ChipDesign111/chip_design/sw/README.md

# CPU 软件

[include/](include/README.md)、[drivers/](drivers/README.md)、[tests/](tests/README.md)、[startup/](startup/README.md)。
计划建立裸机构建与驱动：C/汇编→ELF→map/反汇编→hex→SoC。
原 Lab 预编译程序不等于自主软件已有构建链。关注 [存储预算](../docs/memory-budget.md)。
