ChipDesign111/chip_design/report/architecture.md

# 架构与数据流

my_soc_top 顶层仍为 clk_i、rst_ni、tck_i、tms_i、td_i、td_o 六个端口。CPU 指令、CPU 数据、Debug SBA、DMA 是四个 AXI 发起端；Boot、主 SRAM、Debug 映射、NPU 是四个目标端。保留完整 CPU 和调试互连。

CPU 指令端增加四条、每条八个 32-bit 字的取指缓存，数据容量共 128 B。缓存命中时当拍授权、下一周期返回；未命中通过 AXI INCR burst 填充，并预取下一条。仅物理 8 KiB SRAM 和 32 B 不可变 Boot 跳板允许缓存，Debug、Boot 状态寄存器等使用精确字地址的单次读取。SRAM 实际非零字节写入只撤销匹配的物理指令行（含地址别名），Boot 写入仍全局撤销；已发出的匹配填充事务继续排空，避免重装程序后使用旧指令。数据阵列不复位，valid、填充长度和输出仍复位，只有成功填充的字可返回。CPU 核本身未修改。

主 SRAM 8 KiB 保存程序、两层权重和工作数据。NPU 的配置寄存器保存最多 4 个输入、偏置和量化系数。开始一批后，硬件 DMA 自动读取第一层 32 个 tile，每块两列输入对应 32 个输出的权重；每块依次用于本批全部样本后才替换。第一层完成后用一个共享重定标器依次产生全部样本的隐藏值。第二层按每组 8 个逻辑 tile、48 B 有效权重打包，共 4 次粗粒度 DMA；核心仍按 32 个逻辑 tile 计算，内部产生每样本六个 INT22 分数和最大值下标，MMIO 再符号扩展为 32 位。

两个 64B bank 交替：一个计算、一个 DMA 写。DMA 用两字 FIFO 让读与写独立流动。为使短 MAC 发射段与真实传输重叠，下一块开始写入时再发射当前块；最后一个样本发射时立即释放当前 bank，下一 bank 已就绪则直接进入下一 tile，不经过固定 `DRAIN` 气泡。W1 tile31 仍占用一个 bank 时，另一个空闲 bank 开始预取 W2 组，因此 W2 首批传输藏在 W1 尾部和 requant 期间。没有增加空乘法器、复制整套权重或新增 NPU 内部 SRAM。

NPU 的真实执行周期受 AXI 仲裁与背压影响，读取计数寄存器获得；每样本 FC1/FC2 分别为 128/16 个 MAC 发射周期。启动保护默认关闭普通固件取指，完整镜像覆盖和密钥提交后放行；调试请求仍可在无镜像时进入 Debug 区域。细节见 [SRAM](sram.md)。

当前源码保留 AXI 交叉开关的 `CUT_SLV_AX` 地址通道边界及 `FallThrough=0`，用于控制 CPU 到 NPU 的组合路径。FPGA 工程已加入取指模块，但已有 bitstream 和历史 ASIC 物理结果不代表本次集成版本；需要从当前源码重新构建、实现和验证。
