ChipDesign111/chip_design/report/dma.md

# 权重 tile DMA

har_dma 是 AXI4 增量突发引擎；har_dma_axi 仅适配总线元数据。读 SRAM、写 NPU tile 窗口，AW/AR 独立握手，两字 FIFO 对读写速度差提供背压，不再先缓存完整 16 字突发才写。每次突发最多 16 字，跨 4KiB 边界自动拆分。 最后一拍 W 已接受且 R 已完成后即可接收 B 响应；完成和错误状态仍以真实 B 握手为准，省去额外 RESP 等待。32 字多次突发和跨 4 KiB 的 4+12 字拆分已加入定向回归。

NPU 发出自动描述符：第一层 src=W1_BASE+tile×64、len=16 字，共 32 次；第二层把 8 行、每行 6 个输出的权重连续打包为 48 B，src=W2_BASE+group×48、len=12 字，共 4 次；dst=0x70000100+bank×64。目的 bank 必须空闲。FC2 每个物理包直接供共享 MAC bank 完成 8×6 个乘积，不再是 8 个独立计算 tile。完整一批传输 2048+192=2240B，不因 batch=1/2/4 重复装多遍。下一批重新从 SRAM 装入，可由软件在批次间更新模型。

在本批所有样本用完当前 tile 前不会释放它。最后一个样本发射时产生消费脉冲；下一 bank 已发布时核心直接交接，没有固定空拍。另一 bank 预取可与 MAC 并行。W1 tile31 开始计算后，已释放的 bank 立即预取第一个 W2 组；W1 最后 bank 消费后预取第二个 W2 组，两者均可在 256 拍 requant 期间完成发布。块发布要同时满足预期字全部收到、DMA 完成且无错误。读响应错误、写响应错误、RLAST 不符都记错误，失败数据不发布。提前 RLAST 时用零补齐已发写突发后失败，避免破坏 AXI 已接收的写事务。真实 AXI 对端仍必须最终响应；硬件不臆造失联对端的完成信号。

调试 CSR 以 NPU+0xd00 为基准：0 控制 START/ACK，4 DONE/BUSY/ERROR，8 源地址，12 目的地址，16 字数，20 周期，24 已复制字数，28 错误码。CPU 手工 DMA 只允许 NPU 空闲；正常推理由自动描述符驱动。

当前完整 SoC RTL 测试观测到实际读/MAC 重叠 280 拍、写/MAC 重叠 280 拍。计数只统计总线完成握手且乘积有效的同拍，不把 BUSY 期间都当计算并行。
