ChipDesign111/chip_design/report/npu.md

# NPU 计算与缓冲

har_npu_core 第一层有 32 组、每组 2 个有符号 8×8 乘法器；第二层有 6 组、每组 1 个，共 70 个。当前优化版在一个 ISSUE 周期中完成乘法并写入 INT32 累加器，省去 1120 位乘积流水寄存器；目标 20 ns 是否满足由综合与布线后时序检验。样本数 1 或 2；同一权重块先用于样本 0，再用于样本 1，最后一个乘积累加完成才释放该块。

第一层总和经 ReLU（负数变零），乘 MULT 并按 SHIFT 舍入，再饱和到 0..127。一个共享 32×16 重定标乘法器依次完成 32 个隐藏结果。第二层保持有符号分数，Argmax 平局取最小下标。算术定义见 [数值契约](../model/numerics.md)。

har_weight_store 仅保存两个 64B 缓冲；simple_npu_top 检查 DMA 完整字掩码和成功响应，才将缓冲发布给计算。写入有效 bank 被拒绝；CPU 在计算或 DMA 忙时修改配置会置错误。层切换、重新开始和复位撤销旧有效标志。数据数组无复位，控制有效位保证不消费未初始化数据。

当前功能回归使用 [run.py](../test/int8/run.py)；随机数据和训练模型均逐值核对隐藏层、六个分数和类别。测试输出在本地忽略目录，不把旧版 39/59 周期或 38-bank 综合结论套到本实现。
