ChipDesign111/chip_design/reports/README.md

# 团队结果

当前无功能验证或 PPA 报告。每份正式结果包含 commit、模型/向量版本、工具、配置、命令、结果与限制。
个人已有报告仅是参考，不能作为共有代码的结果。完整波形和数据库不提交。
