ChipDesign111/chip_design/LICENSES/README.md

# Licensing inventory

许可证按组件管理，源文件声明优先。工程整理不会为第三方文件、模型产物或未明确授权的原创代码补写统一的宽松授权。

现有来源清单见 [THIRD_PARTY_NOTICES](../THIRD_PARTY_NOTICES.md)。平台文件保留原版权/许可头；数据固定样例保留引用与许可标记。仓库尚无所有原创文件的统一许可证决定，正式分发前需要补全该项。

添加许可证正文时应使用对应权利人的正式文本，标识其覆盖文件范围；不使用一个根目录 LICENSE 覆盖全部混合来源文件。
