ChipDesign111/chip_design/docs/ai-log/README.md

# AI 使用记录

每次影响设计的 AI 工作保存一份 Markdown：
日期、任务、使用的工具/模型、允许提供的输入、生成内容、人工修改、修改理由、验证命令、结果、关联 commit/PR。

记录方法学和关键改动，不把个人聊天历史整包上传。
禁止 AI 接触课程服务器 PDK、标准单元库等敏感内容。
初始仓库架构与计划由 AI 根据用户授权整理，当前只完成仓库结构和文档检查，未生成已验证芯片实现。
