ChipDesign111/chip_design/docs/weekly/README.md

# 每周共同验收

每周复制 [template.md](template.md)，按周次或实际日期命名。状态只填写已提供证据的结果，未执行项保留待办。
