ChipDesign111/chip_design/sw/include/README.md

# 软件公共接口

计划放寄存器常量、打包方法、驱动声明和类别映射。以 docs/mmio.md 和 model 输出为依据，避免三处地址不一致。
