ChipDesign111/chip_design/report/system_reset_boundary.md

# 系统复位边界修复

be4a7fc已实测消除Wire Bond 9条，但TT后仿仍有两条最终复位违规。原输入SHA保持不变的被动探针复现了相同事件。

19.85ns复位相位中，ndmreset_n于238905.903ns下降，AXI r_ready于238910.355ns下降；仍处READ状态的桥随之重新拉高req，主存D于238911.655ns上升，仅领先CP238911.659ns 4ps，小于10ps。
2ns相位中，ndmreset_n于238888.053ns下降，上游AR地址随后异步清除，req_addr[31]的D于238891.678ns下降，仅落后CP238891.643ns 35ps，小于77ps。共享SRAM复位直到238921.873ns才下降。
因此问题是生产端先复位、接收端仍活动的窗口，不能当成普通同步短路径加延迟解决。

用户已明确允许把最多两个下降沿的复位识别延迟扩展到CPU/AXI/NPU系统时钟域，要求时钟运行，保留独立JTAG TAP复位。
新实现先对外部POR与NDM请求分别作两级下降沿采样；POR和功能复位同步器在下降沿释放。POR断言来自已采样的下降沿请求，NDM断言也来自同样边界。
功能ndmreset_n同时控制CPU、AXI、NPU和SRAM桥/命令寄存器，不再只给SRAM接收端增加两拍。JTAG TAP的trst_ni仍直接使用外部复位，NDM不清除独立POR/debug域。
已接受的SRAM载荷不异步清除，上一上升沿接受的操作在随后的下降沿完成一次；新请求在共同复位后停止。

44组数据用例和完整SoC通过；新增完整SoC复位契约测试覆盖80个POR相位和80个NDM相位，验证两下降沿内生效、共同边界、启动保护及独立debug域。
原生SRAM时序检查开启的16个原始完整SoC复位相位全部通过，原生产SDF激励未改。便携/原生两模型各80相位320场景均为642次接受=642次实际写。
首次功能回归的旧“1ns立即断言”断言按用户批准的两下降沿接口契约更新，未改SDF激励或关闭时序检查。
75项硬件来源SHA检查继续执行，SoC原始/上游SHA保留，当前改动在integration override中解释。[功能证据](functional_validation.json)单列当前RTL，旧物理结果不用于验证它。

## 新版最终验证

dea5584已以干净源完成新Genus和34步物理实现，环境/EDA/整理/入口退出码全部0；917项回传SHA核验。综合68,703单元，cell面积2,064,513.940 µm²，含SRAM401,443.591 µm²。含PAD Die3.7956390976 mm²，原生Density75.129%。

TT静态Setup/Hold为+3.825/+0.115 ns。新TT17用例功能全过，绑定错误/缺失/全部阶段动态违规/负IOPATH截零均0。原先两条复位事件所处相位保留，未改生产激励、SDF、模型或检查。相同最终DB的多角最差SRAM输入半周期Setup/Hold为+1.951/+9.935 ns，输出+0.367/+10.879 ns（Setup取SS、Hold取FF−40，不作为TT专属数值）；共享功能复位至port_req_q/D为+6.714/+11.064 ns，报告含真实下降沿发射/上升沿采样及传播时钟。

新同源Lab5完成，WB64项0违规、最终天线0、完整LVS正确；课程DRC残项和按原生IO/外环几何核对的ERC残项保留，不称ERC Clean或完整代工厂签核。本轮只跑TT SDF；独立main RTL、Dummy后STA、IR/EM等没有因此被验证。

[完整最终结果及SHA来源](../eda/results/system_reset_unified_20261113/README.md)。20ns、3.8mm²与原生电气/几何规则保持。有限相位测试及静态分析不等于所有异步相位的亚稳态证明。

## 主线核心整合后的复核

main266bca3的16-MAC/INT22核心已经与本修复整合，并恢复main原生门控/使能与medium综合。新287ae40实际含443个自动门控及3282个受控FF，TT16个SDF用例的全部阶段动态违规0；不再靠禁用全部该类单元实现过关。原始模型、notifier与检查保留。[最终整合结果](../eda/results/main_266bca3_integration_20261113/README.md)。旧dea5584结果仍绑定其历史源码。
