ChipDesign111/chip_design/report/quality_followup.md

# 正常条件下的EDA与后仿修复结果

2026-10-27，物理输入4427c4b完成同源34步及环境/EDA/整理，均退出0；含PAD整颗3.7956390976mm²，20ns，四个匹配库角最差Setup/Hold+0.001/+0.020ns，TNS/违规路径0。随后415a43c运行脚本从同一物理输入完成TT、FF−40快角、SS125慢角三组17例后仿，各组功能、绑定和全阶段动态时序通过。报告及来源见[最终结果](../eda/results/native_mux_dff_20261027/README.md)。main仍d40b217，本轮后续提交仅在xzx。

## 验收范围

采用用户确认的[正常条件](../eda/docs/验收条件.md)：保留20ns、含PAD≤3.8mm²、四个匹配STD/IO/SRAM库角；Setup/Hold WNS≥0、TNS及违规路径0。遵守原生Liberty和讲义原SDC，正常default DRC、真实信号/核心供电连通、天线及交付复核。100ps Hold、120ps目标、200ps Setup、设计级人为边沿、逐引脚门禁、83/85分预算和手写扇出ECO已移除，没有重新引入。

## 为什么功能通过仍需要修复

RTL描述每个时钟边沿应该保存什么值，综合器决定用哪些实际单元实现。条件保持可以实现成独立时钟门控、带E使能触发器、借用SE扫描选择的触发器，或者普通DFF前的数据选择器。前几类的控制脚有独立setuphold检查；复位在周期中途改变使能时，可能数值计算仍通过，但控制脚已违反器件时序。

| 实现 | 实测结果 | 原因与处理 |
| --- | --- | --- |
| main对应5191064 | 原TT功能/静态/SDF通过 | 保留单TT基线，不能替代后来的四角实现 |
| 5b60015 | 四角静态通过，TT有6条最终复位事件 | Genus自动插入ICG的使能违规；新版本关闭自动门控 |
| cbf40f2 | 四角静态通过，TT仍有30条最终复位事件 | 26条主SRAM载荷E检查、4条字节写使能SE检查；禁独立ICG不足以禁库内控制结构 |
| 4ea3f0c | 实际仍有7405个EDF，所选mux_dff未生效；入口退出1 | 初始化前约束漏掉init_design后建立的MMMC库对象；未运行新SDF，完整目录转历史保存 |
| 4427c4b | 实际受控触发器0、自动门控0；三种SDF动态事件0 | init_design后重施原有映射，实际生成普通DFF加数据选择器，再独立完整重跑 |

本轮没有修改91项功能RTL，没有换掉原生STD/IO模型，没有修改SDF数值、屏蔽notifier、增加假路径或放宽周期/面积。寄存器映射策略在综合和后端统一应用，综合后核对实际网表；属性读回或小例成功不能代替完整SoC结果。

## 当前结果与限制

实际逻辑密度74.138%，综合单元面积2039855.258µm²含SRAM401443.591µm²。外框仍1948.24µm见方；规划/优化预算85%是参数，Filler后的100%不是逻辑密度。禁止门控可能增加时钟功耗，未做相同活动输入功耗比较，不宣称功耗改善。

同数据库SRAM半周期输入Setup/Hold+2.044/+9.876ns、输出+0.176/+10.917ns，传播反相时钟和0/10/20ns采样关系保留。三种后仿全程时序检查开启；TT负IOPATH截零18条、快角438条、慢角0条，快角另34条ANIOD消息，均单列工具限制。正常验收通过不表示完整延时无损或任意异步复位波形绝对安全。

核心物理852项和后仿67/67/76项已整包及逐文件SHA核验回传lab4新目录，大视图和授权模型仍在服务器。独立工艺DRC/LVS、完整RCmin/max、SI、IR/EM/ESD、形式等价未执行，不新增为本次教学门槛，也不冒称签核。所有开发自检和临时诊断工具仅在本地archives。

最新操作从[压缩上传到结果查看](../eda/README.md)和[后仿指南](../eda/docs/后仿真操作指南.md)开始；历史失败依据分别保留在[cbf结果](../eda/results/native_cbf40f2_20261027/README.md)及服务器history。不同版本未复用冻结work或拼接检查点。
