ChipDesign111/chip_design/docs/backlog.md

# 初始待办清单

当前条目未执行，不预分配成员。可逐项转换为 GitHub Issue，使用仓库任务模板。

| ID | 优先级 | 工作 | 前置依赖 | 验收 |
| --- | --- | --- | --- | --- |
| B01 | P0 | 加入四位成员、设置权限 | 真实账号 | 每人可克隆、提 PR |
| B02 | P0 | 确认官方模板公开共享范围 | 课程通知 | 来源与准入记录 |
| B03 | P0 | 导入共同平台源码与原测试 | B02 | 来源/许可证/校验明确 |
| B04 | P0 | 构建、仿真入口及 filelist | B03 | 从干净克隆运行 |
| B05 | P0 | 原平台回归与第二环境复现 | B04 | 共同平台验证摘要 |
| B06 | P0 | 数据/权重/64 特征与标签确认 | 课程资料 | 数据契约完整 |
| B07 | P0 | 浮点及整数参考、量化导出 | B06 | 可复现输出与准确率 |
| B08 | P0 | 评审规格、数值和 MMIO | B03,B07 | 文档冻结并记版本 |
| B09 | P0 | RISC-V 裸机编译与 hex 转换 | B03 | 简单程序端到端 |
| B10 | P1 | 有符号 MAC、偏置 | B08 | 边界和随机一致 |
| B11 | P1 | ReLU/量化、Argmax | B08 | 边界和平局一致 |
| B12 | P1 | 第一层和本地存储 | B10,B11 | 32 个中间值一致 |
| B13 | P1 | 第二层与完整控制 | B12 | 六个得分/类别一致 |
| B14 | P1 | MMIO 与驱动 | B08,B09 | 状态/数据读写一致 |
| B15 | P1 | CPU 驱动完整 SoC | B13,B14 | 连续推理端到端通过 |
| B16 | P1 | 早期综合与资源评估 | B12，课程工具 | 面积/存储/路径报告 |
| B17 | P1 | FPGA 适配与板级验证 | B15，Lab 6 | 真实样本上板一致 |
| B18 | P1 | 自主综合及布局布线 | B15,B16，Lab 4 | 完整实现及问题清单 |
| B19 | P1 | 优化、回归与签核 | B18，Lab 5 | 满足正式约束 |
| B20 | P1 | 评审、合版、GDS 与归档 | B17,B19 | 版本一致、问题关闭 |
| B21 | P2 | 四路并行方案 | 正确 V1 和实际瓶颈 | 收益有证据，回归通过 |

P0 为前置条件，P1 为交付主线，P2 为有余量时的优化。B02 未完成前，只协作原创文档和自有代码。
