ChipDesign111/chip_design/docs/decisions.md

# 决策与待确认事项

## 当前共同方向

| 编号 | 决策 | 状态 |
| --- | --- | --- |
| D01 | 使用 ChipDesign111/chip_design 为共有仓库 | 用户已确定 |
| D02 | 共有工程独立于个人 Lab，成果通过 PR 进入 | 用户已确定 |
| D03 | 人体活动识别，64→32→6 MLP | 根据已选场景，待正式项目公告核对 |
| D04 | 首版接收预处理特征，CPU 通过 MMIO 控制 | 建议，待评审 |
| D05 | 一个 MAC 的完整 V1，优化后再考虑四路 | 建议，待评审 |
| D06 | INT8/INT32 和 MMIO 窗口 | 草案，待参考模型及接口评审 |
| D07 | 当前不固定四人工作分配 | 用户已确定 |

## 阻塞功能开发的前置问题

- 数据、特征和权重是否由课程提供？
- 类别编号、归一化、量化规则是什么？
- 平台官方代码是否允许进入当前公开仓库？
- 四人课程登记、最终评分和截止是什么？
- FPGA、频率、I/O、存储宏和合版边界是什么？

## 决策记录格式

日期 / 提案 / 影响模块 / 证据 / 结论 / 替代方案 / 对应 PR。
接口冻结后更改必须给出迁移和验证方案。
