ChipDesign111/chip_design/docs/sources.md

# 来源与准入记录

核对日期：2026-10-08。

| 来源 | 用途 | 当前状态 |
| --- | --- | --- |
| [课程主页](https://full-stack-ai-chip.tianyuj.com/) | 发布状态和通知优先级 | 已核对 |
| [Lab 3](https://full-stack-ai-chip.tianyuj.com/lab-3/) | 共有平台的结构和仿真方法参考 | 已核对，尚未导入原包 |
| [Final Project](https://full-stack-ai-chip.tianyuj.com/final-project/) | 自主项目正式要求 | 尚未发布 |
| 课堂讲义《先进芯片全栈设计与实践（1）》第 18、19、26–28 页 | 暂定周次、流程和场景 4 | 根据提供内容制定计划，未上传 PDF |
| 成员个人 Lab | 学习和候选贡献 | 不自动导入，不作为共有 PASS |

网站显示 Lab 4–6 和 Final Project 尚未发布。后续以最新课程通知更新计划，当前不推断最终评分、板卡或频率。

## 源码准入模板

每项引入记录：名称、来源 URL/版本、获取日期、允许共享范围、原许可证、修改内容、文件校验值、验证入口、对应 PR。

课程文件名用于辨认结构，并不证明可以公开转载。本仓库初始内容是原创架构文档和工具，没有课程源码、个人报告、完整数据集或受限工艺文件。
