ChipDesign111/chip_design/eda/docs/Lab5操作指南.md

# Lab5：完整工程部署、仅执行新增物理检查

完整源包始终包含 RTL、综合、Innovus 01–34、TT 后仿和 Lab5 程序。workflow.json 定义各阶段必备文件，打包时逐项检查并记录 SHA；文件齐全不代表检查通过。

## 一键运行

```powershell
python eda/pipeline.py run --output C:/Users/zixiang/OneDrive/Desktop/advanced_chip_study/lab5/完整新流程目录
python eda/pipeline.py run --only lab5 --eda-upload /home/s2400011041/Desktop/fullstack_chipdesign/uploads/20261113_220745_287ae40 --output C:/Users/zixiang/OneDrive/Desktop/advanced_chip_study/lab5/仅Lab5新目录
python eda/signoff.py run --eda-upload /home/s2400011041/Desktop/fullstack_chipdesign/uploads/20261113_220745_287ae40 --output C:/Users/zixiang/OneDrive/Desktop/advanced_chip_study/lab5/本次新目录
```

pipeline默认依次执行RTL检查/SoC回归、综合与01–34、TT后仿及同数据库半周期STA、Lab5；--only lab5只调用最后一段。
`--start-at implementation`只省略命令内的RTL回归，保留来源检查并从全新Genus开始；若RTL已改，必须先完成并记录与该版本硬件SHA一致的功能/复位回归。本轮dea5584已在部署前完成对应回归，不能把此选项当作免验证。
2026-11-13最新版dea5584已完成新综合、01–34、TT后仿、同DB补充STA及Lab5；前版be4a7fc的两条TT复位事件单列为历史失败。

完整上传、公共unpack.sh校验解压后，只启动Lab5，不调用原run_all.sh重跑综合和布局布线。
run --detach只启动；status查状态；fetch --wait --output 新目录等待并校验回传。
--upload显式选择Lab5版本，eda/dist/last_lab5.json只保存本地最近位置。

## 本地/服务器分工

本地仓库维护正式程序、配置和文档；eda/dist保存忽略的部署包；工作区lab5保存核验后小报告；开发试验只在archives。
服务器每轮独立建立uploads/时间_lab5_提交/soc-stu/layout，从/lec/lab5/layout复制课程工程并记录所有原文件SHA。
deploy为完整冻结源码；lab5/config.json为冻结配置；lab5/inputs为原物理输入副本；lab5/evidence为命令、原始日志、摘要和SHA。
soc-stu/layout/workspace保存私有OA、GDS及检查数据库；results保存结果和回传包。原物理work及共享PDK保持只读。
规则、授权模型、大GDS/CDL、OA、SVDB不入Git。物理源码提交与本轮程序提交分别记录。

## 执行和真实结果

核对物理34步/三阶段0、相同RTL、完整包SHA、GDS层次，执行原生V2LVS。
随后私有preDummy装配、OA导入、preDummy DRC、两种Dummy、合并、最终OA导入、DRC、LVS/ERC、天线及WB串行执行。
几何自动化读取原生GDS中的edge/corner按1µm节距装配，不缩放、不flatten功能子层次，记录原生子单元元素计数。
按DEF测量尺寸并单列最终含环外框；POC锚点需在实际PVDD2CDG M3导体内。实现及解析必须经实际工具运行验证。
服务器依赖项目tools/lab5_python中的Python3.12、gdstk0.9.61、numpy2.2.6；原生Calibre/Virtuoso环境照常使用。
家目录含运行环境和预计产物须低于20,000,000,000字节，重任务串行，保留最新有效物理与TT结果。

## 教学例外

依据 https://full-stack-ai-chip.tianyuj.com/lab-5/ 保留原始DRC报告，单列DRM/ESD/MOM/LUP四类。
ERC不能按名字全部忽略，需核对实际IO保护电路或外环对象；核心浮井、真实开短路须修复。
`erc_review.json`核对原生结果总数、全部代表标记和最终GDS：mnpg标记须完整位于原生PVDD保护PAD内，nxwell/npvss49须完整位于PVSS1CDG内，外环psub须与实测环边界一致。
只将匹配的课程残项单列为`accepted_course_residuals`，保留原始计数和`erc_clean=false`；未知规则、标记不完整或核心标记均失败。这不是代工厂正式豁免。
PR先保留原始容差，确认实测偏差与教程同类后才采用有依据的教学设置。不新增SRAM Box、虚连或假标签。
converted、executed_review_required、review_required均非通过。报告解析不完整、几何需修正或ERC未审阅均非零退出并回传依据。
最终检查绑定同一SHA最终GDS/CDL。Dummy后寄生/STA、IR/EM及封装人工规则未做分别列未做。

## 回传

成功或失败均生成小包；本地校验包及逐文件SHA生成receipt.json。代码/配置修改必须新部署，不覆盖冻结任务。
最终验收后清理可再生成临时文件；结果说明更新eda/results及服务器入口，只推送xzx、不自动合并main。

2026-11-12实测见[Lab5结果](../results/lab5_20261112/README.md)：本轮完整部署、只跑Lab5，课程DRC/完整LVS/最终天线满足对应要求，原始PNR已有的WB9处仍未通过。中间失败版本已回传留证并清理，服务器保留最新相关物理、TT和Lab5三个目录。

最新版：[统一系统复位与Wire Bond最终结果](../results/system_reset_unified_20261113/README.md)。服务器入口README链接最新三个关联目录；Virtuoso最终版图位于最新Lab5的soc-stu/layout/workspace，库my_soc_top_final、单元my_soc_top_postDummy、视图layout。

当前最终版本：[main266bca3核心完整整合](../results/main_266bca3_integration_20261113/README.md)，物理287ae40、TT225252及Lab5225800同源验证。前述dea5584和2026-11-12记录仅作历史说明，不恢复已清理上传。

已有完整SoC回归可用`--rtl-regression-result 路径/result.json`；pipeline会核对完整RTL/test清单与每个SHA后复用，否则拒绝。默认仍重新执行回归，不豁免任何实现或后仿阶段。
