ChipDesign111/chip_design/eda/docs/实施与适配说明.md

# INT8 SoC 实施与适配

当前基线来自更新后的 main 267c873，活动分支 xzx。旧 xzx/rtl 的历史、未提交文档、RTL 和部分 EDA 结果已归档到本地工作区；不会放进本分支当作另一份实现。

## 计算与存储

网络为 64 输入、32 隐藏、6 类。设计实现 16 个 8×8 有符号乘法器。第一层分四个相位，每个相位用 2 条输入通道并行更新 8 个输出；第二层复用同一 bank，每次用 12 个乘法器并行更新 6 个输出。FC1 有 32 个物理 tile，FC2 有 4 个 48B 物理包。INT8 指输入、权重、隐藏激活；偏置、累加器和内部最终分数保持 INT22，MMIO 分数再符号扩展为 INT32，避免乘积求和被截成 8 位。

主 SRAM 是一个 8 KiB 原生硬宏，权重全部放在这里。第一层按 [32个输入对][32个输出][2个字节] 排列，共 2048B；第二层按 [32个输入][6个输出+2个零填充] 排列，共 256B。填充只为 32 位 DMA 对齐，不增加计算单元。

NPU 只有两个 64B tile 缓冲：当前 bank 供本批最多四个样本计算，最后一个样本发射时释放。另一 bank 由 DMA 写入；成功读写且收到全部预期字后才标记可用。FC1 和 FC2 的发布状态分开保存，因此 W1 尾部可以预取 W2，层切换不会丢弃提前完成的 W2 bank。DMA 为两字 FIFO，读、写通道独立推进，支持 AXI 背压；错误的读响应或 RLAST 使当前块失败，不发布半块数据。

批次最多四个样本，第一层和第二层分别按 tile 重用权重；FC2 每 8 个逻辑 tile 打包为 48B，W2 共 4 次 DMA。不保留旧版 38 个常驻权重 bank，也不保留 32 个并行重定标器；重定标器一个，依次处理各隐藏结果。双缓冲和打包不会消除主 SRAM 的 32bit/拍带宽瓶颈，实测周期应从寄存器和仿真取值。

## 改什么与固定什么

| 需求 | 修改位置与原因 |
| --- | --- |
| 仅换同形状模型 | 重新量化、按上述 tile 顺序打包权重；设置 SRAM 基址、MULT/SHIFT、偏置和输入，不改 RTL |
| 改网络形状、并行度或批次上限 | har_npu_core、simple_npu_top、权重布局/固件/参考模型一起改，重做功能和物理验证 |
| 改宏型号/容量 | memory 适配、filelist、宏逻辑/物理视图、宏坐标/供电规划和库清单一起改 |
| 改周期、核数、面积规划 | 第一次 check_env 前编辑本版本 configs/design.json；修改后新上传 |
| 允许优化器增加修复单元 | optimizer_max_density=0.85，统一传入原生优化器；这是优化预算，不是最终实测利用率 |
| 优化TT负IOPATH | combinational_cell_mapping=tt_nonnegative_tables，从未修改的原生TT库派生组合单元选择；Genus和Innovus统一应用，时钟反相使用原生CKND系列；最终仍须检查真实SDF |
| 增加慢角余量 | implementation_effort=high提高优化力度，setup_optimization_goal_ns=0.3给原生优化器软目标；不是最低余量验收门槛，最终仍按Setup/Hold≥0及零违规 |
| 为天线二极管预留扇出负载 | antenna_fanout_reserve=1：原生优化时逻辑目标15，布线前全设计DRV修复；每次优化后恢复原SDC16，最终检查/导出仍按16及原生天线规则 |
| 减少天线修复增加的负载 | antenna_repair_strategy=native_jumpers_first：先原生跨层跳接，仅对独立报告残项使用二极管回退；最终天线/扇出/DRC/STA仍全部复核 |
| 改顶层端口 | IO 计划、PAD 接线、SDC、物理端口及所有计数检查一起适配 |

本版io_plan.json的master字段明确PAD类型：输入PDDW0204CDG，TDO输出PDDW1216CDG。两者同为60×115µm且引脚几何、四库角逻辑相匹配，后者在当前外部连接上有更快边沿。更换PAD会改变门级时序和原生GDS引用，必须新上传、完整物理实现并用对应新SDF验证。不能只改网表字符串沿用旧SDF。

| 正常重复部署 | package_server.py、remote.py、unpack.sh、三个阶段和结果抓取程序可固定使用 |
| 正常重复实现 | 01–34 阶段控制可固定；从当前报告提取扇出/天线/时序修复对象，不能固定旧网名或旧余量 |

## 启动与复位

ASIC 上电后 SRAM 无初始化内容。CPU fetch_enable 由 boot_ready 控制，默认关闭；调试模块仍可通过 AXI 装载。装载者从 0x80000000 起按顺序写满 2048 个完整 32 位字，读回校验后，在 0x0001003c 写 0xb007c0de。硬件确认完整覆盖，再等 5 个时钟边沿才放行 CPU；CPU 从不可写的 BootRAM 跳板进入 SRAM。

乱序末字、部分 byte 写、仅写密钥、部分镜像均不构成完整覆盖。在 0x0001003c 写 0 可撤销启动并开始新镜像覆盖；安全重新装载应先通过调试接口停机或系统复位，不能把撤销 fetch_enable 当作已经运行 CPU 的硬复位。全局复位或 ndmreset 会清除启动许可，ASIC 需要重新完整装载。

复位采用异步断言、同步释放：POR/调试系统域四级，再到功能 SoC 四级。JTAG TAP 的复位保持在 TCK 域的原接口。非空 FPGA_INIT_FILE 表示 FPGA BRAM 在配置时预装载，该编译路径自动等待后放行；ASIC 默认空串，不能依赖仿真预装载。

## 面积与签核范围

3.8 mm² 指最外层 Die，包括 PAD；正方形边长上限约 1949.36 μm。默认请求1648 μm核心和四侧150 μm余量，即1948 μm外框，工具对齐后的实际 geometry、DEF/LEF/GDS 必须一致。综合单元面积、核心面积和整个 Die 是不同量。脚本先检查规划容积，再检查实际外框，不会为了通过把单元面积冒充整颗面积。

main的已验证结果采用TT 1.8V/25°C、50MHz，并有对应SDF动态检查。当前xzx同时优化TT25、SS125、FF0、FF−40匹配库角，仍在验证。完整导出不等于完成独立foundry DRC/LVS、多RC角或新版SDF后仿；各完成状态要从同一版本的真实证据分别判断。

验收使用native_library_zero_slack：保留四个匹配库角、系统20ns、含PAD整颗≤3.8mm²。最终Setup/Hold均要求WNS≥0、TNS=0、违规路径数=0，电气检查遵守原生Liberty及讲义原SDC；不增加设计级边沿限制。default DRC、真实信号/核心供电连通及天线须通过，IO抽象限制按同源原生几何证据记录。只在真实负余量时修复Hold：先0目标，仍有残项时按讲义尝试0.02ns优化目标；0.02ns不是验收门槛。普通优化密度上限统一0.85，不再分83%/85%预算。详见[验收条件](验收条件.md)。

移植SRAM端口时，AXI SRAM桥与my_mainmem须使用同一个sram_transaction_reset输出，SRAM桥QUIET_ON_RESET=1；裸异步根复位继续用于原CPU/调试域，不单独直通主存请求D。保持时钟运行及至少两个下降沿的根复位保持。新增模块已进入RTL文件表、内存源清单和FPGA工程源清单；完整物理及SDF必须使用对应新源码重新生成。
