ChipDesign111/chip_design/eda/docs/讲义34步与文件对照.md

# 讲义34步：每步的动作、文件与效果

本篇是[操作指南](操作指南.md)的后端查阅附录。先按主指南完成部署、prepare、doctor和综合，再选择“分段运行”；不要先运行完整all后，再从01把本篇命令全部执行一次。

这里的命令都在服务器Bash运行，沿用主指南保存的`EDA_WORK`，当前目录为`EDA_DEPLOY`。所有相对文件路径以本轮`$EDA_WORK/`为根；`flow/`是prepare冻结的控制程序，`pnr/generated/`是根据实际几何生成的Tcl。步骤用到的源模板为`flow/tcl/steps/`下对应编号片段，实际执行正文保存在`evidence/commands/步骤号/`。这些Tcl由入口调用，不需要你另开工具手工source。

`--until N`表示从最后通过点连续运行到N。每步Tcl和自动审计通过后保存`evidence/step_NN.json`并推进`evidence/last_step.txt`；`.enc`加载脚本及`.enc.dat`数据库必须成套保留。部分阶段JSON只列少量自动检查，具体范围结合Tcl保护、日志和本步说明阅读。

最终报告路径、字段含义和异常分析方法见[报告查找与分析](报告查找与分析.md)。下文的“预期”不是本轮实测值。

## 01．导入新门级设计

**用到的文件：** `config/global_define.tcl、pnr/scripts/pnr_mmmc.tcl、syn/my_soc_top/my_soc_top_postsyn.v`。分别提供工艺路径、分析模型与综合后的单元连接；flow/tcl/driver.tcl负责导入。

**在干什么：** 读入新版SoC网表、库外形与时间模型，并查找唯一主SRAM。

**为什么要做：** 网表只写连接，库资料才给出实际器件；先排除旧网表、缺模型和选错宏。

**有什么效果：** 设计名my_soc_top，主SRAM恰好一个，记录综合后真实实例路径。

**关键参数：** 顶层固定为my_soc_top，宏型号固定RA1SHD_2048x32M8；实例名从当前数据库查询，不照搬旧层次路径。

```bash
bash server/bin/eda.sh pnr --work "$EDA_WORK" --until 1
```

成功后查看`evidence/step_01.json`与`pnr/my_soc_top/backup/step01.enc`；后者需要保留配套.enc.dat。

## 02．确定核心与裸片尺寸

**用到的文件：** `evidence/floorplan_plan.json、config/design.json → evidence/geometry.json`。前两者给出计划尺寸与边距；geometry.json记录工具网格吸附后的真实裸片坐标，后续外围据此生成。

**在干什么：** 根据新综合面积和目标放置密度估算核心，再由工具建立合法行网格。

**为什么要做：** 含PAD整颗面积受3.8 mm²约束，先用当前综合结果确认能否装入核心，再检查网格吸附后的真实外框。

**有什么效果：** 生成floorplan_plan.json与geometry.json，后续外围统一使用实际Die尺寸。

**关键参数：** 当前默认core_size_um=1648、target_utilization=0.85、外围边距150 um；若自动规划也必须满足含PAD整颗≤3.8 mm²。core7T提供合法行网格，实际Die尺寸用于后续坐标。

```bash
bash server/bin/eda.sh pnr --work "$EDA_WORK" --until 2
```

成功后查看`evidence/step_02.json`与`pnr/my_soc_top/backup/step02.enc`；后者需要保留配套.enc.dat。

## 03．识别SRAM硬宏

**用到的文件：** `evidence/current_macro.txt、src/macro/RA1SHD_2048x32M8/`。文本记录唯一宏实例路径；宏目录提供已授权的尺寸、引脚、延时和几何视图。

**在干什么：** 查询宏的型号、实例名、尺寸和分类。

**为什么要做：** 型号是库里的模板，实例是本设计使用一次；后续放置必须找对具体实例。

**有什么效果：** 确认RA1SHD_2048x32M8并保存查询结果，尚不改变位置。

**关键参数：** `cell.size`是LEF定义的物理大小；`baseClass=block`区分硬宏与标准单元。RTL中预计为i_mainmem/i_sram/i_macro；综合可能改名，以本步数据库查询的唯一实例为准。

```bash
bash server/bin/eda.sh pnr --work "$EDA_WORK" --until 3
```

成功后查看`evidence/step_03.json`与`pnr/my_soc_top/backup/step03.enc`；后者需要保留配套.enc.dat。

## 04．保存插PAD之前的恢复点

**用到的文件：** `pnr/my_soc_top/backup/my_soc_top_prePad.enc 及配套数据库`。保存尚未加入PAD的恢复点。六个RTL端口只是接口对象，此刻没有六个已放置的信号PAD。

**在干什么：** 核对六个逻辑信号端口、确认尚无PAD，保存prePad。

**为什么要做：** 接下来要改变端口与内部网络关系，出错时可以恢复到清楚的基线。

**有什么效果：** 六路接口存在但六个PAD还未摆放；本步不是布局动作。

**关键参数：** `saveDesign`保存数据库及配套.enc.dat；保存文件名不是验收结论。此时尚未摆放六个信号PAD；第07步放位置、第08步接线，第09步另放供电/POC单元。

```bash
bash server/bin/eda.sh pnr --work "$EDA_WORK" --until 4
```

成功后查看`evidence/step_04.json`与`pnr/my_soc_top/backup/step04.enc`；后者需要保留配套.enc.dat。

## 05．摆放四角单元

**用到的文件：** `config/io_plan.json、pnr/generated/05.tcl`。IO计划与真实几何共同生成四角坐标；生成脚本负责创建和固定Corner。

**在干什么：** 在实际裸片四角放置PCORNER并固定方向。

**为什么要做：** 外围直线单元里的电源轨需要在角部转接，位置和方向都影响连通。

**有什么效果：** 四角均fixed且方向正确；这些不是需要计算功能的信号单元。

**关键参数：** 角块115×115 um；东/北边起点分别是实际宽/高减115，方向R0/MY/MX/R180必须与边别对应。

```bash
bash server/bin/eda.sh pnr --work "$EDA_WORK" --until 5
```

成功后查看`evidence/step_05.json`与`pnr/my_soc_top/backup/step05.enc`；后者需要保留配套.enc.dat。

## 06．把IO时间模型纳入分析

**用到的文件：** `pnr/scripts/pnr_mmmc.tcl、config/global_define.tcl`。给出核心、SRAM与IO时间库以及寄生模型，driver选择func_tt_io活动视图。

**在干什么：** 在核心与SRAM时间库上增加IO库，并激活func_tt_io分析视图。

**为什么要做：** 信号经过PAD也需要时间；只放几何而没启用时间模型会漏算延时。

**有什么效果：** Setup/Hold使用包含核心、SRAM与IO的同一单TT视图。

**关键参数：** library_set描述单元延时库，rc_corner描述导线RC，delay_corner把两者组合，analysis_view再加入constraint_mode。本流程明确-si_enabled false。

```bash
bash server/bin/eda.sh pnr --work "$EDA_WORK" --until 6
```

成功后查看`evidence/step_06.json`与`pnr/my_soc_top/backup/step06.enc`；后者需要保留配套.enc.dat。

## 07．摆放六个信号PAD

**用到的文件：** `config/io_plan.json、pnr/generated/07.tcl`。计划指定六个信号PAD的单元类型、边别与偏移；生成脚本把计划转为真实坐标和朝向。

**在干什么：** 按io_plan.json把clk/rst放北边，四路JTAG放南边。

**为什么要做：** 外部接口需要真实输入输出电路，不能把RTL端口名当作完整外围。

**有什么效果：** 五个输入PDDW0204CDG与一个TDO输出PDDW1216CDG都有位置且fixed，但下一步才接内部信号。后者是同尺寸的较强输出驱动，改善外部负载下的信号边沿；脚本核对每个实例的实际类型，不能只检查总数为六。

**关键参数：** 每个PAD60×115 um，北边R180、南边R0。沿边偏移取io_plan.json；北边y=实际高度−115，不能沿用旧1685.4。

```bash
bash server/bin/eda.sh pnr --work "$EDA_WORK" --until 7
```

成功后查看`evidence/step_07.json`与`pnr/my_soc_top/backup/step07.enc`；后者需要保留配套.enc.dat。

## 08．连接PAD与核心

**用到的文件：** `pnr/my_soc_top/my_soc_top_io_connected.v、flow/tools/audit_io_topology.py`。网表记录改接后的内外两侧网络；审计程序比较原有内部端点，防止漏接。

**在干什么：** 先记录内部单元引脚，再把顶层端口转到外侧网络，从原引脚找到拆分后的内部网络，连接PAD/C/I及控制脚。

**为什么要做：** 输入应先经过接收电路，输出应经过发送电路；原内部端点必须一个不漏。

**有什么效果：** 导出改接网表并与综合网表比较，六路外侧只连接各自PAD。

**关键参数：** 输入PAD：OEN=1关闭输出，IE=1开启输入，I/PE/DS=0。输出PAD：I接核心输出，OEN=0开启输出，IE/PE/DS=0。PAD是外侧端，C是接收输出，I是发送输入，不能混接。

```bash
bash server/bin/eda.sh pnr --work "$EDA_WORK" --until 8
```

成功后查看`evidence/step_08.json`与`pnr/my_soc_top/backup/step08.enc`；后者需要保留配套.enc.dat。

## 09．摆放供电与上电控制PAD

**用到的文件：** `config/io_plan.json、pnr/generated/09.tcl`。power_slots每边复用一次，创建28个供电/POC实例；并不移动第07步已经固定的六个信号PAD。

**在干什么：** 四边各放七个供电/POC单元，并按实际坐标登记IO侧别。

**为什么要做：** 后续外围填充依赖正确侧别；核心电源和IO电源的作用与网络不能混淆。

**有什么效果：** 新增28个单元，IO登记前后位置不变，角块/边别通过几何检查。

**关键参数：** 每边2个核心VDD、2个核心VSS、1个IO VDD、1个IO VSS、1个POC；默认沿边偏移600到1200 um。loadIoFile只登记指定对象，不调整Die。

```bash
bash server/bin/eda.sh pnr --work "$EDA_WORK" --until 9
```

成功后查看`evidence/step_09.json`与`pnr/my_soc_top/backup/step09.enc`；后者需要保留配套.enc.dat。

## 10．摆放键合焊盘

**用到的文件：** `pnr/generated/10.tcl、对应步骤的evidence/commands/10/`。脚本为6个信号PAD和28个供电/POC单元创建34个Bond位置；命令归档保留实际执行正文。

**在干什么：** 为六个信号和28个供电/POC单元放34个Bond PAD。

**为什么要做：** IO PAD提供电路，Bond PAD提供封装金线接触的大金属，两者需要对齐。

**有什么效果：** 34个键合焊盘与对应IO覆盖，这些预期覆盖区别于普通单元碰撞。

**关键参数：** Bond使用PAD60LU_OBV，沿边与对应IO一致；北/东边按实际尺寸和73.16 um深度计算，覆盖对应PAD是设计意图。

```bash
bash server/bin/eda.sh pnr --work "$EDA_WORK" --until 10
```

成功后查看`evidence/step_10.json`与`pnr/my_soc_top/backup/step10.enc`；后者需要保留配套.enc.dat。

## 11．绑定四个供电网络

**用到的文件：** `pnr/my_soc_top/my_soc_top_pg_bound.v、flow/tools/audit_io_topology.py`。网表显示四种供电网络的归属；审计防止核心电源和IO电源被误并。

**在干什么：** 把核心PG引脚与VDD/VSS绑定，普通IO供电端绑定VDDPST/VSSPST。

**为什么要做：** 网络归属先正确，后面金属供电才能接对；Tie常量输出不能代替电源。

**有什么效果：** 导出物理网表，逐个核对28个供电PAD、12普通端及四网独立。

**关键参数：** globalNetConnect是电气归属绑定，尚未画线。四网保持独立；N/S/W/E每侧vddio、poc接VDDPST，vssio接VSSPST。

```bash
bash server/bin/eda.sh pnr --work "$EDA_WORK" --until 11
```

成功后查看`evidence/step_11.json`与`pnr/my_soc_top/backup/step11.enc`；后者需要保留配套.enc.dat。

## 12．填充外围空隙

**用到的文件：** `pnr/generated/12.tcl、evidence/step_12.json`。脚本填补外围单元间的空隙；步骤记录与Tcl保护共同检查四边位置连续、朝向和覆盖。

**在干什么：** 在四边IO之间插入库规定的Filler并逐段检查。

**为什么要做：** 空隙可能使单元内部的外围供电轨中断，不能只看PAD数目正确。

**有什么效果：** 四边从角块到角块连续、无意外间隙/重叠且朝向正确。

**关键参数：** 候选宽度20/10/5/1/0.5/0.005 μm由库决定，工具自动组合；四边使用独立前缀，便于定位和有范围返修。

```bash
bash server/bin/eda.sh pnr --work "$EDA_WORK" --until 12
```

成功后查看`evidence/step_12.json`与`pnr/my_soc_top/backup/step12.enc`；后者需要保留配套.enc.dat。

## 13．固定主SRAM并留白

**用到的文件：** `evidence/commands/13/、pnr/my_soc_top/backup/step13.enc 及配套数据库`。命令归档保留SRAM放置与Halo设置；检查点保存放置后的实例和禁放区域。

**在干什么：** 按配置放置唯一主SRAM，增加Halo并核对实际四边留白。

**为什么要做：** 宏内部几何已固定，旁边要留接线空间；指定26不一定等于实际26。

**有什么效果：** 实际留白每边至少20 um，宏和留白在规划允许区域内。

**关键参数：** macro_xy_um默认(250,650)；Halo参数26 um用于补偿本宏LEF边界差异，最终实际四边留白仍必须至少20 um。

```bash
bash server/bin/eda.sh pnr --work "$EDA_WORK" --until 13
```

成功后查看`evidence/step_13.json`与`pnr/my_soc_top/backup/step13.enc`；后者需要保留配套.enc.dat。

## 14．建立顶层物理端口

**用到的文件：** `evidence/geometry.json、pnr/my_soc_top/my_soc_top_physicalPins.def`。前者规定十个物理端口矩形；DEF保存工具实际生成的矩形、层、方向和用途，供交叉核对。

**在干什么：** 为六个信号与四个电源接口创建明确的M4矩形。

**为什么要做：** 逻辑端口只表示接口名称，DEF/LEF/GDS还需要知道哪层金属、哪个位置。

**有什么效果：** 十个端口的矩形、方向和用途与当前geometry计划一致。

**关键参数：** 十个M4矩形均10×1 um，位置跟随实际Die与PAD偏移；五INPUT、一OUTPUT、四INOUT，电源USE正确。

```bash
bash server/bin/eda.sh pnr --work "$EDA_WORK" --until 14
```

成功后查看`evidence/step_14.json`与`pnr/my_soc_top/backup/step14.enc`；后者需要保留配套.enc.dat。

## 15．建立核心及SRAM电源环

**用到的文件：** `pnr/generated/15.tcl、pnr/my_soc_top/my_soc_top_pg_drc.rpt`。生成脚本建立核心供电环；DRC报告检查该阶段特殊金属的几何规则。

**在干什么：** 用M4/M5在核心和宏周围生成VDD/VSS环。

**为什么要做：** 供电需要较低阻抗的分配骨架，环提供后续条带和引脚接入目标。

**有什么效果：** 环的特殊布线DRC通过；此时还不表示所有单元已有金属供电。

**关键参数：** 上下M5、左右M4；核心宽10/间距2/偏移5，宏环宽4/间距2/偏移10，单位μm。selected限定宏环只围绕目标SRAM。

```bash
bash server/bin/eda.sh pnr --work "$EDA_WORK" --until 15
```

成功后查看`evidence/step_15.json`与`pnr/my_soc_top/backup/step15.enc`；后者需要保留配套.enc.dat。

## 16．铺设基础供电条带

**用到的文件：** `evidence/commands/16/、pnr/my_soc_top/backup/step16.enc 及配套数据库`。命令按当前宏位置建立局部供电环；检查点保留该金属几何。

**在干什么：** 生成M4纵向与M5横向VDD/VSS条带。

**为什么要做：** 只在边缘做环无法把电流送到内部，条带向核心深处分配供电。

**有什么效果：** 建立基础网格，线宽/间距/节距采用明确的教学工艺配置。

**关键参数：** M4宽2、双网间距1、同组重复间距20；M5宽4、双网间距2、重复间距30。break_at限制在block/outer ring处断开，不直接穿越被阻挡的低层宏几何。

```bash
bash server/bin/eda.sh pnr --work "$EDA_WORK" --until 16
```

成功后查看`evidence/step_16.json`与`pnr/my_soc_top/backup/step16.enc`；后者需要保留配套.enc.dat。

## 17．连接SRAM原生电源引脚

**用到的文件：** `evidence/current_macro.txt、evidence/commands/17/`。真实宏路径限定sroute对象；命令将宏电源引脚接到宏环，不凭同名网络假定已接通。

**在干什么：** 通过sroute把真实宏电源引脚接到宏环。

**为什么要做：** 绑定网络名不等于金属已接通；要尊重宏引脚层和内部阻挡。

**有什么效果：** 宏PG引脚归属正确并生成接入金属，保留查询记录。

**关键参数：** connect blockPin限定宏针脚；inst只选本轮按宏型号查询出的唯一SRAM实例；M3/M4为针脚范围，M3–M5为引出跨层范围。

```bash
bash server/bin/eda.sh pnr --work "$EDA_WORK" --until 17
```

成功后查看`evidence/step_17.json`与`pnr/my_soc_top/backup/step17.enc`；后者需要保留配套.enc.dat。

## 18．使用高层跨越SRAM

**用到的文件：** `pnr/generated/18.tcl、evidence/geometry.json`。脚本使用当前宏与裸片几何建立高层跨越条带。

**在干什么：** 在宏区域上方增加M6供电条带。

**为什么要做：** 宏占用了部分低层资源，需要合法的高层连接帮助跨越。

**有什么效果：** 按当前宏位置生成区域，使用VDD/VSS分别错开的高层供电。

**关键参数：** M6区域根据宏当前位置与固定宏尺寸生成；VDD/VSS错开，不能把高层跨越误当作穿越宏内部低层阻挡。

```bash
bash server/bin/eda.sh pnr --work "$EDA_WORK" --until 18
```

成功后查看`evidence/step_18.json`与`pnr/my_soc_top/backup/step18.enc`；后者需要保留配套.enc.dat。

## 19．补充宏附近横向供电

**用到的文件：** `pnr/generated/19.tcl、pnr/my_soc_top/my_soc_top_pg_drc.rpt`。生成横向条带后重新生成该报告；旧同名报告的历史副本在evidence/stage_reports/19/。

**在干什么：** 在宏区域生成M5横向条带并检查特殊布线。

**为什么要做：** 不同层之间需要过孔和合适接入，不能只看二维图有交叉就认为连通。

**有什么效果：** 补充网格并导出阶段DEF，特殊布线DRC通过。

**关键参数：** M5区域随宏位置移动；线宽4、间距2、组距30 um为当前教学工艺配置，最终看特殊布线DRC与连通。

```bash
bash server/bin/eda.sh pnr --work "$EDA_WORK" --until 19
```

成功后查看`evidence/step_19.json`与`pnr/my_soc_top/backup/step19.enc`；后者需要保留配套.enc.dat。

## 20．连接核心供电PAD与环

**用到的文件：** `pnr/generated/20.tcl、evidence/commands/20/`。生成PAD到核心环的连接命令，按真实裸片范围设置接入区域。

**在干什么：** 从16个核心供电PAD引脚接到核心电源环。

**为什么要做：** 外部供电必须经过实际PAD金属进入环，不能只在网表中同名。

**有什么效果：** 形成外围到核心环的金属连接，保留阶段连通/DRC报告。

**关键参数：** PAD接入区域使用实际宽/高减边缘余量，padPinSplit、M2到M5过孔范围遵循当前库，不把旧1720坐标写死。

```bash
bash server/bin/eda.sh pnr --work "$EDA_WORK" --until 20
```

成功后查看`evidence/step_20.json`与`pnr/my_soc_top/backup/step20.enc`；后者需要保留配套.enc.dat。

## 21．建立标准单元行电源轨

**用到的文件：** `pnr/my_soc_top/my_soc_top_pg_noDangling.rpt、evidence/stage_reports/21/`。前者是排除悬线检查后的阶段PG报告；归档保存引用报告，不能把此范围当成最终完整PG通过。

**在干什么：** 用M1沿单元行布置VDD/VSS轨并接到网格。

**为什么要做：** 每行标准单元都需要就近电源，只有高层环和条带仍不能直接供电。

**有什么效果：** 保留完整PG及排除悬线检查的阶段报告；最终步骤33仍要求完整PG清零。

**关键参数：** 行轨在M1，向M4连接；这里连通检查的noAntenna排除悬线检查，与步骤31的工艺天线检查不是同一件事。完整PG报告保留且最终重新验收。

```bash
bash server/bin/eda.sh pnr --work "$EDA_WORK" --until 21
```

成功后查看`evidence/step_21.json`与`pnr/my_soc_top/backup/step21.enc`；后者需要保留配套.enc.dat。

## 22．核对IO原生供电轨

**用到的文件：** `pnr/my_soc_top/my_soc_top_io_pg_connectivity.rpt、flow/tools/audit_native_io_rails.py、evidence/step_22.json`。报告列出IO抽象问题；程序读取当前库GDS的真实长轨与角部，记录仅限两种IO网的证据。

**在干什么：** 检查IO侧连通报告，并读取真实库GDS核对长轨截面和角部转接。

**为什么要做：** 本库LEF没有完整呈现部分原生轨，需要用真实几何与步骤12连续位置共同判断。

**有什么效果：** 仅对经验证的VDDPST/VSSPST两项抽象限制分类记录，不放过其他开短路。

**关键参数：** 先核对步骤12四边连续/朝向；解析原生IO GDS的M4长轨和Corner转角。该检查只覆盖所述轨几何，不代替全芯片独立LVS。

```bash
bash server/bin/eda.sh pnr --work "$EDA_WORK" --until 22
```

成功后查看`evidence/step_22.json`与`pnr/my_soc_top/backup/step22.enc`；后者需要保留配套.enc.dat。

## 23．插入Tap和去耦电容

**用到的文件：** `pnr/my_soc_top/my_soc_top_welltap.rpt、my_soc_top_postPhysCells_pg_drc.rpt`。均位于pnr/my_soc_top/；分别检查Tap覆盖和加入辅助物理单元后的供电几何。

**在干什么：** 按库规则插阱连接单元及Decap，绑定PG并复查。

**为什么要做：** 器件的硅体区域需要参考电压；去耦电容帮助缓和短时供电波动。

**有什么效果：** Tap覆盖规则和特殊布线DRC通过；这不代替供电压降分析。

**关键参数：** Tap cellInterval60、checkerBoard；verifyWellTap rule30对应该教学目标，不是独立核实的foundry签核规则。site吸附后间距59.920；Decap skipRow1隔行插入。

```bash
bash server/bin/eda.sh pnr --work "$EDA_WORK" --until 23
```

成功后查看`evidence/step_23.json`与`pnr/my_soc_top/backup/step23.enc`；后者需要保留配套.enc.dat。

## 24．放置标准单元

**用到的文件：** `pnr/my_soc_top/my_soc_top_place_check.rpt`。检查普通单元是否未放置或非法重叠；只有明确的IO/Bond覆盖会被分类保留。

**在干什么：** 运行place_opt_design，按连接与时序安排大量普通逻辑。

**为什么要做：** 既要放得下，又要给布线留空间并减少长距离连接。

**有什么效果：** 没有未放置或非法普通单元；仅保留明确的34组IO/Bond覆盖。

**关键参数：** preroute_as_obs={}避免将高层PG投影成整条禁放带；显式ignore_scan=true/reorder_scan=false。ignoreOutOfCore限定此标准单元检查范围，不豁免核心违规。

```bash
bash server/bin/eda.sh pnr --work "$EDA_WORK" --until 24
```

成功后查看`evidence/step_24.json`与`pnr/my_soc_top/backup/step24.enc`；后者需要保留配套.enc.dat。

## 25．给常量输入插Tie

**用到的文件：** `pnr/my_soc_top/my_soc_top_postTie.v、flow/tools/audit_io_ties.py`。网表显示常量驱动改接；程序核对六个PAD控制值、四供电网独立及排除端未误接。

**在干什么：** 先为PAD控制脚插常量单元，再插核心常量并排除12个普通供电端。

**为什么要做：** 常量驱动给逻辑输入提供0/1，不能误接到IO电源网络。

**有什么效果：** 细查六个PAD控制值、四网独立、供电端未被Tie取代。

**关键参数：** 先写12端排除表；keepExisting保持第一轮IO Tie；刷新PG、refinePlace，导出postTie.v。最终是否满足电容仍以RC报告为准。

```bash
bash server/bin/eda.sh pnr --work "$EDA_WORK" --until 25
```

成功后查看`evidence/step_25.json`与`pnr/my_soc_top/backup/step25.enc`；后者需要保留配套.enc.dat。

## 26．检查时钟树之前的时序

**用到的文件：** `pnr/my_soc_top/reports/preCTS/、evidence/step_26.json`。原始报告给出时钟树前Setup/Hold和电气摘要；JSON提取指标并标明这是阶段诊断。

**在干什么：** 分别计算preCTS Setup和Hold并检查核心PG。

**为什么要做：** 时钟树尚未真实建立，先定位估计线长和理想时钟假设下的问题。

**有什么效果：** 保存两类报告；早期残项被记录，最终是否达标在布线后重新判断。

**关键参数：** expandedViews展开活动视图结果；WNS/TNS、违规数量与Real/Total DRV要分开读。preCTS仍未包含最终时钟树和真实全部信号RC。

```bash
bash server/bin/eda.sh pnr --work "$EDA_WORK" --until 26
```

成功后查看`evidence/step_26.json`与`pnr/my_soc_top/backup/step26.enc`；后者需要保留配套.enc.dat。

## 27．定义时钟树与源模型

**用到的文件：** `evidence/commands/27/、config/constraints_my_soc_top.sdc`。命令规定时钟树源模型；SDC规定真实与虚拟时钟，虚拟参考不生成物理树。

**在干什么：** 为sys_clk和jtag_clk准备时钟树，设置源转换时间、电容能力和时间预算。

**为什么要做：** 同一时钟要驱动很多寄存器；外部源也有有限驱动能力。

**有什么效果：** 两路真实树有完整规格，虚拟JTAG参考不创建物理树。

**关键参数：** 仅sys_clk/jtag_clk是真实树；0.5 ns输入转换、5 pF源允许负载、0.47/0.2 ns Setup/Hold不确定度沿用已说明的首轮模型，不代表物理添加对应电容或延时。

```bash
bash server/bin/eda.sh pnr --work "$EDA_WORK" --until 27
```

成功后查看`evidence/step_27.json`与`pnr/my_soc_top/backup/step27.enc`；后者需要保留配套.enc.dat。

## 28．构建并分析真实时钟树

**用到的文件：** `pnr/my_soc_top/reports/postCTS/、my_soc_top_postCTS_place_check.rpt`。前者是树后时序报告；后者位于pnr/my_soc_top/，检查插入时钟单元后的位置合法性。

**在干什么：** 运行CCOpt，将真实时钟网络延时纳入Setup/Hold分析。

**为什么要做：** 时钟到各处不再完全同时；偏差可能帮助Setup却恶化Hold。

**有什么效果：** 保存树后检查点，放置合法，输出两类时序/电气报告。

**关键参数：** set_propagated_clock只作用于sys_clk/jtag_clk；timing_io_use_clock_network_latency always按讲义使用网络延迟。虚拟参考不传播。

```bash
bash server/bin/eda.sh pnr --work "$EDA_WORK" --until 28
```

成功后查看`evidence/step_28.json`与`pnr/my_soc_top/backup/step28.enc`；后者需要保留配套.enc.dat。

## 29．按当前报告处理树后Hold

**用到的文件：** `pnr/my_soc_top/reports/postCTS_holdFix_check/、evidence/commands/29/`。独立重查报告记录修复后的结果；实际命令归档能看出本轮是否执行条件修复。

**在干什么：** 只有当前报告需要时才做Hold优化，然后独立重查。

**为什么要做：** 新数据来得太早会破坏采样，可以加适当延时，同时保护Setup。

**有什么效果：** 保存实际修复后结果；pre-route估计残项不会被写成最终通过。

**关键参数：** 只按当前Hold报告决定是否运行修复，保护Setup；布线前估计残项明确记录，不假称最终满足。

```bash
bash server/bin/eda.sh pnr --work "$EDA_WORK" --until 29
```

成功后查看`evidence/step_29.json`与`pnr/my_soc_top/backup/step29.enc`；后者需要保留配套.enc.dat。

## 30．正式布线

**用到的文件：** `evidence/commands/30/、pnr/my_soc_top/backup/step30.enc 及配套数据库`。命令设置布线层与RC精度；检查点保存已正式布线的设计，后续提取据此计算延时。

**在干什么：** 按允许金属层执行时序驱动布线，连接真实信号网络。

**为什么要做：** 前面的连接估计还不是完整可制造的金属，正式布线会改变延时。

**有什么效果：** 生成正式导线和过孔，随后必须检查几何、连通、天线及真实RC。

**关键参数：** clock nets first优先时钟路由；postRoute low、tQuantusForPostRoute=false使用现有CapTable，不调用缺少Quantus techfile的medium设置；SI保持关闭。

```bash
bash server/bin/eda.sh pnr --work "$EDA_WORK" --until 30
```

成功后查看`evidence/step_30.json`与`pnr/my_soc_top/backup/step30.enc`；后者需要保留配套.enc.dat。

## 31．检查并修工艺天线

**用到的文件：** `pnr/my_soc_top/my_soc_top_postAntennaFix_antenna.rpt、my_soc_top_postAntennaFix_drc.rpt、my_soc_top_postAntennaFix_signal.rpt`。后三份均位于pnr/my_soc_top/；分别检查天线、默认几何规则和常规信号连通。

**在干什么：** 独立检查，再从本轮天线报告提取实际违规网，有限次修复。

**为什么要做：** 制造期间金属积累电荷可能损伤薄绝缘结构，不能复用旧违规网名。

**有什么效果：** 天线、default DRC和常规信号连通通过，保留原始和修复报告。

**关键参数：** 从当前独立报告提取违规网络，最多max_repair_iterations次，默认6次；不使用历史网名。两项IO抽象限制只有同源步骤22证据齐备才可分类。

```bash
bash server/bin/eda.sh pnr --work "$EDA_WORK" --until 31
```

成功后查看`evidence/step_31.json`与`pnr/my_soc_top/backup/step31.enc`；后者需要保留配套.enc.dat。

天线修复后还要看独立DRC，不能只看天线数字。如果选择网修复与相邻导线发生短路，控制脚本先把修复前DRC、天线、信号和PG报告存入 `evidence/route_repair/31/迭代号/`，再调用 `31_drc_fix.tcl` 的全设计 `detailRoute`。这个操作允许路由器协调冲突双方，重新检查相同四类报告；天线和DRC都清零才结束有限次循环，仍需通过独立阶段验收和后续最终时序检查。

## 32．真实RC下修复时序

**用到的文件：** `pnr/generated/32_initial.tcl、32_check.tcl、pnr/my_soc_top/reports/postRoute_holdAuto_check/`。原生全设计优化负责修复，独立报告核对真实RC下的Setup/Hold与库规则。

**在干什么：** 提取布线寄生，先按需要优化Setup，再处理Hold并独立重查。

**为什么要做：** 导线电阻电容会影响到达时间；布线前通过不等于布线后通过。

**有什么效果：** 两种时序违规与Real/Total电气DRV归零，否则停止，不自动放宽时钟。

**关键参数：** 优化器使用配置中的Setup/Hold target slack，当前为Setup 0.10 ns、Hold 0.05 ns。最终step33自动验收要求Setup/Hold WNS分别不小于这两个目标，且TNS、违规路径和Real/Total DRV均为0。目标只影响优化和最终门禁，不把原SDC周期改成目标值。

```bash
bash server/bin/eda.sh pnr --work "$EDA_WORK" --until 32
```

成功后查看`evidence/step_32.json`与`pnr/my_soc_top/backup/step32.enc`；后者需要保留配套.enc.dat。

不使用旧手写扇出ECO。实际扇出违规仍记录到当前报告，由原生优化处理；仍未清零时必须报告失败。

## 33．核心填充及最终复核

**用到的文件：** `pnr/my_soc_top/reports/postFiller/、evidence/step_33.json、pnr/my_soc_top/my_soc_top_postFiller_*.rpt`。分别保存最终时序原文、机器提取结论和放置/PG/DRC/天线/连通原文；最终性能以此步为准。

**在干什么：** 插核心Filler后修剪VDD/VSS多余线端，再重新提取RC，检查放置、完整核心PG、几何、天线和时序。

**为什么要做：** 填充后设计发生变化，要在最终状态验收；中途排除悬线的PG检查不够。

**有什么效果：** 最终各检查通过，保存可恢复的完整阶段点。

**关键参数：** ecoMode/fitGap按讲义匹配剩余空隙；check_signal_drc=true且add_fillers_with_drc=false，不允许为了填满而引入已知DRC。

`editTrim -nets {VDD VSS}` 是 Innovus 原生电源线修剪命令。电源条越过最后一个过孔或引脚后，可能留下没有负载的尾段；完整连通性检查会把这种尾段报告为 dangling wire（悬空线端）。修剪把尾段收回到最近的有效连接处，随后仍用包含悬线检查的 `verifyConnectivity` 检查所有核心供电引脚，不能靠过滤报告通过。第21步仍保留这些尾段，因为后续新增的物理单元可能需要接入；只在本步完成所有物理单元和Filler接入后修剪。任何真实断路、DRC或最终时序问题仍会使流程停止。

```bash
bash server/bin/eda.sh pnr --work "$EDA_WORK" --until 33
```

成功后查看`evidence/step_33.json`与`pnr/my_soc_top/backup/step33.enc`；后者需要保留配套.enc.dat。

## 34．导出并交叉核对

**用到的文件：** `pnr/my_soc_top/outputs/manual_final/、evidence/export_audit.json、evidence/step_34.json`。目录内是交付视图；两个JSON记录导出关系核对，不能代替独立晶圆厂签核。

**在干什么：** 导出DEF、两种网表、SDC、SPEF/SDF、LEF、合并GDS。

**为什么要做：** 后续工具需要连接、位置、时间和真实几何的不同表达，它们必须一致。

**有什么效果：** 核对十端口、尺寸、网表/SDF路径、寄生记录和GDS引用；不冒称独立工艺签核。

**关键参数：** GDS合并四套原生库输入，使用当前层映射和2000 DBU/um；SPEF/SDF取func_tt_io。检查尺寸与当前geometry.json一致，不硬编码旧实例数或GDS结构数。

```bash
bash server/bin/eda.sh pnr --work "$EDA_WORK" --until 34
```

成功后查看`evidence/step_34.json`与`pnr/my_soc_top/backup/step34.enc`；后者需要保留配套.enc.dat。
