ChipDesign111/chip_design/eda/docs/文件结构与功能说明.md

# EDA 文件结构与功能说明

从[操作指南](操作指南.md)完成打包、部署和运行，再用[报告查找与分析](报告查找与分析.md)分析自己的输出。单个后端动作查[讲义34步与文件对照](讲义34步与文件对照.md)。

```text
eda/
├── README.md
├── remote.py               本机打包/部署/等待/校验回传
├── package_server.py                本机生成服务器部署包
├── unpack.sh                        服务器顶层公共解压器，为每次上传独立解压
├── server/                          部署程序；打包时自动包含
│   ├── README.md
│   ├── entry/
│   │   ├── check_env.sh             独立环境检查与工程准备
│   │   ├── run_eda.sh               独立综合与布局布线
│   │   ├── collect_results.sh       独立报告、交付及小包整理
│   │   └── run_all.sh               只顺序调度上述三个阶段
│   ├── bin/
│   │   ├── eda.sh                   加载课程环境并调用流程
│   │   ├── flow.py                  准备、综合、后端、恢复、报告、交付
│   │   ├── review.sh                生成轻量结果回传包
│   │   └── workspace.sh             建立本次上传的入口和GUI说明
│   ├── config/
│   │   ├── design.json              库路径、周期、密度、宏坐标、修复上限
│   │   ├── io_plan.json             六个信号和四边供电/POC布局计划
│   │   ├── steps.json               34步目的及效果，供运行报告解释
│   │   ├── user_define.tcl          顶层、周期、工程/PDK路径、CPU数
│   │   ├── global_define.tcl        库文件、单元类型、金属层与工艺参数
│   │   └── constraints_my_soc_top.sdc 时钟、接口时间和路径例外
│   ├── syn/scripts/
│   │   ├── genus_synthesis.tcl      综合、映射、优化、报告及导出
│   │   ├── init_syn_standard_opt.tcl Genus设置、库读入和RTL展开
│   │   └── syn_mmmc.tcl             综合分析视图与约束组合
│   ├── pnr/scripts/
│   │   ├── init_pnr.tcl             导入综合网表、LEF和分析视图
│   │   ├── init_pnr_standard.tcl    Innovus工艺/布线/分析设置
│   │   └── pnr_mmmc.tcl             后端分析视图与约束组合
│   ├── tcl/
│   │   ├── driver.tcl               逐步运行和通过后保存检查点
│   │   ├── fanout.tcl               布线后按报告插缓冲分流
│   │   └── steps/                  讲义01–34的正式动作
│   └── tools/                       正式流程调用的运行模块，见下表
├── docs/                            主指南、报告分析、基础知识和适配说明
├── results/                         已完成实验的结果与分析
└── dist/                            本机生成的部署包，Git忽略
```

**正式运行模块的作用：**

| 文件 | 为什么需要 |
| --- | --- |
| `server/tools/generate.py` | 按实际裸片宽高、IO计划及宏坐标生成本轮Tcl |
| `server/tools/checks.py` | 读取实际面积、时间和物理报告，决定阶段是否达到验收要求；报告缺失不能按0违规处理 |
| `server/tools/audit_io_topology.py` | 检查插PAD改接后没有丢失原内部端点，四个电源网络独立 |
| `server/tools/audit_io_ties.py` | 核对PAD控制脚的常量及供电端未被Tie错误替换 |
| `server/tools/gds_audit.py` | 读取最终GDS结构、引用、单位及选定端口几何；不是独立LVS工具 |
| `server/tools/audit_native_io_rails.py` | 核对当前IO库原生供电长轨和角部，与实际外围连续布局共同判定两项库抽象限制 |
| `server/tools/light_delivery.py` | 生成轻量回传包；大型物理和寄生文件留远端并登记路径、大小和SHA |
| `server/tools/cleanup.py` | clean预览/删除明确列出的打包产物；也供打包流程清理暂存文件，不删除实现中间文件 |
| `server/entry/check_env.sh`、`run_eda.sh`、`collect_results.sh` | 三个独立阶段入口，分别准备检查、执行EDA、整理结果 |
| `server/entry/run_all.sh` | 只负责依次调用三个阶段并记录整轮退出码 |
| `remote.py` | 本机自动打包、独立上传、启动、状态查询及校验回传 |
| `server/tools/workspace.py` | 在本次uploads/版本目录生成README.html、run_env.sh、完整运行入口和结果摘要；不创建共享状态 |

这些模块是时序/DRC/连接验收与结果收集的一部分，会在正常EDA过程中执行。开发自检、测试数据、兼容性试验、跨工程检查点导入工具和原始参考模板不在分支内。

**部署后如何变为本轮工程：** prepare直接复制正式 `config/` 中的Tcl和 `syn/`、`pnr/` 脚本到新工作目录，写入本轮工程路径、PDK路径、周期和CPU数；不读取参考模板。源码复制到 `src/chip_design/rtl/`，完整授权宏复制到 `src/macro/`。控制程序快照在 `flow/`，后续调用使用该快照，同一工程不会随部署目录更新而改变。

| 本轮工作目录文件 | 作用与使用时机 |
| --- | --- |
| `config/design.json` | prepare时固定的本轮参数，不再随部署配置变化 |
| `config/user_define.tcl` | 本轮绝对路径、周期和CPU数，global_define通过PDK_ROOT定位工艺 |
| `src/filelist_syn.f` | 当前filelist源码的绝对路径及SYNTHESIS/CHIP_USE_RA1SHD开关 |
| `evidence/input_manifest.json` | 固定输入身份，保护同一工程的检查点恢复 |
| `evidence/doctor.json` | 实际使用库的路径与SHA，避免续跑混用变化后的库 |
| `evidence/floorplan_plan.json` | 真实综合面积驱动的核心规划 |
| `evidence/geometry.json` | 工具网格对齐后的裸片及派生端口坐标 |
| `evidence/step_NN.json` | 每步实际验收结果与原报告引用 |
| `evidence/commands/NN/` | 该步实际执行的Tcl，不是示例命令 |
| `evidence/stage_reports/NN/` | 被引用原报告的阶段副本，防止同名输出覆盖历史 |
| `evidence/运行报告.md` | 逐步解释、实际命令及本轮结果 |
| `pnr/my_soc_top/backup/` | 正常断点续跑数据库；enc与enc.dat成套保留 |
| `pnr/my_soc_top/outputs/manual_final/` | DEF、网表、时间/寄生和GDS等最终交付 |

`results/` 保存历史实测与原报告，不作为新工程的输入。正常复现从当前RTL开始；自己的新结果放对应上传目录内的work，按指南轻量回传到本地lab4，大型数据库和库文件不提交Git。

下载校验后可运行`eda.sh clean --work <目录> --dry-run`预览，再去掉`--dry-run`清理本轮交付压缩包及已知暂存文件。清单、报告、日志、中间文件、数据库和最终导出保留；清理不需要重跑EDA，也不会更新输入清单。

本轮实现优化还使用`server/tcl/native_optimization.tcl`：它把原生优化命令包在临时扇出预算中，为一个物理天线二极管负载预留位置，优化返回或报错后恢复讲义扇出16。`driver.tcl`负责调用与独立复核；`flow.py`把配置写入每个新版本并记录`optimization_goal.json`。该文件不修改具体网络、不改验收规则或原生模型。

`server/tcl/antenna_strategy.tcl`设置并读回原生路由模式，每次从实际天线报告提取待修复网络。`native_jumpers_first`优先跨层跳接，确有残项才让工具加保护二极管；时序ECO后再次复查。它不删除既有二极管，不修改工艺规则、RTL或SDF。临时策略报告保存在当前上传版本，不借用旧检查点作为正式结果。
