ChipDesign111/chip_design/eda/docs/验收条件.md

# 本次有效验收条件

这份文件对应用户确认：保留四个匹配库角，去掉代理额外增加的门槛。讲义基准：[Lab4](https://full-stack-ai-chip.tianyuj.com/lab-4/)，重点为27–34步和附录A6；四库角与面积要求来自本项目用户，覆盖讲义的单TT参考范围。

| 项目 | 本次要求 | 来源 |
| --- | --- | --- |
| 功能 | 完整CV32E40P、64+6个INT8乘法器、INT32累加、8KiB SRAM、两个64B tile、整批复用、DMA/计算并行、启动与复位保护 | 用户 |
| 时钟与面积 | 系统20ns；含PAD整颗Die≤3.8mm² | 用户 |
| 分析角 | TT25、SS125、FF0、FF−40的匹配STD/IO/SRAM库 | 用户本次确认 |
| Setup和Hold | 各活动角WNS≥0，TNS=0，违规路径数=0；显示−0.000而计数非零仍不通过 | 正常STA/讲义 |
| 电气规则 | 原生Liberty及讲义原SDC的转换时间、电容、扇出规则；最终实际和总违规均记录并归零 | 库和讲义 |
| 外部时钟模型 | 讲义0.5ns边沿、5pF允许驱动负载与原时钟不确定性；不为消除消息更改输入假设 | 讲义27步 |
| 物理 | 正常default DRC、布局合法性、真实信号和核心PG连通、天线复查；IO抽象残项保留同源原生几何证据 | 讲义31–33步 |
| 交付 | 同一源码完成34步、三个阶段正常退出、配套网表/SDC/SDF/SPEF/DEF/LEF/GDS；来源与文件完整性核对 | 可复现部署及讲义34步 |
| SDF后仿 | 功能正确、回标绑定完整、实际动态时序无违规；已定位工具/模型Warning保留说明，不以全部Warning为零验收 | 正常门级验证 |

不再使用100ps最低Hold余量、120ps Hold目标、200ps额外Setup目标、代理设计级0.3/0.5/0.6ns边沿限制、逐引脚分类门禁、83%/85%两套预算或手写扇出ECO。

原生优化先以0为Hold目标；若仍存在负Hold，按讲义32步尝试20ps优化目标。它不是验收门槛，最终+19ps可以通过，真实负余量不可以。85%是优化器预算和规划参数，实际逻辑密度单独报告。

后仿保留16组功能/复位相位SDF场景和一个无SDF功能对照；额外的启动诊断和故意制造PAD冲突的自测已移出正常矩阵。已定位原生输入PAD的时间0消息逐项保留，不要求恰好出现5条；正常运行中的真实总线冲突仍为错误。

RC使用供应的typical CapTable、原生低精度提取和实际角温度，不称为独立RCmin/max或SI签核。Calibre/IR/EM/ESD等未执行项目单独列明，不新增为本次教学流程的完成门槛。SDF导出仍不等于执行后仿。

2026-10-29用户另要求优化TT负IOPATH截零和慢角Setup余量。新配置的setup_optimization_goal_ns=0.3是原生实现优化的软目标，不是增加最低余量验收门槛；最终仍按上表WNS≥0、TNS0、违规路径0。TT归零是本轮优先优化目标，是否达到单独报告；不改SDF、原生库、检查或消息分类来伪造归零。实现选择及当前状态见[本轮优化](../../report/tt_setup_optimization.md)。

`antenna_fanout_reserve=1`只在原生优化期间预留一个物理二极管负载（逻辑目标15），随后恢复讲义扇出上限16。最终检查和导出SDC仍用16，天线规则保持，不增加15的验收门槛。该预算源于首轮16个功能负载加入一个天线二极管后产生17>16的实测违规。
