ChipDesign111/chip_design/eda/docs/当前设计数据流.md

# 从两个输入看懂当前设计

先把“数字怎么被算出来”和“电路怎么摆成芯片”分开理解。前者是 RTL/功能仿真解决的问题，后者是本次 EDA 解决的问题。

## 1．一次推理算什么

一份输入有 64 个有符号 8 位数，可以理解为处理后的一组传感器特征。第一层要产生 32 个结果：每个结果都把 64 个“输入×权重”乘积相加，再加自己的偏置。**权重**是模型训练得到的系数，**偏置**是加法中的常量。

第二层用这 32 个隐藏结果计算 6 个分数，每个分数对应一种活动。最终选择分数最大的下标。**隐藏层**就是两次矩阵运算之间的中间结果，并不是另外一个外部输入。

输入和权重范围 -128..127，这叫 INT8。两个 INT8 相乘需要最多 16 位，很多乘积再相加需要更宽的位置，因此用 32 位累加器。**MAC** 是 multiply-accumulate，即乘后累加；“所有数据 INT8”并不意味着把累加结果也截成 8 位。

第一层的负数先变成零，这叫 ReLU。随后乘一个整数并右移，把结果变回能放进 8 位的范围，这叫**重新量化/重定标**。结果过大时固定为 127，这叫**饱和**；不同于超出范围后绕回负数。

## 2．2×32 在实际做什么

假设第一层正在处理输入 x[0]、x[1]。32 个输出各有自己的两个权重，所以这一拍需要 32×2=64 个权重字节，同时完成 64 次乘法。下一块处理 x[2]、x[3]，仍更新同样 32 个输出。

总共有 64÷2=32 块。这里 **tile** 指可一次搬入、重复利用的一小块数据。本设计的第一层 tile 不是整个权重矩阵，而是两列输入对应的全部 32 行权重，总共 64B。

第二层每次拿一个隐藏输入，同时更新 6 个输出，因此是 1×6。一个 tile 有 6 个有用字节，加 2 个填充字节凑成两个 32 位传输字。32 个隐藏输入对应 32 个 tile；填充字节不会参加乘法。

## 3．为什么完整权重放主 SRAM

第一层权重 32×64=2048B；第二层实际权重 6×32=192B，带传输填充后是 256B。全部保存在同一个 8 KiB 主 SRAM，和程序、输入、偏置分配不同地址，不互相覆盖。

**SRAM** 是时钟驱动的片上随机存储器。这里的主 SRAM 使用工艺提供的硬宏：厂家已画好的存储阵列。若把整套权重写成大量通用触发器，加上同时读取不同权重所需的选择电路，会占掉较多标准单元面积。

现在 NPU 里只放两个 64B 小缓冲。**缓冲**是临时保存接下来要用的数据；**bank** 在这里就是一份能独立选择的小缓冲，不是另一整套模型。两份合起来只存 128B 权重。

## 4．DMA 怎么和计算并行

**DMA** 是直接存储器搬运引擎：CPU 告诉它源地址、目的地址和长度，它自己发总线请求。本设计由 NPU 自动产生每个 tile 的描述符，CPU 不需要每个字都执行一次读、一次写。

| 时段 | 缓冲 0 | 缓冲 1 | DMA / 计算动作 |
| --- | --- | --- | --- |
| 开始 | 正在装 tile0 | 空 | DMA 从 SRAM 读并写入缓冲0 |
| tile0 完整成功 | 供计算使用 | 正在装 tile1 | DMA 预取 tile1；MAC 使用 tile0 |
| tile0 所有样本用完 | 可释放 | tile1 已完整 | 计算切到缓冲1；DMA 在缓冲0装 tile2 |
| 后续 | 轮流填充/使用 | 轮流填充/使用 | 同样方式推进到 tile31 |

这种交替使用叫双缓冲或 ping-pong。正在使用的缓冲不能被下一块覆盖。“完整成功”不仅指最后一个字到达，还要求全部预期字和总线成功响应都收到；错误块不能供计算读取。

**批次**是一次一起处理的输入份数，本设计为 1 或 2。批次 2 时，同一 tile 先用于样本 A，再用于样本 B，两个样本的累加值各自保存，A/B 都用完才能释放。这样搬一次权重服务两份输入。这里不宣称支持旧版的大批次或许多常驻 bank。

**AXI** 是这些模块之间约定的总线握手协议。valid 表示发送者有数据，ready 表示接收者能接收，同拍都为 1 才算传输完成。接收者暂时不能接收叫**背压**，发送者必须保留数据并等待。

DMA 内部只用两个 32 位字的 FIFO。**FIFO** 是先进先出的队列，暂时吸收读 SRAM 与写缓冲的速度差；它让读写分别推进，而不是先存满整个突发再开始写。**突发**是一次地址请求连续传多个字。

## 5．CPU 为什么先不执行

真实 ASIC 的 SRAM 上电内容未知，里面不天然有程序。如果 CPU 一复位就跳进去，可能把随机内容当指令。这与仿真器提前读入 hex 文件是两件事。

现在 CPU 起初不取指，调试模块仍能装载。装载程序顺序写满 8 KiB（不用的地方也写零），读回确认，再写启动密钥。硬件确认完整覆盖并留出额外时钟余量后，CPU 才从固定的启动跳板进入 SRAM。**取指**就是 CPU 从存储器读取下一条指令；不是读取模型权重。

复位被拉低时立即停止相关状态，叫异步断言；拉高后等多个时钟边沿才放行，叫同步释放。这样各寄存器不会在外部复位刚变化时零散开始工作。它不能代替供电、时钟及真实芯片条件的签核。

## 6．六个信号怎样变成芯片外围

RTL 顶层的 clk_i、rst_ni、tck_i、tms_i、td_i、td_o 起初只是逻辑接口。保存 prePad 是保存“尚未加 PAD”的设计状态，并不表示六个 PAD 已经摆放。

步骤 07 才添加并固定六个信号 PAD；当前计划是北侧 clk 300 μm、rst_n 1400 μm，南侧 tck 250、tms 450、tdi 1400、tdo 1600 μm。offset 表示沿该边的偏移，具体外框坐标由实际 Die 宽高换算，源数据在 config/io_plan.json。

**PAD** 是连接芯片内部与外部封装的接口单元，不能用一根普通细导线直接替代。四边每边还摆 7 个供电/POC 单元，共 28 个，为核心电源和 IO 电源提供连接；它们不是另外 28 个计算输入。POC 是上电控制单元。随后添加键合焊盘和实际端口形状，所以“六路信号端口”和最终含四路电源的“十个物理端口”是不同阶段的描述。

## 7．3.8 mm² 到底看哪一个数

Genus 的 cell area 是库里单元的面积之和；Core 是放标准单元和 SRAM 的内部区域；Die 是包含外围 PAD 的芯片外框。用户目标按 Die 判断。

若外框约 1800×1800 μm，面积约 3.23.8 mm²；工具会吸附到合法网格，因此必须以实际 geometry 和最终输出再算。减少乘法器和寄存器，是为了让真实电路装进小外框；只改外框数字不能让过多的电路自动消失。

继续操作请看 [从部署到结果](操作指南.md)，每个物理阶段的原因和输出看 [34步对照](讲义34步与文件对照.md)。
