ChipDesign111/chip_design/docs/ai-log/2026-10-13-real-model-merge.md

# 2026-10-13 分支整合与已选模型联调

用户授权检查远端全部分支并尽量合并，要求使用 model 中的已选网络实测。
Codex 核对三远端分支及 PR #1/#2/#3，发现模型在已合入 main 的 #2，硬件分支缺同步；从 GitHub API 按 Git 对象 SHA 拉取，保留模型字节与 merge 历史。

解决 README/numerics/spec 三处冲突，保留现有硬件及训练模型。未改变 RTL、原课程文件、权重、偏置、量化系数。
新增安全 NPZ 导出/独立整数对照、真实模型 MMIO TB、循环 RV32I CPU 自检、运行/下载入口、六类真实输入固定样例及报告。未加载执行 pickled checkpoint，无需安装 Torch。

从 UCI 官方下载原测试集，仅保存到忽略的 data；24 条派生样例保留 CC BY 4.0 来源与原行号。2947 条全量准确率复算，5894 次 RTL 推理逐值一致，CPU 24 条通过，初始边界回归和结构检查重跑。
人工直接修改记录：本次没有收到人工编辑记录。用户明确授权合并，不声称存在其他成员已完成的人工作者评审。

没有访问 PDK、标准单元库或服务器工艺数据。算法识别误差和硬件计算差异分开记录；原测试集用于 checkpoint 选择的限制已说明。最终 GitHub 合并/CI 状态由工具核对。
