ChipDesign111/chip_design/docs/ai-log/2026-10-13-tiled-npu.md

# 2026-10-13 tile / 流水 NPU AI 记录

用户要求：64→32→6 MLP，tile、并行、两级流水、片上存储，第一层 tile 数为第二层两倍，完整 SoC 验证。
Codex 使用用户提供的项目和公开文档、本地 Icarus/ModelSim/Yosys/Git/API；未访问服务器 PDK、标准单元库或商业工艺数据。

实现：FC1 两个 16×4 tile，FC2 一个 6×2 tile；两层均发射 16 个分块，活跃各 19 拍。同步权重 bank、有效位复位、产品寄存器/累加流水、hidden 双缓冲、双样本 MMIO、CPU 自检与周期计数。整数参考保持不变。

配比解释：工作量 2048:192，同形 tile 配 2:1 不能平衡；采用不同形状保持数量 2:1，同时实现吞吐约 10.67:1。

开发修复：Icarus 对生成块局部循环/共享组合数组敏感性处理不佳，改为显式连续加法链；旧周期断言依据独立周期推导更新为 39/59。Yosys 内存寄存器合并后需 opt_clean 清除中间悬空线，再执行 check；没有忽略结构错误或更改原课程测试。

验证：1000 参数组分别单/双推理共 3000 次；12 MMIO，原四 SoC 镜像，新 CPU 八次及六次性能程序；同步存储和通用综合结构检查。证据见 reports/tiled-v2.*。
目前没有人工直接编辑或审查记录，不声称已人工复核。真实模型、目标综合/频率/面积、FPGA 和 ASIC 待完成。

复现修复：旧版 Yosys 会把含空格的绝对源文件路径写入 RTLIL 标识符并拒绝，综合脚本改为以仓库为 cwd 的相对源路径。该修正不改变 RTL。独立带空格 checkout 的单元测试与综合结构检查作为附加复现。
