ChipDesign111/chip_design/docs/archive/weekly/README.md

> 历史记录：内容反映记录时的项目状态，不作为现行接口或发布规范。参见 [工程文档](../../README.md)。

# 每周共同验收

每周复制 [template.md](template.md)，按周次或实际日期命名。状态只填写已提供证据的结果，未执行项保留待办。
