ChipDesign111/chip_design/docs/archive/ai-log/2026-10-08-lab3-har-v1.md

> 历史记录：内容反映记录时的项目状态，不作为现行接口或发布规范。参见 [工程文档](../../README.md)。

# 2026-10-08 Lab 3 / HAR V1 AI 记录

请求：固定 Lab 3 外围，仅 NPU 可变，基础实现并完成相关回归。
工具：Codex、Python/Git、Icarus、ModelSim、GitHub API。
输入：用户选定 Lab 3 文件、课件 HAR 要求及仓库草案。未访问课程服务器 PDK 或标准单元库。

AI 生成：两个 NPU、整数参考、合成向量、新 TB、RV32I 生成器、运行入口与报告。原外围/测试按字节导入。

人工修改：本次没有收到人工直接编辑 RTL 的记录，不声称已人工审查。团队通过 PR 复核数值、状态和来源。

开发修正：首次 Tcl 镜像参数包含多余花括号，SRAM 未装载；修正调用后完整重跑，四原镜像及 HAR 均 PASS。最终报告只对应通过版本。

验证：--unit 1000 核例/12 MMIO，--soc 四原镜像/六次 HAR 推理，90 文件 SHA 校验。见 [报告](../../../reports/history/baseline.md)。真实模型、FPGA、ASIC 未验证。
