ChipDesign111/chip_design/report/tt_setup_optimization.md

# TT负路径与慢角Setup优化

本轮从2026-10-29按用户延后5小时的要求启动。优先让TT负IOPATH截零消息由18降至0，并增大SS125 Setup余量；同时观察FF−40的438条截零是否减少。基线4427c4b已通过正常教学EDA/SDF，不覆盖或篡改它的原始结果。ASIC基线来自main d40b217，后续只提交xzx。远端main另有FPGA更新至99aa863，ASIC RTL树保持一致；本轮未修改或合并main。

## 已定位的基线问题

TT原始SDF中有18条负IOPATH弧，涉及16个组合单元。INVD1有5条、INR2D1有8条、AOI21D0有1条、MUX2ND0有3条、NR2D1有1条；同一MUX的无条件及两个条件弧分别计数。最负约−0.030ns。原始库表也包含负值，因此不能靠把SDF数值改成0、删除弧或关闭检查宣称解决。

同数据库原生路径报告显示，例如CPU CSR通路的g36996由约1.227ns边沿驱动，输出负载约0.003pF，其单元延时约−0.022ns。缓慢输入、轻输出负载时，输出跨过计时阈值可能早于输入跨过阈值；这属于原生时序模型，不能直接解释为逻辑功能错误。其余实例、原始弧及数值见[基线清单](../eda/results/tt_setup_optimization_20261029/baseline.json)。

慢角最差路径由CPU ID阶段alu_operand_b_ex_o_reg[16]经过ALU加法链回到mult_operand_c_ex_o_reg[27]，Setup为+0.001ns。此前最差Hold为FF−40的+0.020ns，不能只修Setup而忽略快角Hold。

## 这一轮改什么、为什么

1. `combinational_cell_mapping=tt_nonnegative_tables`：从服务器未修改的原生TT Liberty读取组合单元cell_rise/cell_fall表，暂不选用含负表项的组合单元；使用同一库中其他单元重新实现原布尔逻辑。该选择在Genus初始化前后及Innovus创建/恢复后统一应用，记录原生库SHA和实际应用。它改变实际网表及版图，不改原生模型或SDF。实际工作点可能发生插值/外推，所以表筛选不等于已证明最终SDF负弧为0，必须重新实测。
2. `implementation_effort=high`：提高综合及摆放时序优化力度，为完整四角实现寻找更好的逻辑与布局选择。功能RTL、时钟周期和外部模型保持。
3. `setup_optimization_goal_ns=0.3`：响应用户增加余量的要求，给原生优化器一个可调软目标；布线后额外执行一次原生全设计Setup优化。**0.3ns只是优化目标，不是验收门槛**；最终Setup/Hold仍按WNS≥0、TNS及违规路径0检查，不放宽20ns、3.8mm²或任何真实违规。

关闭自动门控、mux_dff以及全部复位/时序检查保持，防止重现历史ICG、E/SE最终复位违规。完整CPU、70个INT8计算单元、DMA/双tile和启动保护均保留。当前没有修改RTL；如果后续必须修改，将重新做适当的完整功能/复位回归并记录来源。

## 当前验证状态与后续

原生工具预检已完成：从TT库识别114种含负表项的组合单元；Genus初始化后对456个库角对象应用选择，小例实际网表不再包含被排除的单元。Innovus对114种物理主单元应用同一选择，Setup优化目标0.3ns读回约0.2999ns（工具精度）。同基线数据库还完成了16个负弧输入的真实边沿、负载、阈值和波形计算报告。原始开发日志仅本地archives，不进入分支。

第一轮a3c2141的完整SoC综合已实际得到68603个单元、2062766.560µm²单元面积（含SRAM401443.591µm²）；自动ICG、受控触发器及被排除组合单元实际实例均为0。候选32步Setup为+0.305ns、Hold显示+0.000ns，TNS及违反时序路径为0，Die仍为3.7956390976mm²。但原生电气检查发现一个真实的17>16扇出违规，环境退出0、EDA退出1，只有31步通过独立审核，因此**本轮实现未完成，也未运行新SDF后仿**。不能将这组候选数字当成完成后的改善，详见[失败依据](../eda/results/tt_setup_optimization_20261029/a3c2141_failure.json)。

违规网络原有16个功能负载，布线天线修复加入ANTENNABWP7T二极管后变为17。原生工具独立试验确认，即使设置fixFanoutLoad=true，postRoute阶段仍明确输出“Disabling fanout fix in postRoute stage”，追加一次原生DRV优化仍留下同一违规。因此不采用无效的后端重复修复，也不删二极管、改其模型或放宽原SDC的16。

后续修复使用`antenna_fanout_reserve=1`：原生布局/CTS/时序优化调用期间，将逻辑扇出目标设为15，为一个物理天线负载预留位置；29步布线前调用全设计`optDesign -postCTS -drv`，由原生工具选择缓冲结构。每次优化退出（包括错误）均恢复讲义的16，再独立生成检查报告、保存检查点及导出SDC。它是由实际二极管负载引出的实现预算，**不是新增验收条件**；最终天线与扇出16仍同时检查。脚本不指定网络或手工插接缓冲器。其面积、时序、天线和SDF影响必须通过新的干净上传、完整综合和34步验证。

独立、不保存数据库的原生试验已验证这个负载预算的作用：数据网络在15目标下无扇出残项；712个原有CTS输出仍为16，恢复讲义16后全设计扇出检查为0违规，未对时钟放宽限制。不过直接在旧布局中改树后，Setup降到−2.814ns、Hold降到−0.559ns，**这不是可交付实现**。新版本从布局/CTS开始使用该预算，并在29步对真实Setup/Hold残项有界重优化；只有重新完成四角静态、物理及三组SDF，才判定修复有效。开发试验的脚本和原始日志只保存在本地archives。

[首轮部署身份](../eda/results/tt_setup_optimization_20261029/deployment.json)保留原始输入SHA；修复版的独立部署另行记录。基线4427c4b继续作为已完成结果保留。

修复版ae532fa已干净提交并推送xzx，独立部署至`uploads/20261029_091711_ae532fa`，195项部署文件SHA全部匹配，环境退出0，完整SoC综合已完成：68603个单元，单元面积2062766.560µm²（含SRAM401443.591µm²），实际自动ICG、受控触发器和被排除TT组合单元均为0。实测含PAD整颗Die为3.7956390976mm²。之后独立通过29步（Setup+0.303ns、Hold+0.000ns、电气0违规）并完成布线，但32步仍因一项真实扇出17>16停止，环境0、EDA/总入口1，没有新SDF后仿。[本次部署身份](../eda/results/tt_setup_optimization_20261029/deployment_ae532fa.json)记录实际物理输入、压缩包及逐文件清单SHA。首轮失败目录完整归档到`history/retired_tt_setup_20261029`，不续跑其检查点。新结果未验收，TT负IOPATH是否归零仍待本次新SDF实测。

## 第二轮失败的具体原因与修复方向

[ae532fa失败依据](../eda/results/tt_setup_optimization_20261029/ae532fa_failure.json)表明，这次超限的是CPU加法树相关网络：15个功能负载，加上原生天线修复插入的DIODE_30与DIODE_31，总负载为17。候选32步Setup+0.300ns、Hold+0.000ns、TNS及违规时序路径均为0，但原SDC扇出上限仍是16，因此不能交付或开始正规后仿。天线保护二极管数量随实际线形变化，固定预留一个负载不能保证所有网络通过。

天线效应是制造中导线积累电荷可能损伤所连接栅极的问题。原生跨层跳接可以改变制造过程中的金属连接面积；保护二极管提供泄放路径，同时也增加电气负载。两项规则必须同时满足，不能靠删除二极管、修改其fanout_load、取消天线检查或放宽16来过关。

纯跨层跳接的原生临时试验得到DRC和扇出0违规，但仍有一条独立天线检查：METAL2侧壁面积比409.5884，大于原规则400。连续跳接仍未消除，故不采用“全程禁止二极管”的方案。

新策略`antenna_repair_strategy=native_jumpers_first`：一般路由先使用原生跨层跳接；对独立天线报告中的当前残项先尝试两次跳接，仍不满足时才允许原生路由器对残余网络补二极管。网络清单每次都来自当前报告，不写死失败网络。保留原生天线、电气和DRC检查；时序ECO改变线形后也重新执行这项几何修复，再生成独立STA/物理报告。`antenna_strategy.tcl`负责策略设置、真实读回、当前报告解析与有界修复，不改RTL、库表或SDF。新旧输入分开，临时数据库不作为正式续跑点。

原生临时路由试验已验证该顺序：仅在残余网络增加1颗二极管，独立天线、default DRC及原16扇出检查均为0违规。实际工具读回也确认jumpers_first默认禁止自动加二极管、跨层跳接开启，旧策略仍允许二极管。没有删除任何已有二极管或改工艺规则。

临时数据库原生导出的TT SDF负IOPATH弧为0，PVT文件负弧为85（基线原始PVT文件为472）。**这是诊断文件的负弧统计，不是VCS截零消息计数，更不是正式后仿通过**；完整新版本仍须从综合重跑、完成时序与33步Filler后的供电尾段修剪，再执行三组VCS。临时路由仍有46条最终修剪前的PG尾段及2条IO抽象信息，均未据此冒称全物理流程完成。原始试验与临时SDF只在服务器临时目录生成并清除，统计和开发日志留本地archives。

另将32步仅剩扇出问题时的重复Setup优化提前停止：已确认原生postRoute不支持扇出修复，重复五遍不能解决它。停止的是无效重试，最终原16扇出门禁仍会报失败，不豁免任何超限。默认旧配置仍使用原生跳接加二极管策略，避免改变历史输入解释。

## 当前正式重跑版本

0d48a66已提交并推送xzx，以干净源码包独立部署到`uploads/20261029_115755_0d48a66`，196项部署文件SHA全部匹配，环境退出0，已重新从Genus综合开始。它采用上述“跳接优先、残项原生二极管回退”策略，并在每次postRoute时序优化后复核天线，再进行独立检查。部署身份见[新正式输入](../eda/results/tt_setup_optimization_20261029/deployment_0d48a66.json)。ae532fa失败目录已完整移至history留证，未修改其冻结输入，也未把任何临时数据库接入正式流程。新的四角物理结果及三组VCS尚未完成，临时TT负弧0不能代替它们。

新物理正常通过后，对同一数据库串行运行TT、FF−40和SS125，每种16组SDF与1组独立零延时对照，保留全部检查和原复位相位；另核验SRAM真实半周期路径。最终对比TT截零条数、负值范围、SS Setup/Hold、面积及三组功能/动态结果。若原生工具或模型仍限制TT归零，列出实测对象和剩余影响，不把Warning降级或无损支持标记修改当成优化。

正常验收条件见[验收条件](../eda/docs/验收条件.md)，打包上传和三个独立阶段见[操作指南](../eda/README.md)。开发探针、临时脚本和原始诊断日志只保存在本机archives；分支保存正式部署文件及正常结果分析。

## 0d48a66正式结果与新的复位修正

0d48a66完成同源34步和三个阶段0，894项轻量文件核验，整颗3.7956390976mm²。四角Setup/Hold分别为TT+4.138/+.018、SS125+.290/+.070、FF0+5.793/+.008、FF−40+5.965/+.000ns，TNS及违规路径0，最终电气/物理门禁通过。[物理摘要](../eda/results/tt_setup_optimization_20261029/physical_0d48a66_summary.json)记录本次身份。

TT新SDF的17个功能场景均通过，截零0，回标缺失/error0；但1650ps最终复位场景的port_req_q_reg有1条D Hold事件，[真实审核](../eda/results/tt_setup_optimization_20261029/postsim_0d48a66_tt/audit.json)仍为normal_postsim_pass=false。因此没有继续该旧RTL的快/慢角。用户要求先对齐波形再修复，现已证明该事件来自内部异步复位的D传播，正在以[共享事务复位边界](port_request_reset_fix.md)修正RTL并重新全流程。新RTL已通过联合接口和完整SoC功能/复位回归，新的物理与SDF尚未完成。
