ChipDesign111/chip_design/docs/archive/ai-log/2026-10-08-change-guide.md

> 历史记录：内容反映记录时的项目状态，不作为现行接口或发布规范。参见 [工程文档](../../README.md)。

# 2026-10-08 修改边界与验证指南

用户要求写清可改区域、修改步骤及验证方法。Codex 根据当前源列表、冻结校验和测试入口编写 docs/change-guide.md，并同步目录说明、导航、贡献规范和 PR 模板。

输入为仓库公开源码及已验证功能基线；没有访问 PDK、标准单元库或新增课程材料。没有改变 RTL、算法、测试程序或运行脚本。文档明确区分基线结果与后续变更验证，避免旧报告被当作新版本证据。

验证：python scripts/check_repo.py、python scripts/check_platform.py、git diff --check。仅改文档，硬件测试采用已有基线证据，不声称本次重新运行商业 SoC 仿真。GitHub CI 仍自动执行单元回归。

尚无人工修改或评审记录；共同评审通过后再合并。
