ChipDesign111/chip_design/verification/unit/README.md

# Operator test boundary

No standalone operator testbench is currently compiled from this directory. Arithmetic boundary coverage is supplied by tb_har_core and the independent integer reference.

Extracted operators should gain focused tests here while preserving full-network and SoC regression.
