ChipDesign111/chip_design/eda/results/quality_baseline_20261027/README.md

# main合并后的历史质量验证基线

本目录仅保留历史证据。用户已取消其中额外100ps Hold、人为边沿及200ps Setup目标，当前验收以[新条件](../../docs/验收条件.md)为准；历史数字不改写成新结果。

main已合并并推送d40b217。下面是对该版实际物理数据库的补充测量，不是新配置已通过的结果。xzx四库角首轮9a6f4eb在32步扇出ECO脚本处停止，见[首轮诊断](implementation_9a6f4eb/README.md)。修复后的bcc483e消除扇出/电容违规，但被75%优化密度上限阻止Hold修复，见[密度阻塞](implementation_bcc483e/README.md)。随后全阶段85%的c8da454被Setup先耗尽预算，审计到29步后主动结束，见[分阶段预留空间](implementation_c8da454/README.md)。隔离实验已经测得留有余量时Hold可到+0.114ns，但Setup/DRV尚未同时通过；普通83%、Hold85%的组合仍在验证。20ns和整颗≤3.8mm²保持，尚无新的完整34步通过结果。

## 多库角测量

| 库角 | Setup WNS | Hold WNS |
| --- | --- | --- |
| TT，核心1.8V、IO3.3V、25°C | +0.371ns | +0.019ns |
| SS，核心1.62V、IO3.0V、125°C | −12.435ns | +0.094ns |
| FF，核心1.98V、IO3.6V、0°C | +5.190ns | −0.058ns |
| FF，核心1.98V、IO3.6V、−40°C | +5.408ns | −0.066ns |

[结果](pvt/results.json)、[库和源SHA](pvt/input_manifest.json)、[原始路径](pvt/ss_setup.log)、[全包](pvt/review.tar.gz)保留测量证据。标准单元、IO和SRAM额定电压/温度已匹配核对。后续审核发现原Innovus脚本用了Genus的-temperature选项，旧物理数据库的RC角实际均为25°C；原始manifest中“at each temperature”是请求范围，不能作为生效证明。以上旧测量仅代表匹配的多库角、同一typical RC/25°C，不代表RC温度分析或独立RC最小/最大角/SI签核。新版改用Innovus原生-T并读回核验，必须重新实现后测量。

聚合Setup TNS−46971.7ns、7155条违规路径；Hold TNS−3.458ns、165条违规路径。每库角单独列最差5条路径，未单独报告的每角TNS和违规条数在JSON中为null。聚合摘要与各库角最差WNS一致，原始输入SHA在分析后复核不变。

## 仿真器交叉诊断

Xcelium在相同原网表、原SDF、原生标准单元/IO和私有SRAM周期声明适配下完成18组功能测试，NPU1035周期，DMA/MAC任一93、读62、写93；没有复现VCS时间0的5条PAD显示。这不能单独证明PAD模拟上电安全。

[审核](xcelium/audit.json)、[结果](xcelium/results.json)、[编译回标原文](xcelium/build/compile.log)、[首组运行](xcelium/sdf_max/simulation.log)和[完整小包](xcelium/review.tar.gz)保留实际记录。

Xcelium路径注释统计为95.60%（610420/638510），时序检查为100%（81838/81838），另有SDFNEP路径不匹配。7条SDFNDP显示负延时截零，负延时补偿12项中10项成功、2项失败。因此绑定完整性和负延时完整支持均为false，不采用它替代原已验证的VCS作为完整验收。警告存在输出数量上限，JSON的消息数量明确标为已打印下界，不假称精确的全部缺失项数。

VCS延后外部驱动仍有时间0消息；常量单元替代试验未解决问题，已撤除替代模型，当前分支使用原生模型，不关闭冲突检查或时序检查。原始失败版本和日志保留服务器，探索工具只在本地archives。

## 正在实施的修复

新分支修正正Hold余量不足不触发优化的问题：最低要求0.10ns，优化目标0.12ns，最终32/33步独立门禁；启用0.3ns信号转换时间上限；综合和物理实现同时纳入TT/SS125/FF0/FF−40，四角路径报告必须生成。另保留TT和跨角MINIMUM/MAXIMUM的SDF运行方式。

未裁剪RTL、降低计算并行、放宽时钟或面积，也未新增假路径。是否达标必须看新一轮同源34步、实际面积、全角时序与后仿，不能沿用本页的旧版指标。

代理额外门槛相关的隔离探索已退出当前分支，保存在本地工作区archives/normal_acceptance_reset_20261027/retired_branch_reports；本页其他数据仅为历史正常测量，不用于当前验收。
