ChipDesign111/chip_design/eda/results/postsim_20261026.md

# SDF 后仿结果

- Git 提交：035946ebf74ec7c5f8d98faa687f3f9c717ee8c8
- 工艺/角点：TSMC180，TT，1.8 V，25 C
- 最终网表：work/pnr/my_soc_top/outputs/manual_final/my_soc_top_hier_postpnr.v
- SDF：work/pnr/my_soc_top/outputs/manual_final/my_soc_top_tt_io.sdf.gz
- 仿真器：Synopsys VCS Q-2020.03-SP2-7
- SRAM 模型：授权 RA1SHD_2048x32M8.v

## 结果

SDF_POSTSIM PASS cycles=3659。SoC 启动保护、固件加载、INT8 自检、DMA/CPU 数据通路均运行到结束并通过；SDF 已实际调用 sdf_annotate。

仿真日志：sdf_sim2.log；SDF 注释日志：sdf.log。SDF 日志记录 13,581 条 warning、41,098 条 SDF annotator error，主要为层次/二极管实例找不到以及负 SETUPHOLD 值被替换为 0；仿真仍完成并通过功能自检。运行期间报告 14 条标准单元 timing violation，需结合激励和时序检查 notifier 进一步分析，不能把本次 PASS 解释为所有动态时序检查均无违例。
