ChipDesign111/chip_design/verification/mmio/README.md

# MMIO 验证

计划检查窗口读写、打包、START/BUSY/DONE、保持读请求、非法地址和忙碌时写入。
遵守 docs/mmio.md；读 STATUS 不应有副作用。
