ChipDesign111/chip_design/verification/npu/README.md

# 完整 NPU 验证

计划逐项比对 32 个 hidden、六个 score 和类别，覆盖控制、复位和连续运行。
原 4×4 实验测试不代替新 MLP 的验证。
