ChipDesign111/chip_design/verification/soc/README.md

# SoC 验证

计划在真实 CPU 上运行共同构建的裸机程序；区分官方平台回归与 HAR 新项目测试。
记录镜像、filelist、工具和 commit；不得修改官方测试期望来掩盖问题。
