ChipDesign111/chip_design/eda/results/native_cbf40f2_20261027/README.md

# 关闭自动门控后的完整EDA与TT后仿

本轮物理输入为干净源码`cbf40f279d4ddde6c37d911882b954f78f27b712`，位于服务器`uploads/20261027_154930_cbf40f2`。系统20ns、含PAD整颗3.7956390976mm²，同源34步及环境/EDA/整理阶段退出0。[回传凭据](receipt.json)记录847项文件的逐项核验和输入SHA。所有功能RTL仍与main d40b217的91项文件一致。

| 匹配角 | Setup WNS/ns | Hold WNS/ns | TNS/违规路径 |
| --- | ---: | ---: | --- |
| TT25 | +3.985 | +0.097 | 0/0 |
| SS125 | +0.002 | +0.268 | 0/0 |
| FF0 | +5.690 | +0.009 | 0/0 |
| FF−40 | +5.883 | +0.000（报告精度） | 0/0 |

上述按正常零负余量条件通过；+0.000且违规路径0，不因代理额外正余量要求判失败。[Setup](final_setup.rpt)、[Hold](final_hold.rpt)保留原始四角报告。[33步检查](step_33.json)确认正常电气、DRC、核心供电/信号连通和天线检查；[34步](step_34.json)核对导出。[实际RC温度](rc_temperatures.json)为25/125/0/−40°C。实际逻辑密度72.005%，规划/优化预算85%，包含Filler的100%不是逻辑密度。

综合单元面积1993220.429µm²，包含SRAM401443.591µm²；比前轮1923228.672µm²增加69991.757µm²，约3.64%。外框固定，所以整颗面积没有随单元面积变化。普通使能和自动门控是实现选择，不能用旧版单元密度替代本轮实测。

## 后仿结论：未通过

正式TT运行`uploads/20261027_172201_postsim_vcs_tt_4e2b237`完成17例功能，回标error、缺失实例和缺失检查均0，但全阶段动态时序有**30条最终复位违规**，所以正常后仿未通过，自动串行流程已停止，未运行旧版快/慢角。

| 复位偏移 | 对象 | 数量 | 检查 |
| --- | --- | ---: | --- |
| 1.65ns | 主SRAM接口port_wdata_q载荷寄存器 | 26 | E使能引脚setuphold |
| 2.00ns | 主SRAM接口port_byte_we_q寄存器 | 4 | SE选择引脚setuphold |

没有SRAM宏动态违规，也没有上一轮6条RC_CG自动门控对象；[综合映射](synthesis.json)确认自动门控实例0。然而禁止插入独立门控不等于禁止库内带使能的触发器。26条对应EDFQD1BWP7T，另外4条对应SDFKCNQD1BWP7T。扫描单元的SE在这里被用作功能选择、SI接回Q来保持数据，并非已经布好扫描链。逻辑上等价，但E/SE有独立的时序限制，异步复位导致这些控制信号在采样沿附近变化。

[完整审核](postsim_tt/audit.json)、[17例结果](postsim_tt/results.json)、[输入身份](postsim_tt/input_manifest.json)及[回传清单](postsim_tt/review_manifest.json)保留真实失败；本地`lab4/native_cbf40f2_postsim_tt_20261027`核验67项文件。9条负IOPATH截零警告另列为工具能力限制，不是这30条违规的原因。没有关闭检查、notifier或改SDF消除消息。

## 下一轮实现选择

配置`functional_enable_mapping=mux_dff`，把功能使能保持为普通DFF前的数据选择器；继续关闭自动门控。`register_mapping.tcl`在Genus与Innovus统一排除内建使能、扫描选择、同步清零/置位和双数据选择类触发器，普通DFF及原生异步复位DFF仍可用。原RTL状态转移不变，所有真实时序检查保留。这是物理实现变化，必须新目录、完整综合/布局布线/SDF重跑，当前不能称已修复通过。面积、功耗与时序影响待实测。

中间尝试4ea3f0c虽读回早期库选择，但实际仍有7405个EDF，未实现mux_dff。原因是`init_design`建立新的活动库对象后没有重新应用限制。该版本没有新SDF，停止时已记录34步但入口退出1，不作为完整完成结果。脚本现已初始化后补充应用，并在综合后核对实际映射，必须新目录重跑。[部署身份](next_implementation.json)保留此前记录，最新状态以质量跟进和本机last_upload为准。

后续4427c4b已完成实际映射修正、四角34步及TT/快/慢各17例后仿，全阶段动态违规0；[最终结果](../native_mux_dff_20261027/README.md)保留全部新证据。本目录继续记录cbf历史失败，不把新结果混入旧审计。

每步解释和实际输出见[逐步运行报告](逐步运行报告.md)；操作及文件作用见[操作指南](../../docs/操作指南.md)与[后仿指南](../../docs/后仿真操作指南.md)。大GDS/DEF/SDF/SPEF、授权模型和数据库保留各自服务器目录，Lab4、main及旧有效结果保持。
