ChipDesign111/chip_design/eda/results/native_acceptance_20261027/README.md

# 正常条件四库角实施结果

源码`5b60015`已完成同源34步，环境、EDA、结果整理和总流程退出码均为0。含PAD整颗面积为**3.7956390976mm²**，满足3.8mm²限制。系统周期20ns；使用[正常验收条件](../../docs/验收条件.md)，没有额外正余量门槛。

| 匹配库角及实际RC温度 | Setup WNS/ns | Hold WNS/ns |
| --- | ---: | ---: |
| TT25 | +4.213 | +0.092 |
| SS125 | +0.097 | +0.199 |
| FF0 | +5.857 | +0.027 |
| FF−40 | +6.037 | +0.019 |

各角TNS和违规路径计数均为0。原生电气违规、default DRC、信号与核心PG未解决连通项、天线违规均为0；IO抽象供电残项有同源22步原生几何证据。实际逻辑密度68.944%，规划/优化预算85%；包含Filler的100%不是逻辑密度。当前供应typical RC表按温度分析，不宣称完整RCmin/max或SI签核。

本地`lab4/native_5b60015_final_20261027`已回传904个文件并逐项核验SHA；大GDS/DEF/SDF/SPEF/数据库保留服务器。[部署身份](deployment.json)、[物理结果与回传凭据](physical_result.json)记录源码、输入和交付包SHA。

复查顺序：[逐步运行记录](逐步运行报告.md)说明综合和01–34的实际执行及各阶段输出；[最终Setup](final_setup.rpt)与[最终Hold](final_hold.rpt)列出四角余量、TNS和违规路径数；[33步检查](step_33.json)记录布线/Filler后的时序、电气、供电、DRC和天线结果；[34步检查](step_34.json)核对最终交付视图。[实际几何](geometry.json)用于计算含PAD面积，[实际RC温度](rc_temperatures.json)证明工具读回正确温度。原理与每一步为什么这样做，配合[讲义34步说明](../../docs/讲义34步与文件对照.md)阅读。

新目录：`/home/s2400011041/Desktop/fullstack_chipdesign/uploads/20261027_132429_5b60015`；源码：`5b60015ce7e418d8632dcaf13a84bdc9f0b845d2`。服务器该版本README从解压、三个阶段到报告查看完整说明当前规则。main保持d40b217；本轮只修改EDA/后仿平台/文档，全部RTL与main一致。

对应的新SDF后仿**未通过**：修正零延时对照和上电起振后，完整TT矩阵17例功能均通过、回标error/缺失均0；但0.25ns与19.85ns的最终复位相位出现6条自动插入时钟门控使能时序违规。SRAM宏没有动态违规，同数据库半周期Setup最差输入/输出为+1.849/+0.441ns。9条负IOPATH警告另列为工具限制。详细[后仿审核](postsim_tt/audit.json)、[17例结果](postsim_tt/results.json)保留真实失败。

下一轮关闭Genus自动时钟门控转换，使RTL寄存器使能保留为数据选择逻辑，使用新上传目录从综合开始重新实现；不改旧work、SDF或验收条件。其静态/动态结果尚待新版本测量，不能沿用本文旧版数值。前期无SDF对照及首沿初始化问题、当前6条最终复位违规的区别见[质量跟进](../../../report/quality_followup.md)与[后仿指南](../../docs/后仿真操作指南.md)。

该轮已以干净源码cbf40f2部署到`uploads/20261027_154930_cbf40f2`，环境退出0，Genus实际读回两个自动门控属性均为false，正在重新综合。[最新部署身份](next_implementation.json)记录源包SHA及状态。中间5ff1b7a因Genus枚举参数格式在展开前停止，已修正并归档，不作为物理结果。

9a6f4eb、bcc483e、c8da454、77cb229四个失败版本已移至服务器history/retired_quality_20261027，保留原始文件，不再作为活跃任务或恢复入口。约3.95GB旧数据仍保留远端，没有搬回本机；轻量失败依据已回传本地lab4/normal_acceptance_reset_20261027并核验SHA。有效main/历史结果和Lab4未修改。

删除了旧手写扇出ECO与逐引脚边沿分类脚本；额外最低Hold、Setup目标和分阶段预算退出配置及执行/审核路径。代理开发测试、被退役的探索报告与原代码保存在本地archives，不进入部署包。包装清理命令同时修复了当前INT8配置的识别问题，只清理约定一次性包装文件，保留中间结果。
