ChipDesign111/chip_design/eda/results/sram_reset_20261027/README.md

# SRAM复位修正版：物理结果

源码5191064从Genus及讲义01–34步完整重跑，环境、EDA、整理和总流水线退出码均0。含PAD面积 **3.7956390976mm²≤3.8mm²**，系统 **20ns**，最终Setup/Hold **+0.371/+0.019ns**，所列最终时序、电气与物理检查通过。新SDF的16组完整SoC及无SDF对照均通过，所有动态时序阶段0条违规。详见[后仿与main对比](postsim/README.md)，17条负IOPATH与时间0 PAD模型限制保留。

## 从哪些文件开始

| 文件 | 作用 |
| --- | --- |
| [summary.json](summary.json) | 本版物理数据、来源和main对比 |
| [逐步运行报告](逐步运行报告.md) | 从综合到34步每一步的动作、理由、实际参数与结果 |
| [下载凭据](raw/receipt.json) | 606份文件逐项校验与34步同源身份 |
| [step33](raw/step_33.json)、[step34](raw/step_34.json) | 最终时序、物理检查和导出检查原始结论 |
| [综合面积](raw/area.rpt)、[外框](raw/geometry.json) | 区分映射面积与含PAD整颗面积 |
| [最终布局](final_layout.gif) | 本版实际布局布线截图 |
| [RTL修改说明](../../../report/reset_fix.md) | 为什么寄存SRAM命令、为何用下降沿、复位和AXI的时序关系 |

raw保留完整最终PG、DRC、天线、信号报告，以及Setup/Hold压缩原文。开发自检工具和临时日志不进入分支。

## 与现有main相比

| 指标 | main1192c32的物理e15483c | 本版5191064 |
| --- | --- | --- |
| 实际含PAD外框 | 1948.24×1948.24µm | 1948.24×1948.24µm |
| 整颗面积 | 3.7956390976mm² | 3.7956390976mm² |
| 规划利用率 | 85% | 85% |
| 实际逻辑密度 | 67.575% | 67.682% |
| 综合实例 | 58635 | 58729 |
| 综合Cell Area | 1894546.189µm² | 1897147.501µm² |
| 其中主SRAM | 401443.591µm² | 401443.591µm² |
| Setup WNS | +0.226ns | +0.371ns |
| Hold WNS | +0.019ns | +0.019ns |

新增命令寄存和相关优化使综合映射面积增加2601.312µm²，约0.1373%，实例增加94；固定外框没有扩大，整颗面积仍合格。实例差值是综合优化后的总差值，不等于RTL寄存器位数。主SRAM仍为8KiB，64+6个INT8乘法器、完整CPU/AXI/DMA功能保留。Setup余量增加0.145ns只是这两次物理实现的实测差异，不是所有路径都加快。

67.682%是工具报告的有效逻辑密度。85%用于规划，Filler后的100%是空隙填充结果，均不能替代有效密度。

## 检查结果如何理解

Setup/Hold均WNS≥0、TNS=0、违规路径0；电容、转换时间、扇出和线长违规均0。最终无未摆放逻辑；完整核心VDD/VSS供电连接、默认DRC和天线检查通过。IO的VDDPST/VSSPST两项抽象限制仍依同源22步原生几何证明分类，不当作独立LVS通过。

本版SRAM输入寄存器到宏、宏到响应寄存器只有半个系统周期。这些路径不能用20ns全周期推算，也不能增加假路径豁免。最终全局STA通过；补充只读STA确认输入半周期Setup/Hold +6.290/+10.194ns，输出 +3.188/+11.476ns，见[路径原文与解释](postsim/README.md)。

导出检查：57098个非顶层SDF实例对应、63677个SPEF网络、616个GDS结构，未定义GDS引用0。导出SDF不是执行SDF后仿。

## 保存位置与范围

服务器：`/home/s2400011041/Desktop/fullstack_chipdesign/uploads/20261026_214621_5191064`。GUI入口README.html；三个入口为check_env.sh、run_eda.sh、collect_results.sh。

本机完整核心结果在lab4/sram_reset_5191064_20261027。回传包SHA fa02e55209b5d8dd1de4338ba56fffbe3d0a0a49b46d986bd575e5a491c7b16e；冻结输入SHA daf0fa6d68fdfeee8614d3984d1ba78002df4e9683ab9a7b0a2cfb1bf7e98810。

GDS/DEF/SDF/SPEF和数据库保留远端work/pnr/my_soc_top；授权库不进入Git。分析条件仍为单TT、1.8V、25°C，未独立执行多PVT、晶圆厂DRC/LVS、IR/EM/ESD或形式等价。新版动态后仿和main比较已完成，全部原始时序消息及工具限制保留。
