ChipDesign111/chip_design/eda/results/int8_3p8_20261024/README.md

# 3.8 mm² 完整 SoC：最终结果与对比

本轮完整重跑综合及讲义01–34步，环境检查、EDA、结果整理及总流水线退出码均为0。含PAD整颗面积 **3.7956390976 mm² ≤3.8 mm²**，系统保持 **20 ns（50 MHz）**，最终Setup/Hold为 **+0.226 / +0.019 ns**，所列最终时间和物理检查通过。

## 1．先读哪些文件

先读本页，再读[完整逐步运行报告](逐步运行报告.md)：每一步做什么、为什么、关键参数、实际Tcl与本轮生成结果都在其中。术语从仓库eda/docs/基础知识.md、当前设计数据流.md开始；复现按eda/README.md从打包上传开始，分环境、EDA、收集三个脚本运行。

| 文件 | 作用 |
| --- | --- |
| [summary.json](summary.json) | 当前配置、实测面积/密度/时间、完整最终检查与远端大文件SHA |
| [下载凭据](raw/receipt.json) | 618个文件、34步输入身份和回传包校验 |
| [实际外框](raw/geometry.json) | 工具实际Die尺寸，面积验收依据 |
| [综合面积](raw/area.rpt) | 完整SoC各层次单元面积，不等于整颗面积 |
| [最终填充检查](raw/step_33.json) | 时序、电气、完整核心PG、DRC、天线、信号连接分类 |
| [最终导出检查](raw/step_34.json) | DEF/网表/SDF/SPEF/GDS结构对应关系 |
| [最终布局](final_layout.gif) | 本轮工具截图，含PAD、SRAM和核心布线 |

raw还保留原始Setup/Hold gzip摘要、完整PG/DRC/天线/信号报告。JSON提取结论，原文提供复核依据。gzip为压缩文本，用gzip工具或Python读取。完整核心源码和阶段证据在回传目录core中；Git只保存正常报告，不包含开发自检或大数据库。

## 2．与上一轮相比，面积和利用率有什么变化

| 项目 | 上一轮c97325b | 本轮e15483c |
| --- | --- | --- |
| 规划利用率参数 | 68% | 85% |
| 请求核心边长 | 1696 µm | 1648 µm |
| 实际含PAD外框 | 1996.4×1996.4 µm | 1948.24×1948.24 µm |
| 实际整颗面积 | 3.98561296 mm² | 3.7956390976 mm² |
| 最终实际逻辑密度 | 63.089% | 67.575% |
| 系统周期 | 20 ns | 20 ns |
| 最终Setup WNS | +0.042 ns | +0.226 ns |
| 最终Hold WNS | +0.021 ns | +0.019 ns |

整颗面积减少 **0.1899738624 mm²，约4.7665%**。相对3.8上限还有0.0043609024mm²余量，约上限的0.1148%；新增PAD或改变尺寸后需重新验收。

**85%是面积规划参数，最终实测密度为67.575%，不能报告成85%。** 参数用于估计标准逻辑是否装得下；固定核心边长直接决定这次缩小的外框。实际密度受宏、保留空隙、时钟树和修复单元等影响。含Filler的100%表示剩余空隙被物理填充，并非有效逻辑密度。此前用户所说约70%对应规划参数，不是上一轮实际63.089%。

Die是含核心和PAD外围的整个裸片，Core是内部摆放区域，Cell Area是库中映射单元面积之和。面积验收用1948.24²/1,000,000，不能换用Cell Area。

本轮综合仍为58635个映射实例、Cell Area=1,894,546.189µm²，含一个8KiB原生SRAM=401,443.591µm²，无锁存器和未映射叶子，CPU/NPU/DMA层次存在。RTL未改，综合面积不变；本轮节省来自物理外框缩小，不能声称减少了计算单元或SRAM容量。

## 3．20 ns时序如何判断

Setup检查数据能否及时到达下一采样边沿；Hold检查变化是否过早。WNS是最差余量，TNS是负余量总和。两项均WNS≥0、TNS=0、违规路径0才通过。本轮Setup +0.226ns、Hold +0.019ns；cap/tran/fanout/length的Real与Total违规均为0。

最差Setup路径仍在CPU：从id_stage_i/alu_operator_ex_o_reg[1]，经执行级ALU，回到id_stage_i/alu_operand_b_ex_o_reg[13]，使用sys_clk。Required Time=21.170ns，Arrival=20.944ns，相减为0.226ns。到达时间包含时钟树延迟，不能直接当作周期。

最差Hold路径在JTAG：i_dmi_jtag/data_q_reg[29]到i_dmi_cdc/i_cdc_req/i_src/data_src_q_reg[data][29]，使用jtag_clk；Required=1.464ns、Arrival=1.483ns，余量0.019ns（19ps）。最终要求WNS≥0；配置hold_target_ns=0.02是优化期望值，不是把原始SDC改成0.02ns。19ps余量小，不能宣称多PVT均通过。

系统周期保持20ns；JTAG100ns、虚拟JTAG参考1000ns沿用原设计。没有新增路径例外来掩盖违规。缩小后的布局改变了线路与单元优化，Setup反而改善，但不能据此推论继续缩小一定更快。

分析条件为TT、1.8V、25°C、SI关闭、原生CapTable low RC。SI指信号间干扰；本轮不是全工艺角签核。

## 4．物理检查和实际执行

最终未摆放实例0，无其他未分类放置问题；完整核心VDD/VSS供电报告无问题或警告，包含悬线检查；默认DRC=0、天线违规网络=0、未解决信号连接问题=0。

常规信号报告仍有VDDPST/VSSPST两项IO抽象限制，只有本轮22步原生电源轨、角部与实际外围连续性证据齐备才被分类。没有将原文改成零问题，这不替代独立LVS，也不豁免核心供电断开。

本轮33步在所有物理单元/Filler接入后执行editTrim修剪多余电源线尾段，再重新提取RC和检查；不提前21步修剪。31步选择网天线修复后DRC已干净，未触发额外31_drc_fix。32步实际执行Setup与Hold优化，最终独立复核通过。每条命令和阶段报告可在逐步运行报告及core/evidence/commands中复核。

## 5．功能与启动保护保留

当前仓库、部署回传源码和已完成功能验证的84项RTL/头文件/filelist哈希一致。本轮没有改RTL。第一层2输入×32输出=64个INT8乘法器，第二层1×6=6个；输入、权重、隐藏值INT8，偏置/累加/分数INT32。

DMA从主8KiB SRAM预取权重到两个64B tile缓冲，当前tile完成本批全部样本后才能替换。既有32随机批次、24训练输入逐值通过；授权/可移植SRAM完整SoC通过，CPU自检3659观测拍，DMA读/MAC重叠62拍、写/MAC重叠93拍。这些是RTL功能验证证据，不能写成本轮SDF后仿性能。

ASIC上电取指默认禁止，2048个SRAM全字顺序装载完成、Boot地址0x0001003c写入0xb007c0de后，再等待5拍余量才放行CPU。部分加载和错误密钥不能抢跑。复位异步拉低、两级各4拍同步释放。运行中重新装载仍需先停CPU或复位，撤销密钥不是硬复位。

## 6．身份、保存位置与文件用途

部署提交：e15483c479d399faa3849186a29c871e4c1540b1。后续结果文档提交不代表换源重跑。服务器版本：

```text
/home/s2400011041/Desktop/fullstack_chipdesign/uploads/20261023_225536_e15483c
```

上传包SHA：eff28008395b08e48b215bcf499602f7f101eead7e0f9dd07fb459dd005a09ae。
冻结输入清单SHA：a0d0027efc2abcc0ed7de162c5ddafe43a0ea1cbfe33b401f3ed8bb9ba01583c。
回传包SHA：fa01f8232adbc4894787b804b860a1fe54750a52c04ec68ded17858cdf53ccdd。

不同SHA对应源码包、阶段输入身份与结果包三个对象，数值不同正常。618个回传文件已核验，34步同一输入；没有拼接上一轮检查点。

| 位置/文件 | 用途和保留方式 |
| --- | --- |
| 本机lab4/int8_e15483c_3p8_final_20261024/README.html | 本轮独立入口，保留旧3.9856结果 |
| 最终结果分析.html、逐步运行报告.html | 双击阅读结论与每步做什么/为什么/实际结果 |
| core/src/chip_design/rtl | 实际核心源码 |
| core/config、flow | 本轮固定配置与正式流程脚本 |
| core/syn及pnr下reports | 综合和各阶段时序原报告 |
| core/evidence | 输入身份、实际命令、截图、阶段检查及原文归档 |
| receipt.json、review_manifest.json | 校验凭据、文件清单及远端大文件路径/SHA |
| 服务器work/pnr/my_soc_top/outputs/manual_final | GDS/DEF/SDF/SPEF、网表、LEF、SDC等最终视图 |
| 服务器work/pnr/my_soc_top/backup | enc与enc.dat成套阶段数据库 |

GDS是几何版图，DEF是位置与布线，SDF是单元/互连延时，SPEF是寄生电阻电容；这些大文件及平坦网表留服务器，不搬进Git。本机有小型报告和gzip层次网表，完整路径、字节数及SHA见summary.json的large_views_retained_remote。第34步核对十个物理端口，SDF非顶层实例56920、SPEF网络63495、GDS结构627、未定义引用为空。

## 7．结论范围

本轮已满足含PAD≤3.8mm²目标、指定完整功能、同源34步和三个阶段、20ns单TT最终时序、电气、供电和所列物理检查。**85%规划参数已使用，实际逻辑密度为67.575%。**

SDF已导出，未执行SDF回标后仿。独立晶圆厂DRC/LVS、多PVT、IR/EM/ESD和形式等价未执行，不将文件导出或工具内检查冒称这些签核完成。
