ChipDesign111/chip_design/eda/results/int8_20261023/README.md

# INT8 完整 SoC：2026-10-23 最终结果与解读

本轮从当前 RTL 完整综合，按讲义完成 **01–34 步**，环境检查、EDA、结果整理及总流水线退出码均为 0。含 PAD 整颗面积 **3.98561296 mm²**，满足 **≤4 mm²**。系统时钟 **20 ns（50 MHz）** 下，最终 Setup/Hold 与所列物理检查通过。

## 1．结果身份与阅读顺序

部署源码为 `c97325b137204416b6794f493a4b735bccf31a96`，基于 main `267c873` 的 xzx。后续结果文档提交不代表更换 RTL 重新执行。服务器版本：

```text
/home/s2400011041/Desktop/fullstack_chipdesign/uploads/20261023_031855_c97325b
```

| 校验对象 | SHA256 | 含义 |
| --- | --- | --- |
| 上传源码包 | dbd9c2421ffd435ed5910c2ac27fa24f857677ff83b11abc214320f39d9c6432 | 当时实际上传的压缩包 |
| 冻结输入清单 | 3b029821e0d7de870e6c91b5e06844bc3055f808f26f6f05afa6b49b952ecba5 | 34步使用相同源码、配置和程序 |
| 回传包 | 7524c51c84b70ad5e830b9fd3900e918dd338d5a0e6655c69541d3c8d6a80139 | 下载完整性，已核验618个文件 |

先读本页，再打开[完整逐步运行报告](逐步运行报告.md)。它逐步说明做什么、为什么、关键参数、实际执行 Tcl 和生成结果，来自本轮实际记录。术语从仓库 `eda/docs/基础知识.md`、`当前设计数据流.md` 开始读。

| 文件 | 作用 |
| --- | --- |
| [summary.json](summary.json) | 本轮身份、面积、时间、物理检查、功能范围和大文件路径/SHA |
| [raw/receipt.json](raw/receipt.json) | 下载时对压缩包、逐文件和全部阶段输入身份的校验 |
| [raw/geometry.json](raw/geometry.json) | 工具实际外框，整颗面积的依据 |
| [raw/area.rpt](raw/area.rpt) | 综合后各层次单元面积，不等于整颗面积 |
| [raw/step_33.json](raw/step_33.json) | 最终填充后的时间、电气、放置、供电和物理检查 |
| [raw/step_34.json](raw/step_34.json) | DEF、网表、SDF、SPEF、GDS结构对应检查 |
| [最终布局图](final_layout.gif) | 外围PAD、左侧SRAM与核心布线的工具截图 |

`raw/` 也保留原始 Setup/Hold 摘要及 PG/DRC/信号/天线报告。`.gz` 是 gzip 压缩文本，先解压或用 Python gzip 读取。JSON 提取结论，原始报告提供复核依据。完整核心源码和所有阶段报告在本机回传目录 `core/`，Git 只收录这些便于审阅的正常结果。

## 2．面积是否真正达标

Die 是含核心和 PAD 外围的整个裸片；Core 是内部摆放逻辑的区域；Cell Area 是库中单元面积之和。不能用后两者代替整颗面积。

| 项目 | 本轮值 | 怎么理解 |
| --- | --- | --- |
| 实际 Die | 1996.4×1996.4 µm | 工具合法网格对齐后的尺寸 |
| 含PAD面积 | 3.98561296 mm² | 1996.4² / 1,000,000 |
| 验收上限 | 4.0 mm² | 用户最终确认的整颗面积限制 |
| 面积余量 | 0.01438704 mm²，约0.360% | 余量小，新增PAD或改尺寸要重验 |
| 核心请求/边距 | 1696 µm / 四侧150 µm | 请求值不直接冒充实际外框 |
| 综合 Cell Area | 1,894,546.189 µm² | 完整SoC映射面积，包含一个SRAM |
| SRAM | 401,443.591 µm² | 原生2048×32，8 KiB |
| 综合标准逻辑 | 1,493,102.598 µm² | Cell Area减去SRAM |
| 最终报告密度 | 63.089%；含Filler时100% | Filler填空隙，不代表新增计算能力 |

首轮 INT8 综合 Cell Area 为 2,171,670.432 µm²，本轮减少 277,124.243 µm²，约12.76%。移除了交叉开关内部额外流水寄存器，并让70个INT8乘法器直接进入INT32累加器；CPU、DMA、端点寄存适配器、主SRAM及指定并行度保留。旧版1500 µm核心规划失败，没有实际裸片结果，不能把旧单元面积当作旧Die面积。

## 3．时序是否通过，瓶颈在哪里

寄存器输出经过逻辑和导线，必须满足下一个采样边沿。Setup检查能否及时到达，Hold检查是否变化过早。WNS是最差余量，TNS是所有负余量合计；0.001 ns等于1 ps。

| 最终检查 | WNS | TNS | 违规路径 |
| --- | --- | --- | --- |
| Setup | +0.042 ns（42 ps） | 0 | 0 |
| Hold | +0.021 ns（21 ps） | 0 | 0 |

Setup最差路径在CPU：`id_stage_i/alu_operator_ex_o_reg[4]` 经执行级ALU组合逻辑，回到 `id_stage_i/alu_operand_b_ex_o_reg[12]`，使用sys_clk。Required Time=21.182 ns减Arrival Time=21.140 ns，余量0.042 ns。这些时间包含真实时钟树延迟，不能把Arrival直接当作周期。

Hold最差路径在JTAG：`i_dmi_jtag/data_q_reg[11]` 到 `i_dmi_cdc/i_cdc_req/i_src/data_src_q_reg[data][11]`，使用jtag_clk，余量0.021 ns。系统周期仍为20 ns；独立JTAG周期100 ns，虚拟JTAG参考1000 ns用于IO约束。沿用原复位及跨时钟约束，没有为本轮违规新增路径例外。

最终max_cap、max_tran、max_fanout、max_length的Real/Total均为0：负载电容、信号变化时间、扇出和长度没有已报告违规。42 ps和21 ps都是较小余量，结论仅适用于 **TT、1.8V、25°C、SI关闭、原生CapTable low RC** 条件，不延伸为全部工艺/电压/温度均通过。

## 4．物理检查与本轮实际修复

| 检查 | 结果 | 作用 |
| --- | --- | --- |
| 放置 | 未摆放0，无其他未分类问题 | 确保实例有合法位置；库预期PAD覆盖另列 |
| 核心完整供电PG | 无问题或警告，包含悬线检查 | 不允许靠排除尾段检查通过 |
| 默认几何DRC | 0 | 检查工具内短路、间距等几何规则 |
| 制造天线 | 违规网络0 | 检查制造过程长金属积累电荷的风险 |
| 常规信号连通 | 未解决信号问题0 | 两项IO抽象限制有本轮证据分类 |

常规连接原文仍报告 `VDDPST / VSSPST` 两项IO库抽象限制。第22步验证本轮原生电源轨、角部和实际外围连续性后，才允许分类；没有把原文改成字面零问题。这不是对核心VDD/VSS断开的豁免，也不替代独立LVS。

前一版有48处VDD电源线尾段超出最后一个有效连接点，被第33步拦截。本轮仅在**全部物理单元和Filler接入后**运行 `editTrim -nets {VDD VSS}` 修剪无负载尾段，然后重新提取RC并复查完整供电、DRC和时序，最终通过。提前修剪可能删去后续新增单元需要的电源线，故第21步保留尾段。

第31步增加了由实际DRC决定的有限次全设计detailRoute修复。本轮实际**没有触发额外31_drc_fix.tcl**：选择网天线修复后的独立DRC已经干净，命令归档只有31_check.tcl和31_fix.tcl。报告只描述实际发生的操作。

## 5．功能、DMA并行与启动保护

本轮84项RTL/头文件/filelist哈希与已通过功能验证的输入一致，且与回传的部署源码一致。32组随机批次及12组训练双样本批次（24条UCI输入）逐值通过；完整CV32E40P SoC使用授权SRAM行为模型和可移植模型均通过。

第一层每拍2输入、更新32输出，共64个INT8乘法器；第二层每拍1输入、更新6输出，共6个。输入、权重和隐藏激活为INT8，偏置、累加和分数仍为INT32。两个64B tile缓冲交替接收DMA权重；当前tile完成本批全部样本后才允许替换。完整SoC实际DMA读/MAC重叠62拍、写/MAC重叠93拍，不是仅同时使能模块。

CPU自检在提交启动后的观测耗时3659拍，包含软件与检查开销，不是纯NPU推理延迟。ASIC默认禁止CPU取指：2048个SRAM全字顺序装载完成后，向Boot MMIO `0x0001003c` 写入密钥 `0xb007c0de`，再等待5拍余量才允许执行。部分装载和错误密钥不能提前放行。系统复位异步拉低，分两级各4拍同步释放；复位、DMA中断和重启等测试通过。运行中重装载前需停CPU或复位，撤销密钥本身不等于硬复位。

功能证据见仓库 `report/functional_validation.json`。授权SRAM行为模型测试关闭时序notifier；这不是SDF回标后仿。

## 6．最终视图、结构与查看方法

大文件保留在本版本 `work/pnr/my_soc_top/outputs/manual_final/`，完整路径、大小和SHA见summary.json及本机review_manifest.json。

| 文件 | 作用 | 处理 |
| --- | --- | --- |
| GDS.gz，约14.33 MB | 合并IO、标准单元、SRAM与互连的几何 | 留服务器 |
| DEF，约89.53 MB | 单元位置、端口和布线 | 留服务器 |
| flat_lvs.v，约24.47 MB | 后续几何/电路比较使用的平坦网表 | 留服务器，文件名不表示LVS已执行 |
| SDF.gz，约12.82 MB | 单元与互连延时，供后续仿真回标 | 留服务器，尚未执行回标仿真 |
| SPEF.gz，约22.73 MB | 布线寄生电阻电容 | 留服务器 |
| 层次网表、SDC、LEF、小型报告 | 层次连接、约束、外框引脚及证据 | 回传轻量包，层次网表另作gzip |
| backup/*.enc与*.enc.dat | 成套恢复阶段数据库 | 留服务器 |

第34步验证十个物理端口（六个信号加四个电源）、SDF非顶层实例匹配56944、SPEF网络63513、GDS结构614、未定义GDS引用为空。结构引用完整不等于独立晶圆厂签核。

```text
本机：C:/Users/zixiang/OneDrive/Desktop/advanced_chip_study/lab4/int8_c97325b_final_20261023
├── README.html / .md             从这里读
├── 最终结果分析.html / .md       结论、术语、原报告解读
├── 最终结果摘要.json             关键字段及远端大文件SHA
├── core/
│   ├── src/chip_design/rtl/       实际核心源码
│   ├── config/、flow/             本轮固定参数与正式脚本
│   ├── syn/.../reports/           综合原报告
│   ├── pnr/.../reports/           阶段时序原报告
│   └── evidence/                 逐步说明、实际命令、截图、验收
├── receipt.json                  下载凭据
└── review_manifest.json           文件清单及远端大文件路径/SHA
```

服务器版本根README.html是GUI入口，`results/最终结果分析.html`提供本轮解读。下一轮复现仍跟随仓库eda/README.md从打包、上传、解压开始，依次运行环境、EDA、收集三个脚本；不用本轮检查点冒充新输入结果。

## 7．验收范围

完整SoC、指定INT8并行度、DMA tile复用与实际重叠、启动保护、同源34步、含PAD≤4mm²，以及所列单TT最终时序/电气/物理检查均已满足。**未执行SDF回标后仿、独立晶圆厂DRC/LVS、多PVT签核、IR/EM/ESD和形式等价。** 不将导出文件等同于这些验证已经完成。
