ChipDesign111/chip_design/eda/results/quality_baseline_20261027/implementation_9a6f4eb/README.md

# 四角实现首轮：未完成验收

物理源码：`9a6f4eb9bea58615d9137cf87f0705fff425a87f`。独立版本：`/home/s2400011041/Desktop/fullstack_chipdesign/uploads/20261027_013823_9a6f4eb`。源包SHA256：`768535bc520a6ad3a741f47d748d7f19e30f0b6b6abc299f45b28b25b728564d`。

环境检查退出0；EDA退出1，已审计完成31步，32步脚本报错。没有最终SDF及完整34步结果，不能作为新版通过证明。

| 修复前布线后诊断 | 实测 |
|---|---:|
| 含PAD整颗面积 | 3.7956390976mm² |
| 四角最差Setup | +0.077ns |
| Setup TNS / 违规路径 | 0 / 0 |
| 四角最差Hold | −0.827ns |
| Hold TNS / 违规路径 | −14.459ns / 146 |
| 实际max-cap / max-tran / max-fanout违规网络 | 31 / 8400 / 676 |
| 报告逻辑密度 | 75.756% |

Setup表示数据是否足够早到达；Hold表示数据是否保持足够久。此时最慢库角Setup已改善，但Hold与电气规则尚未修复。密度是该阶段报告值，不能当最终密度或85%规划参数。

第31步完成走线后的DRC、连通性与天线检查，详见[审计记录](step_31.json)。进入32步后，脚本准备按实际报告为676个大扇出网络添加非反相缓冲器，让一个驱动器分担给多个缓冲器，以减少负载。它在`slave[3]_b_ready`的名称比较处误把Tcl列表序列化字符串当成单个名称，因此停止，见[失败摘录](failure_excerpt.log)。这不表示该网络不存在，也不能据此认定剩余时序问题已经解决。

保留[Setup摘要](my_soc_top_postRoute.summary.gz)、[Hold摘要](my_soc_top_postRoute_hold.summary.gz)、[流水线状态](summary.json)与[逐文件SHA](receipt.json)。gz文件用gzip解压读取。原数据库、完整工具日志及大文件留在上述服务器版本目录。后续修复使用新上传目录，原输入与结果保留。

修复脚本已通过[专项验证](repair_validation.json)：676个目标的只读预检通过，其中190个网络名称含方括号；实际执行正式脚本的ECO主体，分别在136引脚、44引脚的总线/数组层次网络上插入非反相缓冲器，移动68、22个引脚，并逐个核对原驱动、选中及未选中引脚连接。LEQCheck开启；诊断数据库未保存，不用于正式流程续跑。工具可能让原名称留在缓冲器输出侧，因此连接检查使用真实数据库对象，而不要求输入网络继续使用原名称。
