ChipDesign111/chip_design/eda/results/native_mux_dff_20261027/逐步运行报告.md

# 本轮EDA运行记录

工程：`/home/s2400011041/Desktop/fullstack_chipdesign/uploads/20261027_200222_4427c4b/work`

配置与源身份：见input_manifest.json、source.json和preparation.json。

本流程不运行功能仿真；EDA结果与独立工艺签核的范围分别说明。

## Genus输入、展开、综合与交接

输入清单有76份RTL；主存选择与源身份见preparation.json。

**G1：完整综合已包含展开，未另跑独立展开检查。**

**G2 综合执行：**

```json
{
  "commands_completed": true,
  "check_design_review_required": true,
  "scope": "Fresh tool execution, not functional equivalence or physical signoff"
}
```

**G3 综合面积与映射结果：**

```json
{
  "cell_count": 69768,
  "cell_area_um2": 2039855.258,
  "net_area_um2": 785828.944,
  "latch_area_um2": 0.0,
  "memory_area_um2": 401443.591,
  "report": "/home/s2400011041/Desktop/fullstack_chipdesign/uploads/20261027_200222_4427c4b/work/syn/my_soc_top/reports/area/area.rpt",
  "mapped_design": {
    "native_main_srams": 1,
    "mapped_leaf_instances": 69768,
    "all_leaf_types_have_library_models": true,
    "npu_dma_area_hierarchy_present": true,
    "latch_area_um2": 0,
    "automatic_clock_gating_requested": false,
    "mapped_automatic_clock_gate_instances": 0,
    "functional_enable_mapping": "mux_dff",
    "mapped_controlled_flip_flop_instances": 0
  }
}
```

**G4 新面积与后端规划：**

```json
{
  "cell_count": 69768,
  "cell_area_um2": 2039855.258,
  "net_area_um2": 785828.944,
  "latch_area_um2": 0.0,
  "memory_area_um2": 401443.591,
  "report": "/home/s2400011041/Desktop/fullstack_chipdesign/uploads/20261027_200222_4427c4b/work/syn/my_soc_top/reports/area/area.rpt",
  "planning_pass": true,
  "required_core_area_um2": 2398169.8686911766,
  "planned_whole_die_area_mm2": 3.794704,
  "max_whole_die_area_mm2": 3.8,
  "standard_cell_area_estimate_um2": 1638411.66725,
  "reserved_macro_halo_um2": 470626.73075000005,
  "target_utilization": 0.85,
  "core_size_um": 1648,
  "planning_only_not_timing_or_IR_proof": true
}
```

## 01 导入新门级设计

**做什么：** 读入新版SoC网表、库外形与时间模型，并查找唯一主SRAM。

**为什么：** 网表只写连接，库资料才给出实际器件；先排除旧网表、缺模型和选错宏。

**预期效果：** 设计名my_soc_top，主SRAM恰好一个，记录综合后真实实例路径。

**关键参数：** 顶层固定为my_soc_top，宏型号固定RA1SHD_2048x32M8；实例名从当前数据库查询，不照搬旧层次路径。

**本轮实际执行片段：** 下列是运行时保存的Tcl正文；宏路径已解析，其他变量结合配置与日志阅读。

`001_01_tcl.tcl`

```tcl
# Actual sourced body; main SRAM resolved to i_mainmem/i_sram/i_macro
dbGet top.name
dbGet top.insts.cell.name RA1SHD_2048x32M8

dbGet [dbGet top.insts.cell.name RA1SHD_2048x32M8 -p2].name
dbGet head.sites.name
```

**本轮结果：** 步骤命令与对应自动检查已通过；详见`step_01.json`，独立验收范围以该JSON为准。

```json
{
  "step": 1,
  "commands_completed": true,
  "input_manifest_sha256": "c1b350a1f2550de2e21af03963a3450d3a6ad885f83b8e2bc00b99558cf63f6d",
  "automatic_checks": {
    "actual_rc_temperatures_C": {
      "tt_1p80v_25c": 25,
      "ss_pvt": 125,
      "ff0_pvt": 0,
      "ffm40_pvt": -40
    },
    "native_sram_resolved": true
  },
  "scope": "Only the listed automatic checks are asserted. Tcl guards also check object counts, IO geometry and halo. Not complete signoff."
}
```

## 02 确定核心与裸片尺寸

**做什么：** 根据新综合面积和目标放置密度估算核心，再由工具建立合法行网格。

**为什么：** 面积目标约束含 PAD 的整个 Die；先用当前综合结果核对核心空间，不能照搬旧大尺寸或仅缩小边框。

**预期效果：** 生成floorplan_plan.json与geometry.json，后续外围统一使用实际Die尺寸。

**关键参数：** 当前请求 core 1648 μm、四侧余量150 μm、目标利用率0.85；实际网格对齐后整个 Die 必须≤3.8 mm²。core_size_um为空时自动估算，但仍受整颗面积上限保护。

**本轮实际执行片段：** 下列是运行时保存的Tcl正文；宏路径已解析，其他变量结合配置与日志阅读。

`001_02_tcl.tcl`

```tcl
# Actual sourced body; main SRAM resolved to i_mainmem/i_sram/i_macro
floorPlan -coreMarginsBy die -site core7T -s $eda_core_size $eda_core_size 150 150 150 150
```

**本轮结果：** 步骤命令与对应自动检查已通过；详见`step_02.json`，独立验收范围以该JSON为准。

```json
{
  "step": 2,
  "commands_completed": true,
  "input_manifest_sha256": "c1b350a1f2550de2e21af03963a3450d3a6ad885f83b8e2bc00b99558cf63f6d",
  "automatic_checks": {
    "actual_rc_temperatures_C": {
      "tt_1p80v_25c": 25,
      "ss_pvt": 125,
      "ff0_pvt": 0,
      "ffm40_pvt": -40
    },
    "geometry": {
      "die_um": [
        0.0,
        0.0,
        1948.24,
        1948.24
      ],
      "whole_die_area_mm2": 3.7956390976,
      "max_whole_die_area_mm2": 3.8,
      "signal_pads": [
        {
          "port": "clk_i",
          "pad": "clk",
          "master": "PDDW0204CDG",
          "direction": "input",
          "side": "N",
          "offset_um": 300
        },
        {
          "port": "rst_ni",
          "pad": "rst_n",
          "master": "PDDW0204CDG",
          "direction": "input",
          "side": "N",
          "offset_um": 1400
        },
        {
          "port": "tck_i",
          "pad": "tck",
          "master": "PDDW0204CDG",
          "direction": "input",
          "side": "S",
          "offset_um": 250
        },
        {
          "port": "tms_i",
          "pad": "tms",
          "master": "PDDW0204CDG",
          "direction": "input",
          "side": "S",
          "offset_um": 450
        },
        {
          "port": "td_i",
          "pad": "tdi",
          "master": "PDDW0204CDG",
          "direction": "input",
          "side": "S",
          "offset_um": 1400
        },
        {
          "port": "td_o",
          "pad": "tdo",
          "master": "PDDW1216CDG",
          "direction": "output",
          "side": "S",
          "offset_um": 1600
        }
      ],
      "power_slots": [
        {
          "suffix": "vss_1",
          "master": "PVSS1CDG",
          "offset_um": 600
        },
        {
          "suffix": "vss_2",
          "master": "PVSS1CDG",
          "offset_um": 700
        },
        {
          "suffix": "vssio",
          "master": "PVSS2CDG",
          "offset_um": 800
        },
        {
          "suffix": "vdd_1",
          "master": "PVDD1CDG",
          "offset_um": 900
        },
        {
          "suffix": "vdd_2",
          "master": "PVDD1CDG",
          "offset_um": 1000
        },
        {
          "suffix": "vddio",
          "master": "PVDD2CDG",
          "offset_um": 1100
        },
        {
          "suffix": "poc",
          "master": "PVDD2POC",
          "offset_um": 1200
        }
      ],
      "pin_rectangles_um": {
        "clk_i": [
          310,
          1945.84,
          320,
          1946.84
        ],
        "rst_ni": [
          1410,
          1945.84,
          1420,
          1946.84
        ],
        "tck_i": [
          260,
          1,
          270,
          2
        ],
        "tms_i": [
          460,
          1,
          470,
          2
        ],
        "td_i": [
          1410,
          1,
          1420,
          2
        ],
        "td_o": [
          1610,
          1,
          1620,
          2
        ],
        "VDD": [
          910,
          1945.84,
          920,
          1946.84
        ],
        "VSS": [
          610,
          1945.84,
          620,
          1946.84
        ],
        "VDDPST": [
          1110,
          1945.84,
          1120,
          1946.84
        ],
        "VSSPST": [
          810,
          1945.84,
          820,
          1946.84
        ]
      },
      "main_macro_xy_um": [
        250,
        650
      ],
      "generated_from_measured_database_geometry": true
    }
  },
  "scope": "Only the listed automatic checks are asserted. Tcl guards also check object counts, IO geometry and halo. Not complete signoff."
}
```

## 03 识别SRAM硬宏

**做什么：** 查询宏的型号、实例名、尺寸和分类。

**为什么：** 型号是库里的模板，实例是本设计使用一次；后续放置必须找对具体实例。

**预期效果：** 确认RA1SHD_2048x32M8并保存查询结果，尚不改变位置。

**关键参数：** `cell.size`是LEF定义的物理大小；`baseClass=block`区分硬宏与标准单元。RTL中预计为i_mainmem/i_sram/i_macro；综合可能改名，以本步数据库查询的唯一实例为准。

**本轮实际执行片段：** 下列是运行时保存的Tcl正文；宏路径已解析，其他变量结合配置与日志阅读。

`001_03_tcl.tcl`

```tcl
# Actual sourced body; main SRAM resolved to i_mainmem/i_sram/i_macro
dbGet [dbGet top.insts.cell.name RA1SHD_2048x32M8 -p2].name
dbGet [dbGet top.insts.cell.name RA1SHD_2048x32M8 -p2].cell.size
dbGet [dbGet top.insts.cell.name RA1SHD_2048x32M8 -p2].cell.baseClass
```

**本轮结果：** 步骤命令与对应自动检查已通过；详见`step_03.json`，独立验收范围以该JSON为准。

```json
{
  "step": 3,
  "commands_completed": true,
  "input_manifest_sha256": "c1b350a1f2550de2e21af03963a3450d3a6ad885f83b8e2bc00b99558cf63f6d",
  "automatic_checks": {
    "actual_rc_temperatures_C": {
      "tt_1p80v_25c": 25,
      "ss_pvt": 125,
      "ff0_pvt": 0,
      "ffm40_pvt": -40
    }
  },
  "scope": "Only the listed automatic checks are asserted. Tcl guards also check object counts, IO geometry and halo. Not complete signoff."
}
```

## 04 保存插PAD之前的恢复点

**做什么：** 核对六个逻辑信号端口、确认尚无PAD，保存prePad。

**为什么：** 接下来要改变端口与内部网络关系，出错时可以恢复到清楚的基线。

**预期效果：** 六路接口存在但六个PAD还未摆放；本步不是布局动作。

**关键参数：** `saveDesign`保存数据库及配套.enc.dat；保存文件名不是验收结论。每边为2核心VDD、2核心VSS、1IO VDD、1IO VSS、1POC。

**本轮实际执行片段：** 下列是运行时保存的Tcl正文；宏路径已解析，其他变量结合配置与日志阅读。

`001_04_tcl.tcl`

```tcl
# Actual sourced body; main SRAM resolved to i_mainmem/i_sram/i_macro
dbGet top.terms.name
set prior_pads [dbGet -e top.insts.cell.baseClass pad -p2]
if {[llength $prior_pads] != 0} {error "Unexpected existing PAD"}
saveDesign ../my_soc_top/backup/my_soc_top_prePad.enc
if {[lsort [dbGet top.terms.name]] ne [lsort {clk_i rst_ni tck_i tms_i td_i td_o}]} {error "Unexpected top-level signal ports"}
```

**本轮结果：** 步骤命令与对应自动检查已通过；详见`step_04.json`，独立验收范围以该JSON为准。

```json
{
  "step": 4,
  "commands_completed": true,
  "input_manifest_sha256": "c1b350a1f2550de2e21af03963a3450d3a6ad885f83b8e2bc00b99558cf63f6d",
  "automatic_checks": {
    "actual_rc_temperatures_C": {
      "tt_1p80v_25c": 25,
      "ss_pvt": 125,
      "ff0_pvt": 0,
      "ffm40_pvt": -40
    }
  },
  "scope": "Only the listed automatic checks are asserted. Tcl guards also check object counts, IO geometry and halo. Not complete signoff."
}
```

## 05 摆放四角单元

**做什么：** 在实际裸片四角放置PCORNER并固定方向。

**为什么：** 外围直线单元里的电源轨需要在角部转接，位置和方向都影响连通。

**预期效果：** 四角均fixed且方向正确；这些不是需要计算功能的信号单元。

**关键参数：** 角块115×115 um；东/北边起点分别是实际宽/高减115，方向R0/MY/MX/R180必须与边别对应。

**本轮实际执行片段：** 下列是运行时保存的Tcl正文；宏路径已解析，其他变量结合配置与日志阅读。

`001_05_tcl.tcl`

```tcl
# Actual sourced body; main SRAM resolved to i_mainmem/i_sram/i_macro
addInst -physical -cell PCORNER -inst corner_bottom_left -loc {0.000000 0.000000} -ori R0 -place_status fixed -dontSnapToPlacementGrid
addInst -physical -cell PCORNER -inst corner_bottom_right -loc {1833.240000 0.000000} -ori MY -place_status fixed -dontSnapToPlacementGrid
addInst -physical -cell PCORNER -inst corner_top_left -loc {0.000000 1833.240000} -ori MX -place_status fixed -dontSnapToPlacementGrid
addInst -physical -cell PCORNER -inst corner_top_right -loc {1833.240000 1833.240000} -ori R180 -place_status fixed -dontSnapToPlacementGrid
if {[dbGet [dbGet top.insts.name corner_bottom_left -p].pStatus] ne "fixed" || [dbGet [dbGet top.insts.name corner_bottom_left -p].orient] ne "R0"} {error "Corner placement failed"}
if {[dbGet [dbGet top.insts.name corner_bottom_right -p].pStatus] ne "fixed" || [dbGet [dbGet top.insts.name corner_bottom_right -p].orient] ne "MY"} {error "Corner placement failed"}
if {[dbGet [dbGet top.insts.name corner_top_left -p].pStatus] ne "fixed" || [dbGet [dbGet top.insts.name corner_top_left -p].orient] ne "MX"} {error "Corner placement failed"}
if {[dbGet [dbGet top.insts.name corner_top_right -p].pStatus] ne "fixed" || [dbGet [dbGet top.insts.name corner_top_right -p].orient] ne "R180"} {error "Corner placement failed"}
```

**本轮结果：** 步骤命令与对应自动检查已通过；详见`step_05.json`，独立验收范围以该JSON为准。

```json
{
  "step": 5,
  "commands_completed": true,
  "input_manifest_sha256": "c1b350a1f2550de2e21af03963a3450d3a6ad885f83b8e2bc00b99558cf63f6d",
  "automatic_checks": {
    "actual_rc_temperatures_C": {
      "tt_1p80v_25c": 25,
      "ss_pvt": 125,
      "ff0_pvt": 0,
      "ffm40_pvt": -40
    }
  },
  "scope": "Only the listed automatic checks are asserted. Tcl guards also check object counts, IO geometry and halo. Not complete signoff."
}
```

## 06 把IO时间模型纳入分析

**做什么：** 在核心与SRAM时间库上增加IO库，并激活func_tt_io分析视图。

**为什么：** 信号经过PAD也需要时间；只放几何而没启用时间模型会漏算延时。

**预期效果：** Setup/Hold使用包含核心、SRAM与IO的同一单TT视图。

**关键参数：** library_set描述单元延时库，rc_corner描述导线RC，delay_corner把两者组合，analysis_view再加入constraint_mode。本流程明确-si_enabled false。

**本轮实际执行片段：** 下列是运行时保存的Tcl正文；宏路径已解析，其他变量结合配置与日志阅读。

`001_06_tcl.tcl`

```tcl
# Actual sourced body; main SRAM resolved to i_mainmem/i_sram/i_macro
create_library_set -name lib_tt_io -timing [concat $tt_1p80v_25c_libs [list ${io_lib}tc.lib]]
create_delay_corner -name delay_tt_io -library_set lib_tt_io -rc_corner rc_tt_1p80v_25c -si_enabled false
create_analysis_view -name func_tt_io -constraint_mode func -delay_corner delay_tt_io
set_analysis_view -setup {func_tt_io} -hold {func_tt_io}
if {[info exists eda_enable_pvt] && $eda_enable_pvt} {
    set eda_io_views {func_tt_io}
    foreach spec $eda_pvt_specs {
        lassign $spec corner suffix macro_suffix temp voltage short
        create_library_set -name lib_${short}_io -timing [concat $proj(library_set,$corner) [list ${io_lib}${suffix}.lib]]
        create_delay_corner -name delay_${short}_io -library_set lib_${short}_io -rc_corner rc_${corner} -si_enabled false
        create_analysis_view -name func_${short}_io -constraint_mode func -delay_corner delay_${short}_io
        lappend eda_io_views func_${short}_io
    }
    set_analysis_view -setup $eda_io_views -hold $eda_io_views
}
all_analysis_views -type setup
all_analysis_views -type hold
report_analysis_views
```

**本轮结果：** 步骤命令与对应自动检查已通过；详见`step_06.json`，独立验收范围以该JSON为准。

```json
{
  "step": 6,
  "commands_completed": true,
  "input_manifest_sha256": "c1b350a1f2550de2e21af03963a3450d3a6ad885f83b8e2bc00b99558cf63f6d",
  "automatic_checks": {
    "actual_rc_temperatures_C": {
      "tt_1p80v_25c": 25,
      "ss_pvt": 125,
      "ff0_pvt": 0,
      "ffm40_pvt": -40
    }
  },
  "scope": "Only the listed automatic checks are asserted. Tcl guards also check object counts, IO geometry and halo. Not complete signoff."
}
```

## 07 摆放六个信号PAD

**做什么：** 按io_plan.json把clk/rst放北边，四路JTAG放南边。

**为什么：** 外部接口需要真实输入输出电路，不能把RTL端口名当作完整外围。

**预期效果：** 六个PDDW0204CDG实例都有位置且fixed，但下一步才接内部信号。

**关键参数：** 每个PAD60×115 um，北边R180、南边R0。沿边偏移取io_plan.json；北边y=实际高度−115，不能沿用旧1685.4。

**本轮实际执行片段：** 下列是运行时保存的Tcl正文；宏路径已解析，其他变量结合配置与日志阅读。

`001_07_tcl.tcl`

```tcl
# Actual sourced body; main SRAM resolved to i_mainmem/i_sram/i_macro
addInst -cell PDDW0204CDG -inst i_pad_clk -loc {300.000000 1833.240000} -ori R180 -place_status fixed -dontSnapToPlacementGrid
addInst -cell PDDW0204CDG -inst i_pad_rst_n -loc {1400.000000 1833.240000} -ori R180 -place_status fixed -dontSnapToPlacementGrid
addInst -cell PDDW0204CDG -inst i_pad_tck -loc {250.000000 0.000000} -ori R0 -place_status fixed -dontSnapToPlacementGrid
addInst -cell PDDW0204CDG -inst i_pad_tms -loc {450.000000 0.000000} -ori R0 -place_status fixed -dontSnapToPlacementGrid
addInst -cell PDDW0204CDG -inst i_pad_tdi -loc {1400.000000 0.000000} -ori R0 -place_status fixed -dontSnapToPlacementGrid
addInst -cell PDDW1216CDG -inst i_pad_tdo -loc {1600.000000 0.000000} -ori R0 -place_status fixed -dontSnapToPlacementGrid
if {[dbGet [dbGet top.insts.name i_pad_clk -p].cell.name] ne "PDDW0204CDG"} {error "Signal PAD master mismatch"}
if {[dbGet [dbGet top.insts.name i_pad_rst_n -p].cell.name] ne "PDDW0204CDG"} {error "Signal PAD master mismatch"}
if {[dbGet [dbGet top.insts.name i_pad_tck -p].cell.name] ne "PDDW0204CDG"} {error "Signal PAD master mismatch"}
if {[dbGet [dbGet top.insts.name i_pad_tms -p].cell.name] ne "PDDW0204CDG"} {error "Signal PAD master mismatch"}
if {[dbGet [dbGet top.insts.name i_pad_tdi -p].cell.name] ne "PDDW0204CDG"} {error "Signal PAD master mismatch"}
if {[dbGet [dbGet top.insts.name i_pad_tdo -p].cell.name] ne "PDDW1216CDG"} {error "Signal PAD master mismatch"}
if {[llength [dbGet -e top.insts.cell.name PDDW0204CDG -p2]] != 5 || [llength [dbGet -e top.insts.cell.name PDDW1216CDG -p2]] != 1} {error "Signal PAD count mismatch"}
```

**本轮结果：** 步骤命令与对应自动检查已通过；详见`step_07.json`，独立验收范围以该JSON为准。

```json
{
  "step": 7,
  "commands_completed": true,
  "input_manifest_sha256": "c1b350a1f2550de2e21af03963a3450d3a6ad885f83b8e2bc00b99558cf63f6d",
  "automatic_checks": {
    "actual_rc_temperatures_C": {
      "tt_1p80v_25c": 25,
      "ss_pvt": 125,
      "ff0_pvt": 0,
      "ffm40_pvt": -40
    }
  },
  "scope": "Only the listed automatic checks are asserted. Tcl guards also check object counts, IO geometry and halo. Not complete signoff."
}
```

## 08 连接PAD与核心

**做什么：** 先记录内部单元引脚，再把顶层端口转到外侧网络，从原引脚找到拆分后的内部网络，连接PAD/C/I及控制脚。

**为什么：** 输入应先经过接收电路，输出应经过发送电路；原内部端点必须一个不漏。

**预期效果：** 导出改接网表并与综合网表比较，六路外侧只连接各自PAD。

**关键参数：** 输入PAD：OEN=1关闭输出，IE=1开启输入，I/PE/DS=0。输出PAD：I接核心输出，OEN=0开启输出，IE/PE/DS=0。PAD是外侧端，C是接收输出，I是发送输入，不能混接。

**本轮实际执行片段：** 下列是运行时保存的Tcl正文；宏路径已解析，其他变量结合配置与日志阅读。

`001_08_tcl.tcl`

```tcl
# Actual sourced body; main SRAM resolved to i_mainmem/i_sram/i_macro
set eda_term [dbGet top.terms.name clk_i -p]
set eda_core_object [dbGet $eda_term.net]
set eda_core_anchor [lindex [dbGet -e $eda_core_object.instTerms] 0]
if {$eda_core_anchor in {{} 0x0}} {error "Signal has no internal pin anchor"}
addNet clk_i_pad
detachModulePort - clk_i
attachModulePort - clk_i clk_i_pad
set eda_core_net [dbGet $eda_core_anchor.net.name]
set eda_ext_net [dbGet [dbGet top.terms.name clk_i -p].net.name]
if {$eda_core_net in {{} 0x0} || $eda_ext_net in {{} 0x0} || $eda_core_net eq $eda_ext_net} {error "Invalid core/PAD split"}
attachTerm i_pad_clk PAD $eda_ext_net
attachTerm i_pad_clk C $eda_core_net
attachTerm i_pad_clk OEN 1'b1
attachTerm i_pad_clk IE 1'b1
attachTerm i_pad_clk PE 1'b0
attachTerm i_pad_clk DS 1'b0
attachTerm i_pad_clk I 1'b0
set eda_term [dbGet top.terms.name rst_ni -p]
set eda_core_object [dbGet $eda_term.net]
set eda_core_anchor [lindex [dbGet -e $eda_core_object.instTerms] 0]
if {$eda_core_anchor in {{} 0x0}} {error "Signal has no internal pin anchor"}
addNet rst_ni_pad
detachModulePort - rst_ni
attachModulePort - rst_ni rst_ni_pad
set eda_core_net [dbGet $eda_core_anchor.net.name]
set eda_ext_net [dbGet [dbGet top.terms.name rst_ni -p].net.name]
if {$eda_core_net in {{} 0x0} || $eda_ext_net in {{} 0x0} || $eda_core_net eq $eda_ext_net} {error "Invalid core/PAD split"}
attachTerm i_pad_rst_n PAD $eda_ext_net
attachTerm i_pad_rst_n C $eda_core_net
attachTerm i_pad_rst_n OEN 1'b1
attachTerm i_pad_rst_n IE 1'b1
attachTerm i_pad_rst_n PE 1'b0
attachTerm i_pad_rst_n DS 1'b0
attachTerm i_pad_rst_n I 1'b0
set eda_term [dbGet top.terms.name tck_i -p]
set eda_core_object [dbGet $eda_term.net]
set eda_core_anchor [lindex [dbGet -e $eda_core_object.instTerms] 0]
if {$eda_core_anchor in {{} 0x0}} {error "Signal has no internal pin anchor"}
addNet tck_i_pad
detachModulePort - tck_i
attachModulePort - tck_i tck_i_pad
set eda_core_net [dbGet $eda_core_anchor.net.name]
set eda_ext_net [dbGet [dbGet top.terms.name tck_i -p].net.name]
if {$eda_core_net in {{} 0x0} || $eda_ext_net in {{} 0x0} || $eda_core_net eq $eda_ext_net} {error "Invalid core/PAD split"}
attachTerm i_pad_tck PAD $eda_ext_net
attachTerm i_pad_tck C $eda_core_net
attachTerm i_pad_tck OEN 1'b1
attachTerm i_pad_tck IE 1'b1
attachTerm i_pad_tck PE 1'b0
attachTerm i_pad_tck DS 1'b0
attachTerm i_pad_tck I 1'b0
set eda_term [dbGet top.terms.name tms_i -p]
set eda_core_object [dbGet $eda_term.net]
set eda_core_anchor [lindex [dbGet -e $eda_core_object.instTerms] 0]
if {$eda_core_anchor in {{} 0x0}} {error "Signal has no internal pin anchor"}
addNet tms_i_pad
detachModulePort - tms_i
attachModulePort - tms_i tms_i_pad
set eda_core_net [dbGet $eda_core_anchor.net.name]
set eda_ext_net [dbGet [dbGet top.terms.name tms_i -p].net.name]
if {$eda_core_net in {{} 0x0} || $eda_ext_net in {{} 0x0} || $eda_core_net eq $eda_ext_net} {error "Invalid core/PAD split"}
attachTerm i_pad_tms PAD $eda_ext_net
attachTerm i_pad_tms C $eda_core_net
attachTerm i_pad_tms OEN 1'b1
attachTerm i_pad_tms IE 1'b1
attachTerm i_pad_tms PE 1'b0
attachTerm i_pad_tms DS 1'b0
attachTerm i_pad_tms I 1'b0
set eda_term [dbGet top.terms.name td_i -p]
set eda_core_object [dbGet $eda_term.net]
set eda_core_anchor [lindex [dbGet -e $eda_core_object.instTerms] 0]
if {$eda_core_anchor in {{} 0x0}} {error "Signal has no internal pin anchor"}
addNet td_i_pad
detachModulePort - td_i
attachModulePort - td_i td_i_pad
set eda_core_net [dbGet $eda_core_anchor.net.name]
set eda_ext_net [dbGet [dbGet top.terms.name td_i -p].net.name]
if {$eda_core_net in {{} 0x0} || $eda_ext_net in {{} 0x0} || $eda_core_net eq $eda_ext_net} {error "Invalid core/PAD split"}
attachTerm i_pad_tdi PAD $eda_ext_net
attachTerm i_pad_tdi C $eda_core_net
attachTerm i_pad_tdi OEN 1'b1
attachTerm i_pad_tdi IE 1'b1
attachTerm i_pad_tdi PE 1'b0
attachTerm i_pad_tdi DS 1'b0
attachTerm i_pad_tdi I 1'b0
set eda_term [dbGet top.terms.name td_o -p]
set eda_core_object [dbGet $eda_term.net]
set eda_core_anchor [lindex [dbGet -e $eda_core_object.instTerms] 0]
if {$eda_core_anchor in {{} 0x0}} {error "Signal has no internal pin anchor"}
addNet td_o_pad
detachModulePort - td_o
attachModulePort - td_o td_o_pad
set eda_core_net [dbGet $eda_core_anchor.net.name]
set eda_ext_net [dbGet [dbGet top.terms.name td_o -p].net.name]
if {$eda_core_net in {{} 0x0} || $eda_ext_net in {{} 0x0} || $eda_core_net eq $eda_ext_net} {error "Invalid core/PAD split"}
attachTerm i_pad_tdo PAD $eda_ext_net
attachTerm i_pad_tdo I $eda_core_net
attachTerm i_pad_tdo OEN 1'b0
attachTerm i_pad_tdo IE 1'b0
attachTerm i_pad_tdo PE 1'b0
attachTerm i_pad_tdo DS 1'b0
saveNetlist ../my_soc_top/my_soc_top_io_connected.v
```

**本轮结果：** 步骤命令与对应自动检查已通过；详见`step_08.json`，独立验收范围以该JSON为准。

```json
{
  "step": 8,
  "commands_completed": true,
  "input_manifest_sha256": "c1b350a1f2550de2e21af03963a3450d3a6ad885f83b8e2bc00b99558cf63f6d",
  "automatic_checks": {
    "actual_rc_temperatures_C": {
      "tt_1p80v_25c": 25,
      "ss_pvt": 125,
      "ff0_pvt": 0,
      "ffm40_pvt": -40
    },
    "topology": {
      "program": "audit_io_topology.py",
      "exit_code": 0
    }
  },
  "scope": "Only the listed automatic checks are asserted. Tcl guards also check object counts, IO geometry and halo. Not complete signoff."
}
```

## 09 摆放供电与上电控制PAD

**做什么：** 四边各放七个供电/POC单元，并按实际坐标登记IO侧别。

**为什么：** 后续外围填充依赖正确侧别；核心电源和IO电源的作用与网络不能混淆。

**预期效果：** 新增28个单元，IO登记前后位置不变，角块/边别通过几何检查。

**关键参数：** 每边2个核心VDD、2个核心VSS、1个IO VDD、1个IO VSS、1个POC；默认沿边偏移600到1200 um。loadIoFile只登记指定对象，不调整Die。

**本轮实际执行片段：** 下列是运行时保存的Tcl正文；宏路径已解析，其他变量结合配置与日志阅读。

`001_09_tcl.tcl`

```tcl
# Actual sourced body; main SRAM resolved to i_mainmem/i_sram/i_macro
addInst -cell PVSS1CDG -inst i_pad_N_vss_1 -loc {600.000000 1833.240000} -ori R180 -place_status fixed -dontSnapToPlacementGrid
addInst -cell PVSS1CDG -inst i_pad_N_vss_2 -loc {700.000000 1833.240000} -ori R180 -place_status fixed -dontSnapToPlacementGrid
addInst -cell PVSS2CDG -inst i_pad_N_vssio -loc {800.000000 1833.240000} -ori R180 -place_status fixed -dontSnapToPlacementGrid
addInst -cell PVDD1CDG -inst i_pad_N_vdd_1 -loc {900.000000 1833.240000} -ori R180 -place_status fixed -dontSnapToPlacementGrid
addInst -cell PVDD1CDG -inst i_pad_N_vdd_2 -loc {1000.000000 1833.240000} -ori R180 -place_status fixed -dontSnapToPlacementGrid
addInst -cell PVDD2CDG -inst i_pad_N_vddio -loc {1100.000000 1833.240000} -ori R180 -place_status fixed -dontSnapToPlacementGrid
addInst -cell PVDD2POC -inst i_pad_N_poc -loc {1200.000000 1833.240000} -ori R180 -place_status fixed -dontSnapToPlacementGrid
addInst -cell PVSS1CDG -inst i_pad_S_vss_1 -loc {600.000000 0.000000} -ori R0 -place_status fixed -dontSnapToPlacementGrid
addInst -cell PVSS1CDG -inst i_pad_S_vss_2 -loc {700.000000 0.000000} -ori R0 -place_status fixed -dontSnapToPlacementGrid
addInst -cell PVSS2CDG -inst i_pad_S_vssio -loc {800.000000 0.000000} -ori R0 -place_status fixed -dontSnapToPlacementGrid
addInst -cell PVDD1CDG -inst i_pad_S_vdd_1 -loc {900.000000 0.000000} -ori R0 -place_status fixed -dontSnapToPlacementGrid
addInst -cell PVDD1CDG -inst i_pad_S_vdd_2 -loc {1000.000000 0.000000} -ori R0 -place_status fixed -dontSnapToPlacementGrid
addInst -cell PVDD2CDG -inst i_pad_S_vddio -loc {1100.000000 0.000000} -ori R0 -place_status fixed -dontSnapToPlacementGrid
addInst -cell PVDD2POC -inst i_pad_S_poc -loc {1200.000000 0.000000} -ori R0 -place_status fixed -dontSnapToPlacementGrid
addInst -cell PVSS1CDG -inst i_pad_W_vss_1 -loc {0.000000 600.000000} -ori R270 -place_status fixed -dontSnapToPlacementGrid
addInst -cell PVSS1CDG -inst i_pad_W_vss_2 -loc {0.000000 700.000000} -ori R270 -place_status fixed -dontSnapToPlacementGrid
addInst -cell PVSS2CDG -inst i_pad_W_vssio -loc {0.000000 800.000000} -ori R270 -place_status fixed -dontSnapToPlacementGrid
addInst -cell PVDD1CDG -inst i_pad_W_vdd_1 -loc {0.000000 900.000000} -ori R270 -place_status fixed -dontSnapToPlacementGrid
addInst -cell PVDD1CDG -inst i_pad_W_vdd_2 -loc {0.000000 1000.000000} -ori R270 -place_status fixed -dontSnapToPlacementGrid
addInst -cell PVDD2CDG -inst i_pad_W_vddio -loc {0.000000 1100.000000} -ori R270 -place_status fixed -dontSnapToPlacementGrid
addInst -cell PVDD2POC -inst i_pad_W_poc -loc {0.000000 1200.000000} -ori R270 -place_status fixed -dontSnapToPlacementGrid
addInst -cell PVSS1CDG -inst i_pad_E_vss_1 -loc {1833.240000 600.000000} -ori R90 -place_status fixed -dontSnapToPlacementGrid
addInst -cell PVSS1CDG -inst i_pad_E_vss_2 -loc {1833.240000 700.000000} -ori R90 -place_status fixed -dontSnapToPlacementGrid
addInst -cell PVSS2CDG -inst i_pad_E_vssio -loc {1833.240000 800.000000} -ori R90 -place_status fixed -dontSnapToPlacementGrid
addInst -cell PVDD1CDG -inst i_pad_E_vdd_1 -loc {1833.240000 900.000000} -ori R90 -place_status fixed -dontSnapToPlacementGrid
addInst -cell PVDD1CDG -inst i_pad_E_vdd_2 -loc {1833.240000 1000.000000} -ori R90 -place_status fixed -dontSnapToPlacementGrid
addInst -cell PVDD2CDG -inst i_pad_E_vddio -loc {1833.240000 1100.000000} -ori R90 -place_status fixed -dontSnapToPlacementGrid
addInst -cell PVDD2POC -inst i_pad_E_poc -loc {1833.240000 1200.000000} -ori R90 -place_status fixed -dontSnapToPlacementGrid
puts "POWER_PAD_COUNT [llength [dbGet -e top.insts.name i_pad_?_*]]"
saveIoFile -locations -includeCellName ../my_soc_top/my_soc_top_io_beforeFiller.io

saveDesign ../my_soc_top/backup/my_soc_top_preIORegistration.enc
set io_die [lindex [dbGet top.fPlan.box] 0]
lassign $io_die io_dx0 io_dy0 io_dx1 io_dy1
set io_tol 0.001
set io_rows [dict create top {} bottom {} left {} right {}]
set io_corners [dict create]
set io_before [dict create]
foreach io_inst [dbGet top.insts] {
    set io_class [dbGet $io_inst.cell.baseClass]
    if {$io_class ni {pad corner}} {continue}
    set io_subclass [dbGet $io_inst.cell.subClass]
    if {[string match -nocase *spacer* $io_subclass]} {continue}
    set io_name [dbGet $io_inst.name]
    set io_cell [dbGet $io_inst.cell.name]
    if {[regexp {["\\]} "$io_name$io_cell"]} {
        error "Unsupported quote/backslash in IO name or master: $io_name"
    }
    if {[dbGet $io_inst.pStatus] ne "fixed"} {
        error "IO must be fixed before registration: $io_name"
    }
    set io_box [lindex [dbGet $io_inst.box] 0]
    lassign $io_box io_x0 io_y0 io_x1 io_y1
    set io_ori [dbGet $io_inst.orient]
    if {$io_x0 < $io_dx0-$io_tol || $io_y0 < $io_dy0-$io_tol ||
        $io_x1 > $io_dx1+$io_tol || $io_y1 > $io_dy1+$io_tol} {
        error "IO outside measured Die: $io_name"
    }
    dict set io_before $io_name [list $io_box $io_ori]
    if {$io_class eq "corner"} {
        set io_horizontal ""
        set io_vertical ""
        if {abs($io_x0-$io_dx0) < $io_tol} {set io_horizontal left}
        if {abs($io_x1-$io_dx1) < $io_tol} {set io_horizontal right}
        if {abs($io_y0-$io_dy0) < $io_tol} {set io_vertical bottom}
        if {abs($io_y1-$io_dy1) < $io_tol} {set io_vertical top}
        if {$io_horizontal eq "" || $io_vertical eq ""} {
            error "Corner does not touch a rectangle corner: $io_name"
        }
        set io_side "$io_vertical$io_horizontal"
        if {[dict exists $io_corners $io_side]} {
            error "Duplicate corner side: $io_side"
        }
        dict set io_corners $io_side [list $io_name $io_cell $io_ori]
    } else {
        set io_distances [list \
            [list [expr {abs($io_y0-$io_dy0)}] bottom] \
            [list [expr {abs($io_dy1-$io_y1)}] top] \
            [list [expr {abs($io_x0-$io_dx0)}] left] \
            [list [expr {abs($io_dx1-$io_x1)}] right]]
        set io_distances [lsort -real -index 0 $io_distances]
        set io_indent [lindex $io_distances 0 0]
        if {[lindex $io_distances 1 0]-$io_indent < $io_tol} {
            error "IO side is ambiguous from physical box: $io_name"
        }
        set io_side [lindex $io_distances 0 1]
        if {$io_side in {top bottom}} {
            set io_offset [expr {$io_x0-$io_dx0}]
        } else {
            set io_offset [expr {$io_y0-$io_dy0}]
        }
        dict lappend io_rows $io_side [list $io_offset $io_name $io_cell $io_indent $io_ori]
    }
}
if {[dict size $io_corners] != 4} {
    error "Expected exactly four corners in this perimeter"
}
set io_count 0
foreach io_side {top bottom left right} {
    set io_side_count [llength [dict get $io_rows $io_side]]
    incr io_count $io_side_count
    puts "$io_side : $io_side_count PAD"
}
if {$io_count == 0} {error "No CLASS PAD instances; check native LEF"}
set io_tmp_path ../my_soc_top/io_registration_tmp.io
set io_fd [open $io_tmp_path w]
puts $io_fd "(globals\n version = 3\n io_order = default\n)\n(iopad"
foreach io_side {topright top topleft left bottomleft bottom bottomright right} {
    puts $io_fd " ($io_side"
    if {[dict exists $io_corners $io_side]} {
        lassign [dict get $io_corners $io_side] io_name io_cell io_ori
        puts $io_fd [format {  (inst name="%s" cell="%s" orientation=%s place_status=fixed)} $io_name $io_cell $io_ori]
    } else {
        foreach io_row [lsort -real -index 0 [dict get $io_rows $io_side]] {
            lassign $io_row io_offset io_name io_cell io_indent io_ori
            puts $io_fd [format {  (inst name="%s" cell="%s" offset=%.6f indent=%.6f orientation=%s place_status=fixed)} $io_name $io_cell $io_offset $io_indent $io_ori]
        }
    }
    puts $io_fd " )"
}
puts $io_fd ")"
close $io_fd

loadIoFile $io_tmp_path -noAdjustDieSize -specifiedIosOnly
foreach io_name [dict keys $io_before] {
    set io_inst [dbGet top.insts.name $io_name -p]
    lassign [dict get $io_before $io_name] io_old_box io_old_ori
    set io_new_box [lindex [dbGet $io_inst.box] 0]
    foreach io_old_value $io_old_box io_new_value $io_new_box {
        if {abs($io_old_value-$io_new_value) > $io_tol} {
            error "IO moved during side registration: $io_name"
        }
    }
    if {[dbGet $io_inst.orient] ne $io_old_ori} {
        error "IO orientation changed during side registration: $io_name"
    }
}
file delete $io_tmp_path
saveIoFile -locations -includeCellName ../my_soc_top/my_soc_top_io_registered.io
defOut ../my_soc_top/my_soc_top_io_registered.def

dbGet top.fPlan.box
```

**本轮结果：** 步骤命令与对应自动检查已通过；详见`step_09.json`，独立验收范围以该JSON为准。

```json
{
  "step": 9,
  "commands_completed": true,
  "input_manifest_sha256": "c1b350a1f2550de2e21af03963a3450d3a6ad885f83b8e2bc00b99558cf63f6d",
  "automatic_checks": {
    "actual_rc_temperatures_C": {
      "tt_1p80v_25c": 25,
      "ss_pvt": 125,
      "ff0_pvt": 0,
      "ffm40_pvt": -40
    }
  },
  "scope": "Only the listed automatic checks are asserted. Tcl guards also check object counts, IO geometry and halo. Not complete signoff."
}
```

## 10 摆放键合焊盘

**做什么：** 为六个信号和28个供电/POC单元放34个Bond PAD。

**为什么：** IO PAD提供电路，Bond PAD提供封装金线接触的大金属，两者需要对齐。

**预期效果：** 34个键合焊盘与对应IO覆盖，这些预期覆盖区别于普通单元碰撞。

**关键参数：** Bond使用PAD60LU_OBV，沿边与对应IO一致；北/东边按实际尺寸和73.16 um深度计算，覆盖对应PAD是设计意图。

**本轮实际执行片段：** 下列是运行时保存的Tcl正文；宏路径已解析，其他变量结合配置与日志阅读。

`001_10_tcl.tcl`

```tcl
# Actual sourced body; main SRAM resolved to i_mainmem/i_sram/i_macro
addInst -physical -cell PAD60LU_OBV -inst i_bond_clk -loc {300.000000 1875.080000} -ori R180 -place_status fixed -dontSnapToPlacementGrid
addInst -physical -cell PAD60LU_OBV -inst i_bond_rst_n -loc {1400.000000 1875.080000} -ori R180 -place_status fixed -dontSnapToPlacementGrid
addInst -physical -cell PAD60LU_OBV -inst i_bond_tck -loc {250.000000 0.000000} -ori R0 -place_status fixed -dontSnapToPlacementGrid
addInst -physical -cell PAD60LU_OBV -inst i_bond_tms -loc {450.000000 0.000000} -ori R0 -place_status fixed -dontSnapToPlacementGrid
addInst -physical -cell PAD60LU_OBV -inst i_bond_tdi -loc {1400.000000 0.000000} -ori R0 -place_status fixed -dontSnapToPlacementGrid
addInst -physical -cell PAD60LU_OBV -inst i_bond_tdo -loc {1600.000000 0.000000} -ori R0 -place_status fixed -dontSnapToPlacementGrid
addInst -physical -cell PAD60LU_OBV -inst i_bond_N_vss_1 -loc {600.000000 1875.080000} -ori R180 -place_status fixed -dontSnapToPlacementGrid
addInst -physical -cell PAD60LU_OBV -inst i_bond_N_vss_2 -loc {700.000000 1875.080000} -ori R180 -place_status fixed -dontSnapToPlacementGrid
addInst -physical -cell PAD60LU_OBV -inst i_bond_N_vssio -loc {800.000000 1875.080000} -ori R180 -place_status fixed -dontSnapToPlacementGrid
addInst -physical -cell PAD60LU_OBV -inst i_bond_N_vdd_1 -loc {900.000000 1875.080000} -ori R180 -place_status fixed -dontSnapToPlacementGrid
addInst -physical -cell PAD60LU_OBV -inst i_bond_N_vdd_2 -loc {1000.000000 1875.080000} -ori R180 -place_status fixed -dontSnapToPlacementGrid
addInst -physical -cell PAD60LU_OBV -inst i_bond_N_vddio -loc {1100.000000 1875.080000} -ori R180 -place_status fixed -dontSnapToPlacementGrid
addInst -physical -cell PAD60LU_OBV -inst i_bond_N_poc -loc {1200.000000 1875.080000} -ori R180 -place_status fixed -dontSnapToPlacementGrid
addInst -physical -cell PAD60LU_OBV -inst i_bond_S_vss_1 -loc {600.000000 0.000000} -ori R0 -place_status fixed -dontSnapToPlacementGrid
addInst -physical -cell PAD60LU_OBV -inst i_bond_S_vss_2 -loc {700.000000 0.000000} -ori R0 -place_status fixed -dontSnapToPlacementGrid
addInst -physical -cell PAD60LU_OBV -inst i_bond_S_vssio -loc {800.000000 0.000000} -ori R0 -place_status fixed -dontSnapToPlacementGrid
addInst -physical -cell PAD60LU_OBV -inst i_bond_S_vdd_1 -loc {900.000000 0.000000} -ori R0 -place_status fixed -dontSnapToPlacementGrid
addInst -physical -cell PAD60LU_OBV -inst i_bond_S_vdd_2 -loc {1000.000000 0.000000} -ori R0 -place_status fixed -dontSnapToPlacementGrid
addInst -physical -cell PAD60LU_OBV -inst i_bond_S_vddio -loc {1100.000000 0.000000} -ori R0 -place_status fixed -dontSnapToPlacementGrid
addInst -physical -cell PAD60LU_OBV -inst i_bond_S_poc -loc {1200.000000 0.000000} -ori R0 -place_status fixed -dontSnapToPlacementGrid
addInst -physical -cell PAD60LU_OBV -inst i_bond_W_vss_1 -loc {0.000000 600.000000} -ori R270 -place_status fixed -dontSnapToPlacementGrid
addInst -physical -cell PAD60LU_OBV -inst i_bond_W_vss_2 -loc {0.000000 700.000000} -ori R270 -place_status fixed -dontSnapToPlacementGrid
addInst -physical -cell PAD60LU_OBV -inst i_bond_W_vssio -loc {0.000000 800.000000} -ori R270 -place_status fixed -dontSnapToPlacementGrid
addInst -physical -cell PAD60LU_OBV -inst i_bond_W_vdd_1 -loc {0.000000 900.000000} -ori R270 -place_status fixed -dontSnapToPlacementGrid
addInst -physical -cell PAD60LU_OBV -inst i_bond_W_vdd_2 -loc {0.000000 1000.000000} -ori R270 -place_status fixed -dontSnapToPlacementGrid
addInst -physical -cell PAD60LU_OBV -inst i_bond_W_vddio -loc {0.000000 1100.000000} -ori R270 -place_status fixed -dontSnapToPlacementGrid
addInst -physical -cell PAD60LU_OBV -inst i_bond_W_poc -loc {0.000000 1200.000000} -ori R270 -place_status fixed -dontSnapToPlacementGrid
addInst -physical -cell PAD60LU_OBV -inst i_bond_E_vss_1 -loc {1875.080000 600.000000} -ori R90 -place_status fixed -dontSnapToPlacementGrid
addInst -physical -cell PAD60LU_OBV -inst i_bond_E_vss_2 -loc {1875.080000 700.000000} -ori R90 -place_status fixed -dontSnapToPlacementGrid
addInst -physical -cell PAD60LU_OBV -inst i_bond_E_vssio -loc {1875.080000 800.000000} -ori R90 -place_status fixed -dontSnapToPlacementGrid
addInst -physical -cell PAD60LU_OBV -inst i_bond_E_vdd_1 -loc {1875.080000 900.000000} -ori R90 -place_status fixed -dontSnapToPlacementGrid
addInst -physical -cell PAD60LU_OBV -inst i_bond_E_vdd_2 -loc {1875.080000 1000.000000} -ori R90 -place_status fixed -dontSnapToPlacementGrid
addInst -physical -cell PAD60LU_OBV -inst i_bond_E_vddio -loc {1875.080000 1100.000000} -ori R90 -place_status fixed -dontSnapToPlacementGrid
addInst -physical -cell PAD60LU_OBV -inst i_bond_E_poc -loc {1875.080000 1200.000000} -ori R90 -place_status fixed -dontSnapToPlacementGrid
if {[llength [dbGet -e top.insts.cell.name PAD60LU_OBV -p2]] != 34} {error "Bond PAD count mismatch"}
```

**本轮结果：** 步骤命令与对应自动检查已通过；详见`step_10.json`，独立验收范围以该JSON为准。

```json
{
  "step": 10,
  "commands_completed": true,
  "input_manifest_sha256": "c1b350a1f2550de2e21af03963a3450d3a6ad885f83b8e2bc00b99558cf63f6d",
  "automatic_checks": {
    "actual_rc_temperatures_C": {
      "tt_1p80v_25c": 25,
      "ss_pvt": 125,
      "ff0_pvt": 0,
      "ffm40_pvt": -40
    }
  },
  "scope": "Only the listed automatic checks are asserted. Tcl guards also check object counts, IO geometry and halo. Not complete signoff."
}
```

## 11 绑定四个供电网络

**做什么：** 把核心PG引脚与VDD/VSS绑定，普通IO供电端绑定VDDPST/VSSPST。

**为什么：** 网络归属先正确，后面金属供电才能接对；Tie常量输出不能代替电源。

**预期效果：** 导出物理网表，逐个核对28个供电PAD、12普通端及四网独立。

**关键参数：** globalNetConnect是电气归属绑定，尚未画线。四网保持独立；N/S/W/E每侧vddio、poc接VDDPST，vssio接VSSPST。

**本轮实际执行片段：** 下列是运行时保存的Tcl正文；宏路径已解析，其他变量结合配置与日志阅读。

`001_11_tcl.tcl`

```tcl
# Actual sourced body; main SRAM resolved to i_mainmem/i_sram/i_macro
dbGet top.nets.name VDDPST
dbGet top.nets.name VSSPST

if {[dbGet top.nets.name VDDPST] eq "0x0"} {addNet VDDPST -power}
if {[dbGet top.nets.name VSSPST] eq "0x0"} {addNet VSSPST -ground}
globalNetConnect VDD -type pgpin -pin VDD -all -verbose
globalNetConnect VSS -type pgpin -pin VSS -all -verbose

attachTerm i_pad_N_vddio VDDPST VDDPST
attachTerm i_pad_N_poc VDDPST VDDPST
attachTerm i_pad_N_vssio VSSPST VSSPST
attachTerm i_pad_S_vddio VDDPST VDDPST
attachTerm i_pad_S_poc VDDPST VDDPST
attachTerm i_pad_S_vssio VSSPST VSSPST
attachTerm i_pad_W_vddio VDDPST VDDPST
attachTerm i_pad_W_poc VDDPST VDDPST
attachTerm i_pad_W_vssio VSSPST VSSPST
attachTerm i_pad_E_vddio VDDPST VDDPST
attachTerm i_pad_E_poc VDDPST VDDPST
attachTerm i_pad_E_vssio VSSPST VSSPST

saveNetlist ../my_soc_top/my_soc_top_pg_bound.v -phys
saveDesign ../my_soc_top/backup/my_soc_top_postPGConnect.enc
foreach sn {VDD VSS VDDPST VSSPST} {puts "SUPPLY $sn [dbGet top.nets.name $sn]"}
foreach side {N S W E} {foreach pair {{vddio VDDPST} {poc VDDPST} {vssio VSSPST}} {lassign $pair suffix pin; set it [dbGet top.insts.instTerms.name i_pad_${side}_${suffix}/$pin -p]; set nn [dbGet $it.net.name]; puts "SUPPLY_TERM i_pad_${side}_${suffix}/$pin $nn"; if {$nn ne $pin} {error "Wrong IO supply"}}}
```

**本轮结果：** 步骤命令与对应自动检查已通过；详见`step_11.json`，独立验收范围以该JSON为准。

```json
{
  "step": 11,
  "commands_completed": true,
  "input_manifest_sha256": "c1b350a1f2550de2e21af03963a3450d3a6ad885f83b8e2bc00b99558cf63f6d",
  "automatic_checks": {
    "actual_rc_temperatures_C": {
      "tt_1p80v_25c": 25,
      "ss_pvt": 125,
      "ff0_pvt": 0,
      "ffm40_pvt": -40
    },
    "four_supply_topology": {
      "program": "audit_io_topology.py",
      "exit_code": 0
    }
  },
  "scope": "Only the listed automatic checks are asserted. Tcl guards also check object counts, IO geometry and halo. Not complete signoff."
}
```

## 12 填充外围空隙

**做什么：** 在四边IO之间插入库规定的Filler并逐段检查。

**为什么：** 空隙可能使单元内部的外围供电轨中断，不能只看PAD数目正确。

**预期效果：** 四边从角块到角块连续、无意外间隙/重叠且朝向正确。

**关键参数：** 候选宽度20/10/5/1/0.5/0.005 μm由库决定，工具自动组合；四边使用独立前缀，便于定位和有范围返修。

**本轮实际执行片段：** 下列是运行时保存的Tcl正文；宏路径已解析，其他变量结合配置与日志阅读。

`001_12_tcl.tcl`

```tcl
# Actual sourced body; main SRAM resolved to i_mainmem/i_sram/i_macro
addIoFiller -cell {PFILLER20 PFILLER10 PFILLER5 PFILLER1 PFILLER05 PFILLER0005} -prefix IOF_TOP -side top -fillerOrient R180
addIoFiller -cell {PFILLER20 PFILLER10 PFILLER5 PFILLER1 PFILLER05 PFILLER0005} -prefix IOF_BOTTOM -side bottom -fillerOrient R0
addIoFiller -cell {PFILLER20 PFILLER10 PFILLER5 PFILLER1 PFILLER05 PFILLER0005} -prefix IOF_LEFT -side left -fillerOrient R270
addIoFiller -cell {PFILLER20 PFILLER10 PFILLER5 PFILLER1 PFILLER05 PFILLER0005} -prefix IOF_RIGHT -side right -fillerOrient R90

foreach prefix {IOF_TOP IOF_BOTTOM IOF_LEFT IOF_RIGHT} {puts "IO_FILLER $prefix [llength [dbGet -e top.insts.name ${prefix}*]]"}
defOut ../my_soc_top/my_soc_top_postIOFiller.def
```

`002_12_check_tcl.tcl`

```tcl
# Actual sourced body; main SRAM resolved to i_mainmem/i_sram/i_macro
set io_segments [dict create N {} S {} W {} E {}]
foreach ip [dbGet top.insts.cell.baseClass pad -p2] {
 lassign [lindex [dbGet $ip.box] 0] x0 y0 x1 y1
 if {abs($y1-1948.240000)<0.001} {set side N;set a $x0;set b $x1;set want R180} elseif {abs($y0)<0.001} {set side S;set a $x0;set b $x1;set want R0} elseif {abs($x0)<0.001} {set side W;set a $y0;set b $y1;set want R270} elseif {abs($x1-1948.240000)<0.001} {set side E;set a $y0;set b $y1;set want R90} else {error "PAD not on a Die edge"}
 if {[dbGet $ip.orient] ne $want} {error "Wrong IO orientation"}
 dict lappend io_segments $side [list $a $b [dbGet $ip.name]]
}
foreach side {N S W E} {
 set last 115.0
 foreach seg [lsort -real -index 0 [dict get $io_segments $side]] {lassign $seg a b nm;if {abs($a-$last)>0.001} {error "IO gap/overlap at $side $nm : $last to $a"};set last $b}
 set eda_edge_end [expr {$side in {N S} ? 1833.240000 : 1833.240000}]
 if {abs($last-$eda_edge_end)>0.001} {error "IO edge incomplete"}
 puts "IO_EDGE $side [llength [dict get $io_segments $side]] continuous 115-1685.4 correct_orientation"
}
saveDesign ../my_soc_top/backup/my_soc_top_postIOFiller.enc
```

**本轮结果：** 步骤命令与对应自动检查已通过；详见`step_12.json`，独立验收范围以该JSON为准。

```json
{
  "step": 12,
  "commands_completed": true,
  "input_manifest_sha256": "c1b350a1f2550de2e21af03963a3450d3a6ad885f83b8e2bc00b99558cf63f6d",
  "automatic_checks": {
    "actual_rc_temperatures_C": {
      "tt_1p80v_25c": 25,
      "ss_pvt": 125,
      "ff0_pvt": 0,
      "ffm40_pvt": -40
    }
  },
  "scope": "Only the listed automatic checks are asserted. Tcl guards also check object counts, IO geometry and halo. Not complete signoff."
}
```

## 13 固定主SRAM并留白

**做什么：** 按配置放置唯一主SRAM，增加Halo并核对实际四边留白。

**为什么：** 宏内部几何已固定，旁边要留接线空间；指定26不一定等于实际26。

**预期效果：** 实际留白每边至少20 um，宏和留白在规划允许区域内。

**关键参数：** macro_xy_um默认(250,650)；Halo参数26 um用于补偿本宏LEF边界差异，最终实际四边留白仍必须至少20 um。

**本轮实际执行片段：** 下列是运行时保存的Tcl正文；宏路径已解析，其他变量结合配置与日志阅读。

`001_13_tcl.tcl`

```tcl
# Actual sourced body; main SRAM resolved to i_mainmem/i_sram/i_macro
placeInstance i_mainmem/i_sram/i_macro 250.000000 650.000000 R0 -fixed
addHaloToBlock 26 26 26 26 i_mainmem/i_sram/i_macro -snapToSite
dbGet [dbGet top.insts.name i_mainmem/i_sram/i_macro -p].box
dbGet [dbGet top.insts.name i_mainmem/i_sram/i_macro -p].pHaloBox
checkFPlan -reportUtil -outFile ../my_soc_top/my_soc_top_floorplan_check.rpt

set mb [lindex [dbGet [dbGet top.insts.name i_mainmem/i_sram/i_macro -p].box] 0]
set hb [lindex [dbGet [dbGet top.insts.name i_mainmem/i_sram/i_macro -p].pHaloBox] 0]
lassign $mb mx0 my0 mx1 my1
lassign $hb hx0 hy0 hx1 hy1
set hm [list [expr {$mx0-$hx0}] [expr {$my0-$hy0}] [expr {$hx1-$mx1}] [expr {$hy1-$my1}]]
puts "ACTUAL_HALO_MARGINS $hm"
foreach m $hm {if {$m<20.0} {error "SRAM halo is less than 20 um"}}
saveDesign ../my_soc_top/backup/my_soc_top_postMacroPlace.enc
```

**本轮结果：** 步骤命令与对应自动检查已通过；详见`step_13.json`，独立验收范围以该JSON为准。

```json
{
  "step": 13,
  "commands_completed": true,
  "input_manifest_sha256": "c1b350a1f2550de2e21af03963a3450d3a6ad885f83b8e2bc00b99558cf63f6d",
  "automatic_checks": {
    "actual_rc_temperatures_C": {
      "tt_1p80v_25c": 25,
      "ss_pvt": 125,
      "ff0_pvt": 0,
      "ffm40_pvt": -40
    }
  },
  "scope": "Only the listed automatic checks are asserted. Tcl guards also check object counts, IO geometry and halo. Not complete signoff."
}
```

## 14 建立顶层物理端口

**做什么：** 为六个信号与四个电源接口创建明确的M4矩形。

**为什么：** 逻辑端口只表示接口名称，DEF/LEF/GDS还需要知道哪层金属、哪个位置。

**预期效果：** 十个端口的矩形、方向和用途与当前geometry计划一致。

**关键参数：** 十个M4矩形均10×1 um，位置跟随实际Die与PAD偏移；五INPUT、一OUTPUT、四INOUT，电源USE正确。

**本轮实际执行片段：** 下列是运行时保存的Tcl正文；宏路径已解析，其他变量结合配置与日志阅读。

`001_14_tcl.tcl`

```tcl
# Actual sourced body; main SRAM resolved to i_mainmem/i_sram/i_macro
createPhysicalPin clk_i -net clk_i -layer METAL4 -rect {310.000000 1945.840000 320.000000 1946.840000}
createPhysicalPin rst_ni -net rst_ni -layer METAL4 -rect {1410.000000 1945.840000 1420.000000 1946.840000}
createPhysicalPin tck_i -net tck_i -layer METAL4 -rect {260.000000 1.000000 270.000000 2.000000}
createPhysicalPin tms_i -net tms_i -layer METAL4 -rect {460.000000 1.000000 470.000000 2.000000}
createPhysicalPin td_i -net td_i -layer METAL4 -rect {1410.000000 1.000000 1420.000000 2.000000}
createPhysicalPin td_o -net td_o -layer METAL4 -rect {1610.000000 1.000000 1620.000000 2.000000}
createPGPin VDD -net VDD -geom METAL4 910.000000 1945.840000 920.000000 1946.840000
createPGPin VSS -net VSS -geom METAL4 610.000000 1945.840000 620.000000 1946.840000
createPGPin VDDPST -net VDDPST -geom METAL4 1110.000000 1945.840000 1120.000000 1946.840000
createPGPin VSSPST -net VSSPST -geom METAL4 810.000000 1945.840000 820.000000 1946.840000
defOut ../my_soc_top/my_soc_top_physicalPins.def
eda_picture 14_floorplan.gif
```

**本轮结果：** 步骤命令与对应自动检查已通过；详见`step_14.json`，独立验收范围以该JSON为准。

```json
{
  "step": 14,
  "commands_completed": true,
  "input_manifest_sha256": "c1b350a1f2550de2e21af03963a3450d3a6ad885f83b8e2bc00b99558cf63f6d",
  "automatic_checks": {
    "actual_rc_temperatures_C": {
      "tt_1p80v_25c": 25,
      "ss_pvt": 125,
      "ff0_pvt": 0,
      "ffm40_pvt": -40
    },
    "physical_pins": {
      "ports": [
        "VDD",
        "VDDPST",
        "VSS",
        "VSSPST",
        "clk_i",
        "rst_ni",
        "tck_i",
        "td_i",
        "td_o",
        "tms_i"
      ],
      "dbu_per_um": 2000,
      "all_rectangles_directions_uses_match_geometry_plan": true
    }
  },
  "scope": "Only the listed automatic checks are asserted. Tcl guards also check object counts, IO geometry and halo. Not complete signoff."
}
```

## 15 建立核心及SRAM电源环

**做什么：** 用M4/M5在核心和宏周围生成VDD/VSS环。

**为什么：** 供电需要较低阻抗的分配骨架，环提供后续条带和引脚接入目标。

**预期效果：** 环的特殊布线DRC通过；此时还不表示所有单元已有金属供电。

**关键参数：** 上下M5、左右M4；核心宽10/间距2/偏移5，宏环宽4/间距2/偏移10，单位μm。selected限定宏环只围绕目标SRAM。

**本轮实际执行片段：** 下列是运行时保存的Tcl正文；宏路径已解析，其他变量结合配置与日志阅读。

`001_15_tcl.tcl`

```tcl
# Actual sourced body; main SRAM resolved to i_mainmem/i_sram/i_macro
setDesignMode -bottomRoutingLayer METAL2 -topRoutingLayer METAL6
getDesignMode -bottomRoutingLayer
getDesignMode -topRoutingLayer
deselectAll
setAddRingMode -reset
setAddRingMode -avoid_short true -stacked_via_bottom_layer METAL1 -stacked_via_top_layer METAL5
addRing -nets {VDD VSS} -type core_rings -follow core -layer {top METAL5 bottom METAL5 left METAL4 right METAL4} -width 10 -spacing 2 -offset 5 -center 0
selectInst i_mainmem/i_sram/i_macro
addRing -nets {VDD VSS} -type block_rings -around selected -layer {top METAL5 bottom METAL5 left METAL4 right METAL4} -width 4 -spacing 2 -offset 10 -center 0
deselectAll
verify_drc -check_only special -report ../my_soc_top/my_soc_top_pg_drc.rpt
```

`002_15_save_tcl.tcl`

```tcl
# Actual sourced body; main SRAM resolved to i_mainmem/i_sram/i_macro
saveDesign ../my_soc_top/backup/my_soc_top_postRings_M4M5.enc
```

**本轮结果：** 步骤命令与对应自动检查已通过；详见`step_15.json`，独立验收范围以该JSON为准。

```json
{
  "step": 15,
  "commands_completed": true,
  "input_manifest_sha256": "c1b350a1f2550de2e21af03963a3450d3a6ad885f83b8e2bc00b99558cf63f6d",
  "automatic_checks": {
    "actual_rc_temperatures_C": {
      "tt_1p80v_25c": 25,
      "ss_pvt": 125,
      "ff0_pvt": 0,
      "ffm40_pvt": -40
    },
    "special_drc": {
      "report": "/home/s2400011041/Desktop/fullstack_chipdesign/uploads/20261027_200222_4427c4b/work/pnr/my_soc_top/my_soc_top_pg_drc.rpt",
      "zero_reported_violations": true,
      "scope": "drc",
      "archived_report": "evidence/stage_reports/15/pnr/my_soc_top/my_soc_top_pg_drc.rpt",
      "report_sha256": "c1ee9a27a5ca19ef760049c8f38845e2a1d334d871daa67eb1cd985fcc19c84c"
    }
  },
  "scope": "Only the listed automatic checks are asserted. Tcl guards also check object counts, IO geometry and halo. Not complete signoff."
}
```

## 16 铺设基础供电条带

**做什么：** 生成M4纵向与M5横向VDD/VSS条带。

**为什么：** 只在边缘做环无法把电流送到内部，条带向核心深处分配供电。

**预期效果：** 建立基础网格，线宽/间距/节距采用明确的教学工艺配置。

**关键参数：** M4宽2、双网间距1、同组重复间距20；M5宽4、双网间距2、重复间距30。break_at限制在block/outer ring处断开，不直接穿越被阻挡的低层宏几何。

**本轮实际执行片段：** 下列是运行时保存的Tcl正文；宏路径已解析，其他变量结合配置与日志阅读。

`001_16_tcl.tcl`

```tcl
# Actual sourced body; main SRAM resolved to i_mainmem/i_sram/i_macro
setAddStripeMode -reset
setAddStripeMode -break_at {block_ring outer_ring} -allow_jog none -stacked_via_bottom_layer METAL4 -stacked_via_top_layer METAL5 -orthogonal_only false
addStripe -nets {VDD VSS} -layer METAL4 -direction vertical -width 2 -spacing 1 -set_to_set_distance 20 -start_from left -start_offset 8 -block_ring_bottom_layer_limit METAL4 -block_ring_top_layer_limit METAL5 -padcore_ring_bottom_layer_limit METAL4 -padcore_ring_top_layer_limit METAL5
addStripe -nets {VDD VSS} -layer METAL5 -direction horizontal -width 4 -spacing 2 -set_to_set_distance 30 -start_from top -start_offset 1 -block_ring_bottom_layer_limit METAL4 -block_ring_top_layer_limit METAL5 -padcore_ring_bottom_layer_limit METAL4 -padcore_ring_top_layer_limit METAL5
```

**本轮结果：** 步骤命令与对应自动检查已通过；详见`step_16.json`，独立验收范围以该JSON为准。

```json
{
  "step": 16,
  "commands_completed": true,
  "input_manifest_sha256": "c1b350a1f2550de2e21af03963a3450d3a6ad885f83b8e2bc00b99558cf63f6d",
  "automatic_checks": {
    "actual_rc_temperatures_C": {
      "tt_1p80v_25c": 25,
      "ss_pvt": 125,
      "ff0_pvt": 0,
      "ffm40_pvt": -40
    }
  },
  "scope": "Only the listed automatic checks are asserted. Tcl guards also check object counts, IO geometry and halo. Not complete signoff."
}
```

## 17 连接SRAM原生电源引脚

**做什么：** 通过sroute把真实宏电源引脚接到宏环。

**为什么：** 绑定网络名不等于金属已接通；要尊重宏引脚层和内部阻挡。

**预期效果：** 宏PG引脚归属正确并生成接入金属，保留查询记录。

**关键参数：** connect blockPin限定宏针脚；inst只选本轮按宏型号查询出的唯一SRAM实例；M3/M4为针脚范围，M3–M5为引出跨层范围。

**本轮实际执行片段：** 下列是运行时保存的Tcl正文；宏路径已解析，其他变量结合配置与日志阅读。

`001_17_tcl.tcl`

```tcl
# Actual sourced body; main SRAM resolved to i_mainmem/i_sram/i_macro
setSrouteMode -blockPinConnectRingPinCorners true
sroute -nets {VDD VSS} -connect {blockPin} -inst {i_mainmem/i_sram/i_macro} -blockPin useLef -blockPinWidthRange {0.001 1000} -blockPinLayerRange {METAL3 METAL4} -blockPinTarget {blockring} -layerChangeRange {METAL3 METAL5} -allowLayerChange 1 -allowJogging 1 -targetViaLayerRange {METAL3 METAL5} -crossoverViaLayerRange {METAL3 METAL5}
```

`002_17_check_tcl.tcl`

```tcl
# Actual sourced body; main SRAM resolved to i_mainmem/i_sram/i_macro
dbGet [dbGet top.insts.name i_mainmem/i_sram/i_macro -p].pgInstTerms.name
dbGet [dbGet top.insts.name i_mainmem/i_sram/i_macro -p].pgInstTerms.net.name
```

**本轮结果：** 步骤命令与对应自动检查已通过；详见`step_17.json`，独立验收范围以该JSON为准。

```json
{
  "step": 17,
  "commands_completed": true,
  "input_manifest_sha256": "c1b350a1f2550de2e21af03963a3450d3a6ad885f83b8e2bc00b99558cf63f6d",
  "automatic_checks": {
    "actual_rc_temperatures_C": {
      "tt_1p80v_25c": 25,
      "ss_pvt": 125,
      "ff0_pvt": 0,
      "ffm40_pvt": -40
    }
  },
  "scope": "Only the listed automatic checks are asserted. Tcl guards also check object counts, IO geometry and halo. Not complete signoff."
}
```

## 18 使用高层跨越SRAM

**做什么：** 在宏区域上方增加M6供电条带。

**为什么：** 宏占用了部分低层资源，需要合法的高层连接帮助跨越。

**预期效果：** 按当前宏位置生成区域，使用VDD/VSS分别错开的高层供电。

**关键参数：** M6区域根据宏当前位置与固定宏尺寸生成；VDD/VSS错开，不能把高层跨越误当作穿越宏内部低层阻挡。

**本轮实际执行片段：** 下列是运行时保存的Tcl正文；宏路径已解析，其他变量结合配置与日志阅读。

`001_18_tcl.tcl`

```tcl
# Actual sourced body; main SRAM resolved to i_mainmem/i_sram/i_macro
setAddStripeMode -reset
setAddStripeMode -break_at none -allow_jog none -stacked_via_bottom_layer METAL4 -stacked_via_top_layer METAL6 -orthogonal_only false -remove_floating_stripe_over_block false
addStripe -nets {VDD} -layer METAL6 -direction vertical -width 4 -spacing 4 -set_to_set_distance 40 -start_from left -start_offset 14 -area {250.000000 636.000000 804.595000 1387.850000} -block_ring_bottom_layer_limit METAL4 -block_ring_top_layer_limit METAL5 -padcore_ring_bottom_layer_limit METAL4 -padcore_ring_top_layer_limit METAL5
addStripe -nets {VSS} -layer METAL6 -direction vertical -width 4 -spacing 4 -set_to_set_distance 40 -start_from left -start_offset 22 -area {250.000000 630.000000 804.595000 1393.850000} -block_ring_bottom_layer_limit METAL4 -block_ring_top_layer_limit METAL5 -padcore_ring_bottom_layer_limit METAL4 -padcore_ring_top_layer_limit METAL5
```

**本轮结果：** 步骤命令与对应自动检查已通过；详见`step_18.json`，独立验收范围以该JSON为准。

```json
{
  "step": 18,
  "commands_completed": true,
  "input_manifest_sha256": "c1b350a1f2550de2e21af03963a3450d3a6ad885f83b8e2bc00b99558cf63f6d",
  "automatic_checks": {
    "actual_rc_temperatures_C": {
      "tt_1p80v_25c": 25,
      "ss_pvt": 125,
      "ff0_pvt": 0,
      "ffm40_pvt": -40
    }
  },
  "scope": "Only the listed automatic checks are asserted. Tcl guards also check object counts, IO geometry and halo. Not complete signoff."
}
```

## 19 补充宏附近横向供电

**做什么：** 在宏区域生成M5横向条带并检查特殊布线。

**为什么：** 不同层之间需要过孔和合适接入，不能只看二维图有交叉就认为连通。

**预期效果：** 补充网格并导出阶段DEF，特殊布线DRC通过。

**关键参数：** M5区域随宏位置移动；线宽4、间距2、组距30 um为当前教学工艺配置，最终看特殊布线DRC与连通。

**本轮实际执行片段：** 下列是运行时保存的Tcl正文；宏路径已解析，其他变量结合配置与日志阅读。

`001_19_tcl.tcl`

```tcl
# Actual sourced body; main SRAM resolved to i_mainmem/i_sram/i_macro
setAddStripeMode -reset
setAddStripeMode -break_at none -allow_jog none -stacked_via_bottom_layer METAL3 -stacked_via_top_layer METAL6 -orthogonal_only false -split_vias true -remove_floating_stripe_over_block false
addStripe -nets {VDD VSS} -layer METAL5 -direction horizontal -width 4 -spacing 2 -set_to_set_distance 30 -start_from top -start_offset 15.68 -area {230.000000 660.000000 824.595000 1365.000000} -block_ring_bottom_layer_limit METAL4 -block_ring_top_layer_limit METAL5 -padcore_ring_bottom_layer_limit METAL4 -padcore_ring_top_layer_limit METAL5

verify_drc -check_only special -report ../my_soc_top/my_soc_top_pg_drc.rpt
verifyConnectivity -type special -net {VDD VSS} -allPGPinPort -error 100000 -report ../my_soc_top/my_soc_top_pg_connectivity.rpt

defOut -routing ../my_soc_top/my_soc_top_postSramPower.def
```

**本轮结果：** 步骤命令与对应自动检查已通过；详见`step_19.json`，独立验收范围以该JSON为准。

```json
{
  "step": 19,
  "commands_completed": true,
  "input_manifest_sha256": "c1b350a1f2550de2e21af03963a3450d3a6ad885f83b8e2bc00b99558cf63f6d",
  "automatic_checks": {
    "actual_rc_temperatures_C": {
      "tt_1p80v_25c": 25,
      "ss_pvt": 125,
      "ff0_pvt": 0,
      "ffm40_pvt": -40
    },
    "special_drc": {
      "report": "/home/s2400011041/Desktop/fullstack_chipdesign/uploads/20261027_200222_4427c4b/work/pnr/my_soc_top/my_soc_top_pg_drc.rpt",
      "zero_reported_violations": true,
      "scope": "drc",
      "archived_report": "evidence/stage_reports/19/pnr/my_soc_top/my_soc_top_pg_drc.rpt",
      "report_sha256": "da1bf5f6c32092232f3fa3494514716b2bc3c595e4336bb45216409a741aec08"
    }
  },
  "scope": "Only the listed automatic checks are asserted. Tcl guards also check object counts, IO geometry and halo. Not complete signoff."
}
```

## 20 连接核心供电PAD与环

**做什么：** 从16个核心供电PAD引脚接到核心电源环。

**为什么：** 外部供电必须经过实际PAD金属进入环，不能只在网表中同名。

**预期效果：** 形成外围到核心环的金属连接，保留阶段连通/DRC报告。

**关键参数：** PAD接入区域使用实际宽/高减边缘余量，padPinSplit、M2到M5过孔范围遵循当前库，不把旧1720坐标写死。

**本轮实际执行片段：** 下列是运行时保存的Tcl正文；宏路径已解析，其他变量结合配置与日志阅读。

`001_20_tcl.tcl`

```tcl
# Actual sourced body; main SRAM resolved to i_mainmem/i_sram/i_macro
setSrouteMode -reset
setSrouteMode -padPinSplit {10 0.6}
sroute -nets {VDD VSS} -connect {padPin} -area {80 80 1867.840000 1867.840000} -connectInsideArea -padPinTarget {ring} -padPinPortConnect {allPort allGeom} -padPinLayerRange {METAL2 METAL2} -layerChangeRange {METAL2 METAL5} -allowLayerChange 1 -allowJogging 1 -targetViaLayerRange {METAL2 METAL5} -crossoverViaLayerRange {METAL2 METAL5} -detailed_log

verify_drc -check_only special -report ../my_soc_top/my_soc_top_postCorePadConnect_drc.rpt
verifyConnectivity -type special -net {VDD VSS} -allPGPinPort -error 100000 -report ../my_soc_top/my_soc_top_postCorePadConnect_pg.rpt
saveDesign ../my_soc_top/backup/my_soc_top_postCorePadConnect.enc
```

**本轮结果：** 步骤命令与对应自动检查已通过；详见`step_20.json`，独立验收范围以该JSON为准。

```json
{
  "step": 20,
  "commands_completed": true,
  "input_manifest_sha256": "c1b350a1f2550de2e21af03963a3450d3a6ad885f83b8e2bc00b99558cf63f6d",
  "automatic_checks": {
    "actual_rc_temperatures_C": {
      "tt_1p80v_25c": 25,
      "ss_pvt": 125,
      "ff0_pvt": 0,
      "ffm40_pvt": -40
    }
  },
  "scope": "Only the listed automatic checks are asserted. Tcl guards also check object counts, IO geometry and halo. Not complete signoff."
}
```

## 21 建立标准单元行电源轨

**做什么：** 用M1沿单元行布置VDD/VSS轨并接到网格。

**为什么：** 每行标准单元都需要就近电源，只有高层环和条带仍不能直接供电。

**预期效果：** 保留完整PG及排除悬线检查的阶段报告；最终步骤33仍要求完整PG清零。

**关键参数：** 行轨在M1，向M4连接；这里连通检查的noAntenna排除悬线检查，与步骤31的工艺天线检查不是同一件事。完整PG报告保留且最终重新验收。 保留暂时无负载的电源线端，直到第33步物理单元和Filler全部接入后才修剪。

**本轮实际执行片段：** 下列是运行时保存的Tcl正文；宏路径已解析，其他变量结合配置与日志阅读。

`001_21_tcl.tcl`

```tcl
# Actual sourced body; main SRAM resolved to i_mainmem/i_sram/i_macro
saveDesign ../my_soc_top/backup/my_soc_top_preM1_M4M5.enc
sroute -nets {VDD VSS} -connect {corePin} -corePinLayer {METAL1} -corePinTarget {firstAfterRowEnd} -layerChangeRange {METAL1 METAL4} -allowLayerChange 1 -allowJogging 0 -targetViaLayerRange {METAL1 METAL4} -crossoverViaLayerRange {METAL1 METAL4}
# Retain rail ends until physical cells, route repair and final fillers exist.
# Step33 performs native PG trimming against the completed set of load pins.
verify_drc -check_only special -report ../my_soc_top/my_soc_top_pg_drc.rpt
verifyConnectivity -type special -net {VDD VSS} -allPGPinPort -error 100000 -report ../my_soc_top/my_soc_top_pg_connectivity.rpt

saveDesign ../my_soc_top/backup/my_soc_top_postM1.enc
```

`002_21_check_tcl.tcl`

```tcl
# Actual sourced body; main SRAM resolved to i_mainmem/i_sram/i_macro
verifyConnectivity -type special -net {VDD VSS} -allPGPinPort -noAntenna -error 100000 -report ../my_soc_top/my_soc_top_pg_noDangling.rpt
defOut -routing ../my_soc_top/my_soc_top_postM1.def

eda_picture 21_powerplan.gif
```

**本轮结果：** 步骤命令与对应自动检查已通过；详见`step_21.json`，独立验收范围以该JSON为准。

```json
{
  "step": 21,
  "commands_completed": true,
  "input_manifest_sha256": "c1b350a1f2550de2e21af03963a3450d3a6ad885f83b8e2bc00b99558cf63f6d",
  "automatic_checks": {
    "actual_rc_temperatures_C": {
      "tt_1p80v_25c": 25,
      "ss_pvt": 125,
      "ff0_pvt": 0,
      "ffm40_pvt": -40
    },
    "special_drc": {
      "report": "/home/s2400011041/Desktop/fullstack_chipdesign/uploads/20261027_200222_4427c4b/work/pnr/my_soc_top/my_soc_top_pg_drc.rpt",
      "zero_reported_violations": true,
      "scope": "drc",
      "archived_report": "evidence/stage_reports/21/pnr/my_soc_top/my_soc_top_pg_drc.rpt",
      "report_sha256": "07bb2024d7dbab6e4d56455efc795adfaeaff914d1986d5b9e87e4ce73bb5236"
    },
    "core_pg_without_dangling_check": {
      "report": "/home/s2400011041/Desktop/fullstack_chipdesign/uploads/20261027_200222_4427c4b/work/pnr/my_soc_top/my_soc_top_pg_noDangling.rpt",
      "zero_reported_violations": true,
      "scope": "connectivity",
      "archived_report": "evidence/stage_reports/21/pnr/my_soc_top/my_soc_top_pg_noDangling.rpt",
      "report_sha256": "ba42625d424964cd9f2fcb88740f15a839ec803d2eeb0db1b600d253d9e64d41"
    },
    "scope_note": "Full connectivity report retained; noAntenna scope excludes dangling checks here. Final step33 requires the full PG report clean."
  },
  "scope": "Only the listed automatic checks are asserted. Tcl guards also check object counts, IO geometry and halo. Not complete signoff."
}
```

## 22 核对IO原生供电轨

**做什么：** 检查IO侧连通报告，并读取真实库GDS核对长轨截面和角部转接。

**为什么：** 本库LEF没有完整呈现部分原生轨，需要用真实几何与步骤12连续位置共同判断。

**预期效果：** 仅对经验证的VDDPST/VSSPST两项抽象限制分类记录，不放过其他开短路。

**关键参数：** 先核对步骤12四边连续/朝向；解析原生IO GDS的M4长轨和Corner转角。该检查只覆盖所述轨几何，不代替全芯片独立LVS。

**本轮实际执行片段：** 下列是运行时保存的Tcl正文；宏路径已解析，其他变量结合配置与日志阅读。

`001_22_tcl.tcl`

```tcl
# Actual sourced body; main SRAM resolved to i_mainmem/i_sram/i_macro
saveDesign ../my_soc_top/backup/my_soc_top_postPowerPlan.enc
verifyConnectivity -type special -net {VDDPST VSSPST} -allPGPinPort -error 100000 -report ../my_soc_top/my_soc_top_io_pg_connectivity.rpt
```

**本轮结果：** 步骤命令与对应自动检查已通过；详见`step_22.json`，独立验收范围以该JSON为准。

```json
{
  "step": 22,
  "commands_completed": true,
  "input_manifest_sha256": "c1b350a1f2550de2e21af03963a3450d3a6ad885f83b8e2bc00b99558cf63f6d",
  "automatic_checks": {
    "actual_rc_temperatures_C": {
      "tt_1p80v_25c": 25,
      "ss_pvt": 125,
      "ff0_pvt": 0,
      "ffm40_pvt": -40
    },
    "io_native_geometry": {
      "native_rails_and_corner_turns_checked": true,
      "actual_perimeter_continuity_checked_at_step": 12,
      "io_abstract_no_routing_nets": [
        "VDDPST",
        "VSSPST"
      ],
      "scope": "Native rail geometry + actual placement; not merged-chip LVS/IR/EM/ESD"
    }
  },
  "scope": "Only the listed automatic checks are asserted. Tcl guards also check object counts, IO geometry and halo. Not complete signoff."
}
```

## 23 插入Tap和去耦电容

**做什么：** 按库规则插阱连接单元及Decap，绑定PG并复查。

**为什么：** 器件的硅体区域需要参考电压；去耦电容帮助缓和短时供电波动。

**预期效果：** Tap覆盖规则和特殊布线DRC通过；这不代替供电压降分析。

**关键参数：** Tap cellInterval60、checkerBoard；verifyWellTap rule30对应该教学目标，不是独立核实的foundry签核规则。site吸附后间距59.920；Decap skipRow1隔行插入。

**本轮实际执行片段：** 下列是运行时保存的Tcl正文；宏路径已解析，其他变量结合配置与日志阅读。

`001_23_tap_tcl.tcl`

```tcl
# Actual sourced body; main SRAM resolved to i_mainmem/i_sram/i_macro
addWellTap -cell TAPCELLBWP7T -cellInterval 60 -checkerBoard -prefix WELLTAP
verifyWellTap -cell TAPCELLBWP7T -rule 30 -report ../my_soc_top/my_soc_top_welltap.rpt
```

`002_23_decap_tcl.tcl`

```tcl
# Actual sourced body; main SRAM resolved to i_mainmem/i_sram/i_macro
addWellTap -cell DCAP4BWP7T -cellInterval 60 -skipRow 1 -prefix DECAP
globalNetConnect VDD -type pgpin -pin VDD -all
globalNetConnect VSS -type pgpin -pin VSS -all
verify_drc -check_only special -report ../my_soc_top/my_soc_top_postPhysCells_pg_drc.rpt
verifyConnectivity -type special -net {VDD VSS} -allPGPinPort -error 100000 -report ../my_soc_top/my_soc_top_postPhysCells_pg_connectivity.rpt

saveDesign ../my_soc_top/backup/my_soc_top_postPhysCells.enc
```

**本轮结果：** 步骤命令与对应自动检查已通过；详见`step_23.json`，独立验收范围以该JSON为准。

```json
{
  "step": 23,
  "commands_completed": true,
  "input_manifest_sha256": "c1b350a1f2550de2e21af03963a3450d3a6ad885f83b8e2bc00b99558cf63f6d",
  "automatic_checks": {
    "actual_rc_temperatures_C": {
      "tt_1p80v_25c": 25,
      "ss_pvt": 125,
      "ff0_pvt": 0,
      "ffm40_pvt": -40
    },
    "tap": {
      "report": "/home/s2400011041/Desktop/fullstack_chipdesign/uploads/20261027_200222_4427c4b/work/pnr/my_soc_top/my_soc_top_welltap.rpt",
      "zero_reported_violations": true,
      "scope": "tap",
      "archived_report": "evidence/stage_reports/23/pnr/my_soc_top/my_soc_top_welltap.rpt",
      "report_sha256": "ed8c36df4596cf994a7be25ae0e27dca931d2ea971994f8f1aad80c38771d09c"
    },
    "special_drc": {
      "report": "/home/s2400011041/Desktop/fullstack_chipdesign/uploads/20261027_200222_4427c4b/work/pnr/my_soc_top/my_soc_top_postPhysCells_pg_drc.rpt",
      "zero_reported_violations": true,
      "scope": "drc",
      "archived_report": "evidence/stage_reports/23/pnr/my_soc_top/my_soc_top_postPhysCells_pg_drc.rpt",
      "report_sha256": "79f01056c04dcd0d48649f4c6ff82b9183cd1297cb283672187af538345944aa"
    }
  },
  "scope": "Only the listed automatic checks are asserted. Tcl guards also check object counts, IO geometry and halo. Not complete signoff."
}
```

## 24 放置标准单元

**做什么：** 运行place_opt_design，按连接与时序安排大量普通逻辑。

**为什么：** 既要放得下，又要给布线留空间并减少长距离连接。

**预期效果：** 没有未放置或非法普通单元；仅保留明确的34组IO/Bond覆盖。

**关键参数：** preroute_as_obs={}避免将高层PG投影成整条禁放带；显式ignore_scan=true/reorder_scan=false。ignoreOutOfCore限定此标准单元检查范围，不豁免核心违规。

**本轮实际执行片段：** 下列是运行时保存的Tcl正文；宏路径已解析，其他变量结合配置与日志阅读。

`001_24_tcl.tcl`

```tcl
# Actual sourced body; main SRAM resolved to i_mainmem/i_sram/i_macro
setPlaceMode -place_detail_preroute_as_obs {} -place_detail_use_check_drc true
setPlaceMode -place_global_ignore_scan true -place_global_reorder_scan false
place_opt_design
checkPlace ../my_soc_top/my_soc_top_place_check.rpt -ignoreOutOfCore

saveDesign ../my_soc_top/backup/my_soc_top_postPlace.enc
```

**本轮结果：** 步骤命令与对应自动检查已通过；详见`step_24.json`，独立验收范围以该JSON为准。

```json
{
  "step": 24,
  "commands_completed": true,
  "input_manifest_sha256": "c1b350a1f2550de2e21af03963a3450d3a6ad885f83b8e2bc00b99558cf63f6d",
  "automatic_checks": {
    "actual_rc_temperatures_C": {
      "tt_1p80v_25c": 25,
      "ss_pvt": 125,
      "ff0_pvt": 0,
      "ffm40_pvt": -40
    },
    "placement": {
      "report": "/home/s2400011041/Desktop/fullstack_chipdesign/uploads/20261027_200222_4427c4b/work/pnr/my_soc_top/my_soc_top_place_check.rpt",
      "unplaced": 0,
      "expected_io_bond_covers": [
        "i_pad_E_poc",
        "i_pad_E_vdd_1",
        "i_pad_E_vdd_2",
        "i_pad_E_vddio",
        "i_pad_E_vss_1",
        "i_pad_E_vss_2",
        "i_pad_E_vssio",
        "i_pad_N_poc",
        "i_pad_N_vdd_1",
        "i_pad_N_vdd_2",
        "i_pad_N_vddio",
        "i_pad_N_vss_1",
        "i_pad_N_vss_2",
        "i_pad_N_vssio",
        "i_pad_S_poc",
        "i_pad_S_vdd_1",
        "i_pad_S_vdd_2",
        "i_pad_S_vddio",
        "i_pad_S_vss_1",
        "i_pad_S_vss_2",
        "i_pad_S_vssio",
        "i_pad_W_poc",
        "i_pad_W_vdd_1",
        "i_pad_W_vdd_2",
        "i_pad_W_vddio",
        "i_pad_W_vss_1",
        "i_pad_W_vss_2",
        "i_pad_W_vssio",
        "i_pad_clk",
        "i_pad_rst_n",
        "i_pad_tck",
        "i_pad_tdi",
        "i_pad_tdo",
        "i_pad_tms"
      ],
      "no_other_listed_placement_violations": true,
      "archived_report": "evidence/stage_reports/24/pnr/my_soc_top/my_soc_top_place_check.rpt",
      "report_sha256": "037b5a12e42b1db2137fe8bfc0dce228deb0ad5f110f52d272feb49969e71466"
    }
  },
  "scope": "Only the listed automatic checks are asserted. Tcl guards also check object counts, IO geometry and halo. Not complete signoff."
}
```

## 25 给常量输入插Tie

**做什么：** 先为PAD控制脚插常量单元，再插核心常量并排除12个普通供电端。

**为什么：** 常量驱动给逻辑输入提供0/1，不能误接到IO电源网络。

**预期效果：** 细查六个PAD控制值、四网独立、供电端未被Tie取代。

**关键参数：** 先写12端排除表；keepExisting保持第一轮IO Tie；刷新PG、refinePlace，导出postTie.v。最终是否满足电容仍以RC报告为准。

**本轮实际执行片段：** 下列是运行时保存的Tcl正文；宏路径已解析，其他变量结合配置与日志阅读。

`001_25_tcl.tcl`

```tcl
# Actual sourced body; main SRAM resolved to i_mainmem/i_sram/i_macro
set tie_supply_tmp [open ../my_soc_top/tie_supply_exclude_tmp.txt w]
puts $tie_supply_tmp [join {
i_pad_N_vddio/VDDPST
i_pad_N_poc/VDDPST
i_pad_N_vssio/VSSPST
i_pad_S_vddio/VDDPST
i_pad_S_poc/VDDPST
i_pad_S_vssio/VSSPST
i_pad_W_vddio/VDDPST
i_pad_W_poc/VDDPST
i_pad_W_vssio/VSSPST
i_pad_E_vddio/VDDPST
i_pad_E_poc/VDDPST
i_pad_E_vssio/VSSPST
} "\n"]
close $tie_supply_tmp

setTieHiLoMode -cell {TIEHBWP7T TIELBWP7T} -maxFanout 1 -maxDistance 100
addTieHiLo -cellPin {PDDW0204CDG:I PDDW0204CDG:DS PDDW0204CDG:OEN PDDW0204CDG:PE PDDW0204CDG:IE PDDW1216CDG:DS PDDW1216CDG:OEN PDDW1216CDG:PE PDDW1216CDG:IE}
setTieHiLoMode -cell {TIEHBWP7T TIELBWP7T} -maxFanout 8 -maxDistance 50
addTieHiLo -keepExisting true -excludePin ../my_soc_top/tie_supply_exclude_tmp.txt
file delete ../my_soc_top/tie_supply_exclude_tmp.txt
globalNetConnect VDD -type pgpin -pin VDD -all
globalNetConnect VSS -type pgpin -pin VSS -all
refinePlace
checkPlace ../my_soc_top/my_soc_top_postTie_place.rpt -ignoreOutOfCore

saveNetlist ../my_soc_top/my_soc_top_postTie.v -phys
```

**本轮结果：** 步骤命令与对应自动检查已通过；详见`step_25.json`，独立验收范围以该JSON为准。

```json
{
  "step": 25,
  "commands_completed": true,
  "input_manifest_sha256": "c1b350a1f2550de2e21af03963a3450d3a6ad885f83b8e2bc00b99558cf63f6d",
  "automatic_checks": {
    "actual_rc_temperatures_C": {
      "tt_1p80v_25c": 25,
      "ss_pvt": 125,
      "ff0_pvt": 0,
      "ffm40_pvt": -40
    },
    "placement": {
      "report": "/home/s2400011041/Desktop/fullstack_chipdesign/uploads/20261027_200222_4427c4b/work/pnr/my_soc_top/my_soc_top_postTie_place.rpt",
      "unplaced": 0,
      "expected_io_bond_covers": [
        "i_pad_E_poc",
        "i_pad_E_vdd_1",
        "i_pad_E_vdd_2",
        "i_pad_E_vddio",
        "i_pad_E_vss_1",
        "i_pad_E_vss_2",
        "i_pad_E_vssio",
        "i_pad_N_poc",
        "i_pad_N_vdd_1",
        "i_pad_N_vdd_2",
        "i_pad_N_vddio",
        "i_pad_N_vss_1",
        "i_pad_N_vss_2",
        "i_pad_N_vssio",
        "i_pad_S_poc",
        "i_pad_S_vdd_1",
        "i_pad_S_vdd_2",
        "i_pad_S_vddio",
        "i_pad_S_vss_1",
        "i_pad_S_vss_2",
        "i_pad_S_vssio",
        "i_pad_W_poc",
        "i_pad_W_vdd_1",
        "i_pad_W_vdd_2",
        "i_pad_W_vddio",
        "i_pad_W_vss_1",
        "i_pad_W_vss_2",
        "i_pad_W_vssio",
        "i_pad_clk",
        "i_pad_rst_n",
        "i_pad_tck",
        "i_pad_tdi",
        "i_pad_tdo",
        "i_pad_tms"
      ],
      "no_other_listed_placement_violations": true,
      "archived_report": "evidence/stage_reports/25/pnr/my_soc_top/my_soc_top_postTie_place.rpt",
      "report_sha256": "f30a45cc0652c369d0a82e538978f8a5815959eee042a06aadb6d87e7b57152a"
    },
    "io_controls": {
      "program": "audit_io_ties.py",
      "exit_code": 0
    }
  },
  "scope": "Only the listed automatic checks are asserted. Tcl guards also check object counts, IO geometry and halo. Not complete signoff."
}
```

## 26 检查时钟树之前的时序

**做什么：** 分别计算preCTS Setup和Hold并检查核心PG。

**为什么：** 时钟树尚未真实建立，先定位估计线长和理想时钟假设下的问题。

**预期效果：** 保存两类报告；早期残项被记录，最终是否达标在布线后重新判断。

**关键参数：** expandedViews展开活动视图结果；WNS/TNS、违规数量与Real/Total DRV要分开读。preCTS仍未包含最终时钟树和真实全部信号RC。

**本轮实际执行片段：** 下列是运行时保存的Tcl正文；宏路径已解析，其他变量结合配置与日志阅读。

`001_26_tcl.tcl`

```tcl
# Actual sourced body; main SRAM resolved to i_mainmem/i_sram/i_macro
verifyConnectivity -type special -net {VDD VSS} -allPGPinPort -error 100000 -report ../my_soc_top/my_soc_top_postTie_pg.rpt
timeDesign -preCTS -expandedViews -outDir ../my_soc_top/reports/preCTS

saveDesign ../my_soc_top/backup/my_soc_top_postPlace_tieFixed.enc
```

`002_26_hold.tcl`

```tcl
# Actual sourced body; main SRAM resolved to i_mainmem/i_sram/i_macro
timeDesign -preCTS -hold -expandedViews -outDir ../my_soc_top/reports/preCTS
```

**本轮结果：** 步骤命令与对应自动检查已通过；详见`step_26.json`，独立验收范围以该JSON为准。

```json
{
  "step": 26,
  "commands_completed": true,
  "input_manifest_sha256": "c1b350a1f2550de2e21af03963a3450d3a6ad885f83b8e2bc00b99558cf63f6d",
  "automatic_checks": {
    "actual_rc_temperatures_C": {
      "tt_1p80v_25c": 25,
      "ss_pvt": 125,
      "ff0_pvt": 0,
      "ffm40_pvt": -40
    },
    "timing": {
      "Setup": {
        "report": "/home/s2400011041/Desktop/fullstack_chipdesign/uploads/20261027_200222_4427c4b/work/pnr/my_soc_top/reports/preCTS/my_soc_top_preCTS.summary.gz",
        "wns_ns": 0.002,
        "tns_ns": 0.0,
        "violating_paths": 0,
        "drv": {
          "max_cap": {
            "real": 0,
            "total": 1
          },
          "max_tran": {
            "real": 0,
            "total": 0
          },
          "max_fanout": {
            "real": 0,
            "total": 2
          },
          "max_length": {
            "real": 0,
            "total": 0
          }
        },
        "electrical_drv_table_reported_here": true,
        "minimum_wns_ns": 0.0,
        "targets_met": false,
        "archived_report": "evidence/stage_reports/26/pnr/my_soc_top/reports/preCTS/my_soc_top_preCTS.summary.gz",
        "report_sha256": "971391614736e62c0aa63ca18e5d93e333be9d6df7e7d36394bb884d592ce9cc"
      },
      "Hold": {
        "report": "/home/s2400011041/Desktop/fullstack_chipdesign/uploads/20261027_200222_4427c4b/work/pnr/my_soc_top/reports/preCTS/my_soc_top_preCTS_hold.summary.gz",
        "wns_ns": -0.156,
        "tns_ns": -5.538,
        "violating_paths": 120,
        "drv": {},
        "electrical_drv_table_reported_here": false,
        "minimum_wns_ns": 0.0,
        "targets_met": false,
        "archived_report": "evidence/stage_reports/26/pnr/my_soc_top/reports/preCTS/my_soc_top_preCTS_hold.summary.gz",
        "report_sha256": "1a032943dd73a73ddf57934ac30411a5933491ad6c56e1d5bd1171d423e7f1f0"
      }
    },
    "expanded_analysis_views": {
      "func_tt_io": {
        "Setup": {
          "report": "/home/s2400011041/Desktop/fullstack_chipdesign/uploads/20261027_200222_4427c4b/work/pnr/my_soc_top/reports/preCTS/func_tt_io/my_soc_top_preCTS_all.tarpt.gz",
          "analysis_view": "func_tt_io",
          "archived_report": "evidence/stage_reports/26/pnr/my_soc_top/reports/preCTS/func_tt_io/my_soc_top_preCTS_all.tarpt.gz",
          "report_sha256": "4fcd1d56a3b361e1a0ceb9dc920a35b108a0fb2064c2d705aeb310cb480b4526"
        },
        "Hold": {
          "report": "/home/s2400011041/Desktop/fullstack_chipdesign/uploads/20261027_200222_4427c4b/work/pnr/my_soc_top/reports/preCTS/func_tt_io/my_soc_top_preCTS_all_hold.tarpt.gz",
          "analysis_view": "func_tt_io",
          "archived_report": "evidence/stage_reports/26/pnr/my_soc_top/reports/preCTS/func_tt_io/my_soc_top_preCTS_all_hold.tarpt.gz",
          "report_sha256": "3f7aae52aa7023cb1806cfcc68d7bd96f6ba157277876f2c98e8b92d81f64105"
        }
      },
      "func_ss_io": {
        "Setup": {
          "report": "/home/s2400011041/Desktop/fullstack_chipdesign/uploads/20261027_200222_4427c4b/work/pnr/my_soc_top/reports/preCTS/func_ss_io/my_soc_top_preCTS_all.tarpt.gz",
          "analysis_view": "func_ss_io",
          "archived_report": "evidence/stage_reports/26/pnr/my_soc_top/reports/preCTS/func_ss_io/my_soc_top_preCTS_all.tarpt.gz",
          "report_sha256": "adadef8dc2dcee4f5163b31b806584caa4c5d9ed737492d55a35302a3db10398"
        },
        "Hold": {
          "report": "/home/s2400011041/Desktop/fullstack_chipdesign/uploads/20261027_200222_4427c4b/work/pnr/my_soc_top/reports/preCTS/func_ss_io/my_soc_top_preCTS_all_hold.tarpt.gz",
          "analysis_view": "func_ss_io",
          "archived_report": "evidence/stage_reports/26/pnr/my_soc_top/reports/preCTS/func_ss_io/my_soc_top_preCTS_all_hold.tarpt.gz",
          "report_sha256": "23c392f62520e37ab2a96a8a4c2c888f19cf0b9cda55701f8431a081190a34ca"
        }
      },
      "func_ff0_io": {
        "Setup": {
          "report": "/home/s2400011041/Desktop/fullstack_chipdesign/uploads/20261027_200222_4427c4b/work/pnr/my_soc_top/reports/preCTS/func_ff0_io/my_soc_top_preCTS_all.tarpt.gz",
          "analysis_view": "func_ff0_io",
          "archived_report": "evidence/stage_reports/26/pnr/my_soc_top/reports/preCTS/func_ff0_io/my_soc_top_preCTS_all.tarpt.gz",
          "report_sha256": "b460dc8bcd7251379db1a826b206a947381ab7b545ca5af05945ec620ec921cc"
        },
        "Hold": {
          "report": "/home/s2400011041/Desktop/fullstack_chipdesign/uploads/20261027_200222_4427c4b/work/pnr/my_soc_top/reports/preCTS/func_ff0_io/my_soc_top_preCTS_all_hold.tarpt.gz",
          "analysis_view": "func_ff0_io",
          "archived_report": "evidence/stage_reports/26/pnr/my_soc_top/reports/preCTS/func_ff0_io/my_soc_top_preCTS_all_hold.tarpt.gz",
          "report_sha256": "ef40af1cbc91116b0cfd022a25a98629aebac02e3d6af736173c9272bcf09c80"
        }
      },
      "func_ffm40_io": {
        "Setup": {
          "report": "/home/s2400011041/Desktop/fullstack_chipdesign/uploads/20261027_200222_4427c4b/work/pnr/my_soc_top/reports/preCTS/func_ffm40_io/my_soc_top_preCTS_all.tarpt.gz",
          "analysis_view": "func_ffm40_io",
          "archived_report": "evidence/stage_reports/26/pnr/my_soc_top/reports/preCTS/func_ffm40_io/my_soc_top_preCTS_all.tarpt.gz",
          "report_sha256": "6592970da234069313b170afc85aa9c547d896f8779c681566ea69ce29334017"
        },
        "Hold": {
          "report": "/home/s2400011041/Desktop/fullstack_chipdesign/uploads/20261027_200222_4427c4b/work/pnr/my_soc_top/reports/preCTS/func_ffm40_io/my_soc_top_preCTS_all_hold.tarpt.gz",
          "analysis_view": "func_ffm40_io",
          "archived_report": "evidence/stage_reports/26/pnr/my_soc_top/reports/preCTS/func_ffm40_io/my_soc_top_preCTS_all_hold.tarpt.gz",
          "report_sha256": "b8aec172fed8d29d9e32a5e3f75fa6f88007337ee7a01a4fd722171f14d88ab3"
        }
      }
    },
    "timing_scope": "Pre-route diagnostic: residuals are recorded; only post-route steps32/33 require all timing/electrical targets met."
  },
  "scope": "Only the listed automatic checks are asserted. Tcl guards also check object counts, IO geometry and halo. Not complete signoff."
}
```

## 27 定义时钟树与源模型

**做什么：** 为sys_clk和jtag_clk准备时钟树，设置源转换时间、电容能力和时间预算。

**为什么：** 同一时钟要驱动很多寄存器；外部源也有有限驱动能力。

**预期效果：** 两路真实树有完整规格，虚拟JTAG参考不创建物理树。

**关键参数：** 仅sys_clk/jtag_clk是真实树；0.5 ns输入转换、5 pF源允许负载、0.47/0.2 ns Setup/Hold不确定度沿用已说明的首轮模型，不代表物理添加对应电容或延时。

**本轮实际执行片段：** 下列是运行时保存的Tcl正文；宏路径已解析，其他变量结合配置与日志阅读。

`001_27_tcl.tcl`

```tcl
# Actual sourced body; main SRAM resolved to i_mainmem/i_sram/i_macro
set_ccopt_property primary_delay_corner delay_tt_io
set eda_cts_views {func_tt_io}
if {[info exists eda_enable_pvt] && $eda_enable_pvt} {
    set_ccopt_property primary_delay_corner delay_ss_io
    set eda_cts_views {func_tt_io func_ss_io func_ff0_io func_ffm40_io}
}
set_ccopt_property update_io_latency false
set_ccopt_property force_update_io_latency false
create_ccopt_clock_tree_spec -views $eda_cts_views
set_interactive_constraint_modes [all_constraint_modes -active]
set_clock_uncertainty -setup 0.47 [get_clocks {sys_clk jtag_clk}]
set_clock_uncertainty -hold 0.2 [get_clocks {sys_clk jtag_clk}]
set_input_transition 0.5 [get_ports {clk_i tck_i}]
set_interactive_constraint_modes {}
set_ccopt_property source_output_max_trans 0.5 -clock_tree sys_clk
set_ccopt_property source_output_max_trans 0.5 -clock_tree jtag_clk
set_ccopt_property source_max_capacitance 5.0 -clock_tree sys_clk
set_ccopt_property source_max_capacitance 5.0 -clock_tree jtag_clk
ccopt_design -check_prerequisites
```

`002_27_verify_tcl.tcl`

```tcl
# Actual sourced body; main SRAM resolved to i_mainmem/i_sram/i_macro
all_analysis_views -type setup
all_analysis_views -type hold
report_clocks
```

**本轮结果：** 步骤命令与对应自动检查已通过；详见`step_27.json`，独立验收范围以该JSON为准。

```json
{
  "step": 27,
  "commands_completed": true,
  "input_manifest_sha256": "c1b350a1f2550de2e21af03963a3450d3a6ad885f83b8e2bc00b99558cf63f6d",
  "automatic_checks": {
    "actual_rc_temperatures_C": {
      "tt_1p80v_25c": 25,
      "ss_pvt": 125,
      "ff0_pvt": 0,
      "ffm40_pvt": -40
    }
  },
  "scope": "Only the listed automatic checks are asserted. Tcl guards also check object counts, IO geometry and halo. Not complete signoff."
}
```

## 28 构建并分析真实时钟树

**做什么：** 运行CCOpt，将真实时钟网络延时纳入Setup/Hold分析。

**为什么：** 时钟到各处不再完全同时；偏差可能帮助Setup却恶化Hold。

**预期效果：** 保存树后检查点，放置合法，输出两类时序/电气报告。

**关键参数：** set_propagated_clock只作用于sys_clk/jtag_clk；timing_io_use_clock_network_latency always按讲义使用网络延迟。虚拟参考不传播。

**本轮实际执行片段：** 下列是运行时保存的Tcl正文；宏路径已解析，其他变量结合配置与日志阅读。

`001_28_tcl.tcl`

```tcl
# Actual sourced body; main SRAM resolved to i_mainmem/i_sram/i_macro
saveDesign ../my_soc_top/backup/my_soc_top_preCTS.enc
ccopt_design
saveDesign ../my_soc_top/backup/my_soc_top_postCTS_raw.enc
set_interactive_constraint_modes [all_constraint_modes -active]
set_global timing_io_use_clock_network_latency always
set_propagated_clock [get_clocks {sys_clk jtag_clk}]
set_interactive_constraint_modes {}
globalNetConnect VDD -type pgpin -pin VDD -all
globalNetConnect VSS -type pgpin -pin VSS -all
checkPlace ../my_soc_top/my_soc_top_postCTS_place_check.rpt -ignoreOutOfCore
verifyConnectivity -type special -net {VDD VSS} -allPGPinPort -error 100000 -report ../my_soc_top/my_soc_top_postCTS_pg_connectivity.rpt
timeDesign -postCTS -expandedViews -outDir ../my_soc_top/reports/postCTS
timeDesign -postCTS -hold -expandedViews -outDir ../my_soc_top/reports/postCTS
```

**本轮结果：** 步骤命令与对应自动检查已通过；详见`step_28.json`，独立验收范围以该JSON为准。

```json
{
  "step": 28,
  "commands_completed": true,
  "input_manifest_sha256": "c1b350a1f2550de2e21af03963a3450d3a6ad885f83b8e2bc00b99558cf63f6d",
  "automatic_checks": {
    "actual_rc_temperatures_C": {
      "tt_1p80v_25c": 25,
      "ss_pvt": 125,
      "ff0_pvt": 0,
      "ffm40_pvt": -40
    },
    "placement": {
      "report": "/home/s2400011041/Desktop/fullstack_chipdesign/uploads/20261027_200222_4427c4b/work/pnr/my_soc_top/my_soc_top_postCTS_place_check.rpt",
      "unplaced": 0,
      "expected_io_bond_covers": [
        "i_pad_E_poc",
        "i_pad_E_vdd_1",
        "i_pad_E_vdd_2",
        "i_pad_E_vddio",
        "i_pad_E_vss_1",
        "i_pad_E_vss_2",
        "i_pad_E_vssio",
        "i_pad_N_poc",
        "i_pad_N_vdd_1",
        "i_pad_N_vdd_2",
        "i_pad_N_vddio",
        "i_pad_N_vss_1",
        "i_pad_N_vss_2",
        "i_pad_N_vssio",
        "i_pad_S_poc",
        "i_pad_S_vdd_1",
        "i_pad_S_vdd_2",
        "i_pad_S_vddio",
        "i_pad_S_vss_1",
        "i_pad_S_vss_2",
        "i_pad_S_vssio",
        "i_pad_W_poc",
        "i_pad_W_vdd_1",
        "i_pad_W_vdd_2",
        "i_pad_W_vddio",
        "i_pad_W_vss_1",
        "i_pad_W_vss_2",
        "i_pad_W_vssio",
        "i_pad_clk",
        "i_pad_rst_n",
        "i_pad_tck",
        "i_pad_tdi",
        "i_pad_tdo",
        "i_pad_tms"
      ],
      "no_other_listed_placement_violations": true,
      "archived_report": "evidence/stage_reports/28/pnr/my_soc_top/my_soc_top_postCTS_place_check.rpt",
      "report_sha256": "9f849f316553ee3ab898e13bf1198cb2d4e69dd32207afb0597894f3a288c7f4"
    },
    "timing": {
      "Setup": {
        "report": "/home/s2400011041/Desktop/fullstack_chipdesign/uploads/20261027_200222_4427c4b/work/pnr/my_soc_top/reports/postCTS/my_soc_top_postCTS.summary.gz",
        "wns_ns": 0.004,
        "tns_ns": 0.0,
        "violating_paths": 0,
        "drv": {
          "max_cap": {
            "real": 0,
            "total": 0
          },
          "max_tran": {
            "real": 0,
            "total": 0
          },
          "max_fanout": {
            "real": 0,
            "total": 0
          },
          "max_length": {
            "real": 0,
            "total": 0
          }
        },
        "electrical_drv_table_reported_here": true,
        "minimum_wns_ns": 0.0,
        "targets_met": true,
        "archived_report": "evidence/stage_reports/28/pnr/my_soc_top/reports/postCTS/my_soc_top_postCTS.summary.gz",
        "report_sha256": "61007ed0337714a999c42965343e05a84ba9ba36a408ab20efd4cfc6ce1cfde3"
      },
      "Hold": {
        "report": "/home/s2400011041/Desktop/fullstack_chipdesign/uploads/20261027_200222_4427c4b/work/pnr/my_soc_top/reports/postCTS/my_soc_top_postCTS_hold.summary.gz",
        "wns_ns": -1.143,
        "tns_ns": -14.484,
        "violating_paths": 103,
        "drv": {},
        "electrical_drv_table_reported_here": false,
        "minimum_wns_ns": 0.0,
        "targets_met": false,
        "archived_report": "evidence/stage_reports/28/pnr/my_soc_top/reports/postCTS/my_soc_top_postCTS_hold.summary.gz",
        "report_sha256": "49113c925fba5f030c49aa972ed09538703c88ba6ae4bfea9e0e3c45fe59ee35"
      }
    },
    "expanded_analysis_views": {
      "func_tt_io": {
        "Setup": {
          "report": "/home/s2400011041/Desktop/fullstack_chipdesign/uploads/20261027_200222_4427c4b/work/pnr/my_soc_top/reports/postCTS/func_tt_io/my_soc_top_postCTS_all.tarpt.gz",
          "analysis_view": "func_tt_io",
          "archived_report": "evidence/stage_reports/28/pnr/my_soc_top/reports/postCTS/func_tt_io/my_soc_top_postCTS_all.tarpt.gz",
          "report_sha256": "4d777b3b9d203e5c40788d6f5012db21f95c1e35bc075aaa84af95aefe312944"
        },
        "Hold": {
          "report": "/home/s2400011041/Desktop/fullstack_chipdesign/uploads/20261027_200222_4427c4b/work/pnr/my_soc_top/reports/postCTS/func_tt_io/my_soc_top_postCTS_all_hold.tarpt.gz",
          "analysis_view": "func_tt_io",
          "archived_report": "evidence/stage_reports/28/pnr/my_soc_top/reports/postCTS/func_tt_io/my_soc_top_postCTS_all_hold.tarpt.gz",
          "report_sha256": "96c0a1dd98cb8b1e08ed1b3514e07073ac32d4f830027b52a5af8cf66b8dac77"
        }
      },
      "func_ss_io": {
        "Setup": {
          "report": "/home/s2400011041/Desktop/fullstack_chipdesign/uploads/20261027_200222_4427c4b/work/pnr/my_soc_top/reports/postCTS/func_ss_io/my_soc_top_postCTS_all.tarpt.gz",
          "analysis_view": "func_ss_io",
          "archived_report": "evidence/stage_reports/28/pnr/my_soc_top/reports/postCTS/func_ss_io/my_soc_top_postCTS_all.tarpt.gz",
          "report_sha256": "1d60bba4a5fec376b2c61cb3b69e13c1892cab3845fc0a77f61cc672228683c3"
        },
        "Hold": {
          "report": "/home/s2400011041/Desktop/fullstack_chipdesign/uploads/20261027_200222_4427c4b/work/pnr/my_soc_top/reports/postCTS/func_ss_io/my_soc_top_postCTS_all_hold.tarpt.gz",
          "analysis_view": "func_ss_io",
          "archived_report": "evidence/stage_reports/28/pnr/my_soc_top/reports/postCTS/func_ss_io/my_soc_top_postCTS_all_hold.tarpt.gz",
          "report_sha256": "fa1a48ee64b0fab5fdc89f35eb0b42aae485b1635ffea83f68dc4e1ea443ec95"
        }
      },
      "func_ff0_io": {
        "Setup": {
          "report": "/home/s2400011041/Desktop/fullstack_chipdesign/uploads/20261027_200222_4427c4b/work/pnr/my_soc_top/reports/postCTS/func_ff0_io/my_soc_top_postCTS_all.tarpt.gz",
          "analysis_view": "func_ff0_io",
          "archived_report": "evidence/stage_reports/28/pnr/my_soc_top/reports/postCTS/func_ff0_io/my_soc_top_postCTS_all.tarpt.gz",
          "report_sha256": "678a4d10652b016b9ebada137be9321ed1b0004c1f1d39546858a652d2ac5df8"
        },
        "Hold": {
          "report": "/home/s2400011041/Desktop/fullstack_chipdesign/uploads/20261027_200222_4427c4b/work/pnr/my_soc_top/reports/postCTS/func_ff0_io/my_soc_top_postCTS_all_hold.tarpt.gz",
          "analysis_view": "func_ff0_io",
          "archived_report": "evidence/stage_reports/28/pnr/my_soc_top/reports/postCTS/func_ff0_io/my_soc_top_postCTS_all_hold.tarpt.gz",
          "report_sha256": "acfeb8a0505b21866037996d7e4e9b48eaac772ef43b7b8dcc0934351432126c"
        }
      },
      "func_ffm40_io": {
        "Setup": {
          "report": "/home/s2400011041/Desktop/fullstack_chipdesign/uploads/20261027_200222_4427c4b/work/pnr/my_soc_top/reports/postCTS/func_ffm40_io/my_soc_top_postCTS_all.tarpt.gz",
          "analysis_view": "func_ffm40_io",
          "archived_report": "evidence/stage_reports/28/pnr/my_soc_top/reports/postCTS/func_ffm40_io/my_soc_top_postCTS_all.tarpt.gz",
          "report_sha256": "94ca3f80d7dba6199f7b2cb2d69b695204a83f32c00bb0c6f80a45123803ce06"
        },
        "Hold": {
          "report": "/home/s2400011041/Desktop/fullstack_chipdesign/uploads/20261027_200222_4427c4b/work/pnr/my_soc_top/reports/postCTS/func_ffm40_io/my_soc_top_postCTS_all_hold.tarpt.gz",
          "analysis_view": "func_ffm40_io",
          "archived_report": "evidence/stage_reports/28/pnr/my_soc_top/reports/postCTS/func_ffm40_io/my_soc_top_postCTS_all_hold.tarpt.gz",
          "report_sha256": "7b8196f4f2a64066ffddc095057fccc36cf22d69c34968070030baa91eca0fda"
        }
      }
    },
    "timing_scope": "Pre-route diagnostic: residuals are recorded; only post-route steps32/33 require all timing/electrical targets met."
  },
  "scope": "Only the listed automatic checks are asserted. Tcl guards also check object counts, IO geometry and halo. Not complete signoff."
}
```

## 29 按当前报告处理树后Hold

**做什么：** 只有当前报告需要时才做Hold优化，然后独立重查。

**为什么：** 新数据来得太早会破坏采样，可以加适当延时，同时保护Setup。

**预期效果：** 保存实际修复后结果；pre-route估计残项不会被写成最终通过。

**关键参数：** 仅当前Hold违规数非零时按0目标进行原生修复，保护Setup；原生postCTS优化处理实际Setup/DRV。预布线残项记录，最终仍以postRoute报告为准。

**本轮实际执行片段：** 下列是运行时保存的Tcl正文；宏路径已解析，其他变量结合配置与日志阅读。

`001_29_hold_mode.tcl`

```tcl
# Actual sourced body; main SRAM resolved to i_mainmem/i_sram/i_macro
setOptMode -fixHoldAllowSetupTnsDegrade false -holdTargetSlack 0
```

`002_29_fix_tcl.tcl`

```tcl
# Actual sourced body; main SRAM resolved to i_mainmem/i_sram/i_macro
saveDesign ../my_soc_top/backup/my_soc_top_preHoldFix.enc
setOptMode -fixHoldAllowSetupTnsDegrade false
optDesign -postCTS -hold -expandedViews -outDir ../my_soc_top/reports/postCTS_holdFix
```

`003_29_check_tcl.tcl`

```tcl
# Actual sourced body; main SRAM resolved to i_mainmem/i_sram/i_macro
timeDesign -postCTS -expandedViews -outDir ../my_soc_top/reports/postCTS_holdFix_check
timeDesign -postCTS -hold -expandedViews -outDir ../my_soc_top/reports/postCTS_holdFix_check
globalNetConnect VDD -type pgpin -pin VDD -all
globalNetConnect VSS -type pgpin -pin VSS -all
checkPlace ../my_soc_top/my_soc_top_postHoldFix_place.rpt -ignoreOutOfCore
verifyConnectivity -type special -net {VDD VSS} -allPGPinPort -error 100000 -report ../my_soc_top/my_soc_top_postHoldFix_pg.rpt
saveDesign ../my_soc_top/backup/my_soc_top_postCTS_holdResidual.enc
```

**本轮结果：** 步骤命令与对应自动检查已通过；详见`step_29.json`，独立验收范围以该JSON为准。

```json
{
  "step": 29,
  "commands_completed": true,
  "input_manifest_sha256": "c1b350a1f2550de2e21af03963a3450d3a6ad885f83b8e2bc00b99558cf63f6d",
  "automatic_checks": {
    "actual_rc_temperatures_C": {
      "tt_1p80v_25c": 25,
      "ss_pvt": 125,
      "ff0_pvt": 0,
      "ffm40_pvt": -40
    },
    "placement": {
      "report": "/home/s2400011041/Desktop/fullstack_chipdesign/uploads/20261027_200222_4427c4b/work/pnr/my_soc_top/my_soc_top_postHoldFix_place.rpt",
      "unplaced": 0,
      "expected_io_bond_covers": [
        "i_pad_E_poc",
        "i_pad_E_vdd_1",
        "i_pad_E_vdd_2",
        "i_pad_E_vddio",
        "i_pad_E_vss_1",
        "i_pad_E_vss_2",
        "i_pad_E_vssio",
        "i_pad_N_poc",
        "i_pad_N_vdd_1",
        "i_pad_N_vdd_2",
        "i_pad_N_vddio",
        "i_pad_N_vss_1",
        "i_pad_N_vss_2",
        "i_pad_N_vssio",
        "i_pad_S_poc",
        "i_pad_S_vdd_1",
        "i_pad_S_vdd_2",
        "i_pad_S_vddio",
        "i_pad_S_vss_1",
        "i_pad_S_vss_2",
        "i_pad_S_vssio",
        "i_pad_W_poc",
        "i_pad_W_vdd_1",
        "i_pad_W_vdd_2",
        "i_pad_W_vddio",
        "i_pad_W_vss_1",
        "i_pad_W_vss_2",
        "i_pad_W_vssio",
        "i_pad_clk",
        "i_pad_rst_n",
        "i_pad_tck",
        "i_pad_tdi",
        "i_pad_tdo",
        "i_pad_tms"
      ],
      "no_other_listed_placement_violations": true,
      "archived_report": "evidence/stage_reports/29/pnr/my_soc_top/my_soc_top_postHoldFix_place.rpt",
      "report_sha256": "91296a4864a8a0c745455f3261e85bdc11851a74c1c4381f63b186470ef1bb98"
    },
    "timing": {
      "Setup": {
        "report": "/home/s2400011041/Desktop/fullstack_chipdesign/uploads/20261027_200222_4427c4b/work/pnr/my_soc_top/reports/postCTS_holdFix_check/my_soc_top_postCTS.summary.gz",
        "wns_ns": 0.004,
        "tns_ns": 0.0,
        "violating_paths": 0,
        "drv": {
          "max_cap": {
            "real": 0,
            "total": 0
          },
          "max_tran": {
            "real": 0,
            "total": 0
          },
          "max_fanout": {
            "real": 0,
            "total": 0
          },
          "max_length": {
            "real": 0,
            "total": 0
          }
        },
        "electrical_drv_table_reported_here": true,
        "minimum_wns_ns": 0.0,
        "targets_met": true,
        "archived_report": "evidence/stage_reports/29/pnr/my_soc_top/reports/postCTS_holdFix_check/my_soc_top_postCTS.summary.gz",
        "report_sha256": "b6482d9fc47e475255513804f56816634a89cd0a8e5c03c944f3e53cda932dff"
      },
      "Hold": {
        "report": "/home/s2400011041/Desktop/fullstack_chipdesign/uploads/20261027_200222_4427c4b/work/pnr/my_soc_top/reports/postCTS_holdFix_check/my_soc_top_postCTS_hold.summary.gz",
        "wns_ns": 0.002,
        "tns_ns": 0.0,
        "violating_paths": 0,
        "drv": {},
        "electrical_drv_table_reported_here": false,
        "minimum_wns_ns": 0.0,
        "targets_met": true,
        "archived_report": "evidence/stage_reports/29/pnr/my_soc_top/reports/postCTS_holdFix_check/my_soc_top_postCTS_hold.summary.gz",
        "report_sha256": "587e64deec838a78aa9976e2cc6ad7afd9af96d5486734b19bff0b6858066bd9"
      }
    },
    "expanded_analysis_views": {
      "func_tt_io": {
        "Setup": {
          "report": "/home/s2400011041/Desktop/fullstack_chipdesign/uploads/20261027_200222_4427c4b/work/pnr/my_soc_top/reports/postCTS_holdFix_check/func_tt_io/my_soc_top_postCTS_all.tarpt.gz",
          "analysis_view": "func_tt_io",
          "archived_report": "evidence/stage_reports/29/pnr/my_soc_top/reports/postCTS_holdFix_check/func_tt_io/my_soc_top_postCTS_all.tarpt.gz",
          "report_sha256": "adf7b65ec960fbc16e651151ad00b406e7c2eca52ae2362453ff80addba65da1"
        },
        "Hold": {
          "report": "/home/s2400011041/Desktop/fullstack_chipdesign/uploads/20261027_200222_4427c4b/work/pnr/my_soc_top/reports/postCTS_holdFix_check/func_tt_io/my_soc_top_postCTS_all_hold.tarpt.gz",
          "analysis_view": "func_tt_io",
          "archived_report": "evidence/stage_reports/29/pnr/my_soc_top/reports/postCTS_holdFix_check/func_tt_io/my_soc_top_postCTS_all_hold.tarpt.gz",
          "report_sha256": "e01dd9afbf914b747519c6b1585601cedc9631346387d7f9346f80d8ac24af37"
        }
      },
      "func_ss_io": {
        "Setup": {
          "report": "/home/s2400011041/Desktop/fullstack_chipdesign/uploads/20261027_200222_4427c4b/work/pnr/my_soc_top/reports/postCTS_holdFix_check/func_ss_io/my_soc_top_postCTS_all.tarpt.gz",
          "analysis_view": "func_ss_io",
          "archived_report": "evidence/stage_reports/29/pnr/my_soc_top/reports/postCTS_holdFix_check/func_ss_io/my_soc_top_postCTS_all.tarpt.gz",
          "report_sha256": "c5252a1a744f1e40aa25865dd56ef2a1b6847f5c4e7418492b7c91215e0f37da"
        },
        "Hold": {
          "report": "/home/s2400011041/Desktop/fullstack_chipdesign/uploads/20261027_200222_4427c4b/work/pnr/my_soc_top/reports/postCTS_holdFix_check/func_ss_io/my_soc_top_postCTS_all_hold.tarpt.gz",
          "analysis_view": "func_ss_io",
          "archived_report": "evidence/stage_reports/29/pnr/my_soc_top/reports/postCTS_holdFix_check/func_ss_io/my_soc_top_postCTS_all_hold.tarpt.gz",
          "report_sha256": "50fa9b555a345a0869ea630959c38ce0c232fd400c98a763237276cffe57f3b1"
        }
      },
      "func_ff0_io": {
        "Setup": {
          "report": "/home/s2400011041/Desktop/fullstack_chipdesign/uploads/20261027_200222_4427c4b/work/pnr/my_soc_top/reports/postCTS_holdFix_check/func_ff0_io/my_soc_top_postCTS_all.tarpt.gz",
          "analysis_view": "func_ff0_io",
          "archived_report": "evidence/stage_reports/29/pnr/my_soc_top/reports/postCTS_holdFix_check/func_ff0_io/my_soc_top_postCTS_all.tarpt.gz",
          "report_sha256": "f5086209d2defeee2fc0dd03a110a1c5357357075b5de12cf8f5b141da3fb646"
        },
        "Hold": {
          "report": "/home/s2400011041/Desktop/fullstack_chipdesign/uploads/20261027_200222_4427c4b/work/pnr/my_soc_top/reports/postCTS_holdFix_check/func_ff0_io/my_soc_top_postCTS_all_hold.tarpt.gz",
          "analysis_view": "func_ff0_io",
          "archived_report": "evidence/stage_reports/29/pnr/my_soc_top/reports/postCTS_holdFix_check/func_ff0_io/my_soc_top_postCTS_all_hold.tarpt.gz",
          "report_sha256": "a53e930ba3ffcf8e37276075f13b2b55cd70718149c3c10f3482ad0725a4f694"
        }
      },
      "func_ffm40_io": {
        "Setup": {
          "report": "/home/s2400011041/Desktop/fullstack_chipdesign/uploads/20261027_200222_4427c4b/work/pnr/my_soc_top/reports/postCTS_holdFix_check/func_ffm40_io/my_soc_top_postCTS_all.tarpt.gz",
          "analysis_view": "func_ffm40_io",
          "archived_report": "evidence/stage_reports/29/pnr/my_soc_top/reports/postCTS_holdFix_check/func_ffm40_io/my_soc_top_postCTS_all.tarpt.gz",
          "report_sha256": "834434c12fa1588c24cd482626a0888142d2db97466e1be182f73fb70096fc21"
        },
        "Hold": {
          "report": "/home/s2400011041/Desktop/fullstack_chipdesign/uploads/20261027_200222_4427c4b/work/pnr/my_soc_top/reports/postCTS_holdFix_check/func_ffm40_io/my_soc_top_postCTS_all_hold.tarpt.gz",
          "analysis_view": "func_ffm40_io",
          "archived_report": "evidence/stage_reports/29/pnr/my_soc_top/reports/postCTS_holdFix_check/func_ffm40_io/my_soc_top_postCTS_all_hold.tarpt.gz",
          "report_sha256": "1567319fa52ea898893d7559b0abd416309bb90f86ba4a24ca13e4411f842340"
        }
      }
    },
    "timing_scope": "Pre-route diagnostic: residuals are recorded; only post-route steps32/33 require all timing/electrical targets met."
  },
  "scope": "Only the listed automatic checks are asserted. Tcl guards also check object counts, IO geometry and halo. Not complete signoff."
}
```

## 30 正式布线

**做什么：** 按允许金属层执行时序驱动布线，连接真实信号网络。

**为什么：** 前面的连接估计还不是完整可制造的金属，正式布线会改变延时。

**预期效果：** 生成正式导线和过孔，随后必须检查几何、连通、天线及真实RC。

**关键参数：** clock nets first优先时钟路由；postRoute low、tQuantusForPostRoute=false使用现有CapTable，不调用缺少Quantus techfile的medium设置；SI保持关闭。

**本轮实际执行片段：** 下列是运行时保存的Tcl正文；宏路径已解析，其他变量结合配置与日志阅读。

`001_30_tcl.tcl`

```tcl
# Actual sourced body; main SRAM resolved to i_mainmem/i_sram/i_macro
setAttribute -net VDDPST -skip_routing true
setAttribute -net VSSPST -skip_routing true
setDesignMode -bottomRoutingLayer METAL2 -topRoutingLayer METAL6
setNanoRouteMode -routeWithTimingDriven true -routeDesignRouteClockNetsFirst true
setExtractRCMode -engine postRoute -effortLevel low -tQuantusForPostRoute false
routeDesign
```

**本轮结果：** 步骤命令与对应自动检查已通过；详见`step_30.json`，独立验收范围以该JSON为准。

```json
{
  "step": 30,
  "commands_completed": true,
  "input_manifest_sha256": "c1b350a1f2550de2e21af03963a3450d3a6ad885f83b8e2bc00b99558cf63f6d",
  "automatic_checks": {
    "actual_rc_temperatures_C": {
      "tt_1p80v_25c": 25,
      "ss_pvt": 125,
      "ff0_pvt": 0,
      "ffm40_pvt": -40
    }
  },
  "scope": "Only the listed automatic checks are asserted. Tcl guards also check object counts, IO geometry and halo. Not complete signoff."
}
```

## 31 检查并修工艺天线

**做什么：** 独立检查，从本轮天线报告提取实际违规网，有限次修复；若修复后独立DRC仍有违规，再执行全设计detailRoute并复核。

**为什么：** 制造期间金属积累电荷可能损伤薄绝缘结构，不能复用旧违规网名。

**预期效果：** 天线、default DRC和常规信号连通通过，保留原始和修复报告。

**关键参数：** 从当前独立报告提取违规网络，最多max_repair_iterations次，当前配置5次；不使用历史网名。两项IO抽象限制只有同源步骤22证据齐备才可分类。选择网修复可能碰到相邻信号；先归档本轮before报告，再按当前DRC执行31_drc_fix.tcl，不以天线归零作为唯一退出条件。超过上限或报告格式不明仍停止。

**本轮实际执行片段：** 下列是运行时保存的Tcl正文；宏路径已解析，其他变量结合配置与日志阅读。

`001_31_check_tcl.tcl`

```tcl
# Actual sourced body; main SRAM resolved to i_mainmem/i_sram/i_macro
saveDesign ../my_soc_top/backup/my_soc_top_postRoute_raw.enc
verify_drc -check_only default -limit 100000 -report ../my_soc_top/my_soc_top_postRoute_drc.rpt
verifyConnectivity -type regular -error 100000 -report ../my_soc_top/my_soc_top_postRoute_signal_connectivity.rpt
verifyConnectivity -type special -net {VDD VSS} -allPGPinPort -error 100000 -report ../my_soc_top/my_soc_top_postRoute_pg.rpt
verifyProcessAntenna -report ../my_soc_top/my_soc_top_postRoute_antenna.rpt
```

`002_31_fix_tcl.tcl`

```tcl
# Actual sourced body; main SRAM resolved to i_mainmem/i_sram/i_macro
# Current antenna report: ../my_soc_top/my_soc_top_postRoute_antenna.rpt
# Read the CURRENT independent antenna report; no historical net list is used.
set ant_fd [open $eda_antenna_report r]
set ant_text [read $ant_fd]
close $ant_fd
set antenna_nets {}
foreach ant_line [split $ant_text "\n"] {
    if {[regexp {^(\S+) \([0-9]+\)$} [string trimright $ant_line] -> ant_net]} {
        lappend antenna_nets $ant_net
    }
}
set antenna_nets [lsort -unique $antenna_nets]
if {[regexp {Number of nets violated:\s+([0-9]+)} $ant_text -> ant_count]} {
    if {[llength $antenna_nets] != $ant_count} {error "Antenna report/net-count mismatch; inspect report"}
} elseif {[string first "No Violations Found" $ant_text] >= 0} {
    set ant_count 0
} else {error "Unrecognized antenna report; inspect manually"}
puts "CURRENT_ANTENNA_NETS $antenna_nets"
if {$ant_count > 0} {
    setNanoRouteMode -droutePostRouteSpreadWire false -drouteFixAntenna true
    setNanoRouteMode -reset -drouteEndIteration
    deselectAll
    foreach ant_net $antenna_nets {selectNet $ant_net}
    detailRoute -select
    deselectAll
}
verifyProcessAntenna -report ../my_soc_top/my_soc_top_postAntennaFix_antenna.rpt
verify_drc -check_only default -limit 100000 -report ../my_soc_top/my_soc_top_postAntennaFix_drc.rpt
verifyConnectivity -type regular -error 100000 -report ../my_soc_top/my_soc_top_postAntennaFix_signal.rpt
verifyConnectivity -type special -net {VDD VSS} -allPGPinPort -error 100000 -report ../my_soc_top/my_soc_top_postAntennaFix_pg.rpt
saveDesign ../my_soc_top/backup/my_soc_top_postRoute_antennaFixed.enc
```

**本轮结果：** 步骤命令与对应自动检查已通过；详见`step_31.json`，独立验收范围以该JSON为准。

```json
{
  "step": 31,
  "commands_completed": true,
  "input_manifest_sha256": "c1b350a1f2550de2e21af03963a3450d3a6ad885f83b8e2bc00b99558cf63f6d",
  "automatic_checks": {
    "actual_rc_temperatures_C": {
      "tt_1p80v_25c": 25,
      "ss_pvt": 125,
      "ff0_pvt": 0,
      "ffm40_pvt": -40
    },
    "default_drc": {
      "report": "/home/s2400011041/Desktop/fullstack_chipdesign/uploads/20261027_200222_4427c4b/work/pnr/my_soc_top/my_soc_top_postAntennaFix_drc.rpt",
      "zero_reported_violations": true,
      "scope": "drc",
      "archived_report": "evidence/stage_reports/31/pnr/my_soc_top/my_soc_top_postAntennaFix_drc.rpt",
      "report_sha256": "13fddb8ac8e76c7c047bcfa741f62461ab723d62d7b5e20c9e43cdccce0816c2"
    },
    "signal_connectivity": {
      "report": "/home/s2400011041/Desktop/fullstack_chipdesign/uploads/20261027_200222_4427c4b/work/pnr/my_soc_top/my_soc_top_postAntennaFix_signal.rpt",
      "unresolved_signal_problems": 0,
      "classified_io_abstract_nets": [
        "VDDPST",
        "VSSPST"
      ],
      "same_input_native_geometry_proof_step": 22,
      "not_independent_LVS": true,
      "archived_report": "evidence/stage_reports/31/pnr/my_soc_top/my_soc_top_postAntennaFix_signal.rpt",
      "report_sha256": "6c15680a562e79b459a21aba8affd0d6f43c5198e7df81d2a79d0175b52d61da"
    },
    "antenna": {
      "report": "/home/s2400011041/Desktop/fullstack_chipdesign/uploads/20261027_200222_4427c4b/work/pnr/my_soc_top/my_soc_top_postAntennaFix_antenna.rpt",
      "violating_nets": 0,
      "archived_report": "evidence/stage_reports/31/pnr/my_soc_top/my_soc_top_postAntennaFix_antenna.rpt",
      "report_sha256": "e83bcf9193262abe3850f8de77c9cb01de6f56aeca0ddcb0e94e0f150aebb0ef"
    }
  },
  "scope": "Only the listed automatic checks are asserted. Tcl guards also check object counts, IO geometry and halo. Not complete signoff."
}
```

## 32 真实RC下修复时序

**做什么：** 提取真实RC，按当前报告调用原生全设计Setup/DRV和Hold优化，独立重查。

**为什么：** 导线电阻电容会影响到达时间；布线前通过不等于布线后通过。

**预期效果：** 两种时序违规与Real/Total电气DRV归零，否则停止，不自动放宽时钟。

**关键参数：** 四库角最终Setup/Hold WNS均≥0、TNS=0、违规路径数=0；不要求100ps正余量。Hold先0目标，仍有负余量时按讲义尝试20ps优化目标，不改变验收零阈值。无手写扇出ECO，无额外Setup目标或人为转换时间限制。

**本轮实际执行片段：** 下列是运行时保存的Tcl正文；宏路径已解析，其他变量结合配置与日志阅读。

`001_32_extractRC.tcl`

```tcl
# Actual sourced body; main SRAM resolved to i_mainmem/i_sram/i_macro
# Current antenna report: ../my_soc_top/my_soc_top_postAntennaFix_antenna.rpt
extractRC
```

`002_32_initial_tcl.tcl`

```tcl
# Actual sourced body; main SRAM resolved to i_mainmem/i_sram/i_macro
# Current antenna report: ../my_soc_top/my_soc_top_postAntennaFix_antenna.rpt
timeDesign -postRoute -expandedViews -outDir ../my_soc_top/reports/postRoute
timeDesign -postRoute -hold -expandedViews -outDir ../my_soc_top/reports/postRoute
```

`003_32_native_setup_drv.tcl`

```tcl
# Actual sourced body; main SRAM resolved to i_mainmem/i_sram/i_macro
# Current antenna report: ../my_soc_top/my_soc_top_postAntennaFix_antenna.rpt
optDesign -postRoute -expandedViews -outDir ../my_soc_top/reports/postRoute_setupAuto
```

`004_32_check_tcl.tcl`

```tcl
# Actual sourced body; main SRAM resolved to i_mainmem/i_sram/i_macro
# Current antenna report: ../my_soc_top/my_soc_top_postAntennaFix_antenna.rpt
timeDesign -postRoute -expandedViews -outDir ../my_soc_top/reports/postRoute_holdAuto_check
timeDesign -postRoute -hold -expandedViews -outDir ../my_soc_top/reports/postRoute_holdAuto_check

globalNetConnect VDD -type pgpin -pin VDD -all
globalNetConnect VSS -type pgpin -pin VSS -all
checkPlace ../my_soc_top/my_soc_top_postHoldAuto_place.rpt -ignoreOutOfCore
verify_drc -check_only default -limit 100000 -report ../my_soc_top/my_soc_top_postHoldAuto_drc.rpt
verifyConnectivity -type regular -error 100000 -report ../my_soc_top/my_soc_top_postHoldAuto_signal.rpt
verifyConnectivity -type special -net {VDD VSS} -allPGPinPort -error 100000 -report ../my_soc_top/my_soc_top_postHoldAuto_pg.rpt
verifyProcessAntenna -report ../my_soc_top/my_soc_top_postHoldAuto_antenna.rpt
saveDesign ../my_soc_top/backup/my_soc_top_postRoute_timingFixed.enc
```

`005_32_hold_mode.tcl`

```tcl
# Actual sourced body; main SRAM resolved to i_mainmem/i_sram/i_macro
# Current antenna report: ../my_soc_top/my_soc_top_postAntennaFix_antenna.rpt
setOptMode -fixHoldAllowSetupTnsDegrade false -holdTargetSlack 0
```

`006_32_native_hold.tcl`

```tcl
# Actual sourced body; main SRAM resolved to i_mainmem/i_sram/i_macro
# Current antenna report: ../my_soc_top/my_soc_top_postAntennaFix_antenna.rpt
optDesign -postRoute -hold -expandedViews -outDir ../my_soc_top/reports/postRoute_holdAuto
```

`007_32_check_tcl.tcl`

```tcl
# Actual sourced body; main SRAM resolved to i_mainmem/i_sram/i_macro
# Current antenna report: ../my_soc_top/my_soc_top_postAntennaFix_antenna.rpt
timeDesign -postRoute -expandedViews -outDir ../my_soc_top/reports/postRoute_holdAuto_check
timeDesign -postRoute -hold -expandedViews -outDir ../my_soc_top/reports/postRoute_holdAuto_check

globalNetConnect VDD -type pgpin -pin VDD -all
globalNetConnect VSS -type pgpin -pin VSS -all
checkPlace ../my_soc_top/my_soc_top_postHoldAuto_place.rpt -ignoreOutOfCore
verify_drc -check_only default -limit 100000 -report ../my_soc_top/my_soc_top_postHoldAuto_drc.rpt
verifyConnectivity -type regular -error 100000 -report ../my_soc_top/my_soc_top_postHoldAuto_signal.rpt
verifyConnectivity -type special -net {VDD VSS} -allPGPinPort -error 100000 -report ../my_soc_top/my_soc_top_postHoldAuto_pg.rpt
verifyProcessAntenna -report ../my_soc_top/my_soc_top_postHoldAuto_antenna.rpt
saveDesign ../my_soc_top/backup/my_soc_top_postRoute_timingFixed.enc
```

`008_32_hold_mode.tcl`

```tcl
# Actual sourced body; main SRAM resolved to i_mainmem/i_sram/i_macro
# Current antenna report: ../my_soc_top/my_soc_top_postAntennaFix_antenna.rpt
setOptMode -fixHoldAllowSetupTnsDegrade false -holdTargetSlack 0.02
```

`009_32_native_hold.tcl`

```tcl
# Actual sourced body; main SRAM resolved to i_mainmem/i_sram/i_macro
# Current antenna report: ../my_soc_top/my_soc_top_postAntennaFix_antenna.rpt
optDesign -postRoute -hold -expandedViews -outDir ../my_soc_top/reports/postRoute_holdAuto
```

`010_32_check_tcl.tcl`

```tcl
# Actual sourced body; main SRAM resolved to i_mainmem/i_sram/i_macro
# Current antenna report: ../my_soc_top/my_soc_top_postAntennaFix_antenna.rpt
timeDesign -postRoute -expandedViews -outDir ../my_soc_top/reports/postRoute_holdAuto_check
timeDesign -postRoute -hold -expandedViews -outDir ../my_soc_top/reports/postRoute_holdAuto_check

globalNetConnect VDD -type pgpin -pin VDD -all
globalNetConnect VSS -type pgpin -pin VSS -all
checkPlace ../my_soc_top/my_soc_top_postHoldAuto_place.rpt -ignoreOutOfCore
verify_drc -check_only default -limit 100000 -report ../my_soc_top/my_soc_top_postHoldAuto_drc.rpt
verifyConnectivity -type regular -error 100000 -report ../my_soc_top/my_soc_top_postHoldAuto_signal.rpt
verifyConnectivity -type special -net {VDD VSS} -allPGPinPort -error 100000 -report ../my_soc_top/my_soc_top_postHoldAuto_pg.rpt
verifyProcessAntenna -report ../my_soc_top/my_soc_top_postHoldAuto_antenna.rpt
saveDesign ../my_soc_top/backup/my_soc_top_postRoute_timingFixed.enc
```

`011_32_check_tcl.tcl`

```tcl
# Actual sourced body; main SRAM resolved to i_mainmem/i_sram/i_macro
# Current antenna report: ../my_soc_top/my_soc_top_postAntennaFix_antenna.rpt
timeDesign -postRoute -expandedViews -outDir ../my_soc_top/reports/postRoute_holdAuto_check
timeDesign -postRoute -hold -expandedViews -outDir ../my_soc_top/reports/postRoute_holdAuto_check

globalNetConnect VDD -type pgpin -pin VDD -all
globalNetConnect VSS -type pgpin -pin VSS -all
checkPlace ../my_soc_top/my_soc_top_postHoldAuto_place.rpt -ignoreOutOfCore
verify_drc -check_only default -limit 100000 -report ../my_soc_top/my_soc_top_postHoldAuto_drc.rpt
verifyConnectivity -type regular -error 100000 -report ../my_soc_top/my_soc_top_postHoldAuto_signal.rpt
verifyConnectivity -type special -net {VDD VSS} -allPGPinPort -error 100000 -report ../my_soc_top/my_soc_top_postHoldAuto_pg.rpt
verifyProcessAntenna -report ../my_soc_top/my_soc_top_postHoldAuto_antenna.rpt
saveDesign ../my_soc_top/backup/my_soc_top_postRoute_timingFixed.enc
```

**本轮结果：** 步骤命令与对应自动检查已通过；详见`step_32.json`，独立验收范围以该JSON为准。

```json
{
  "step": 32,
  "commands_completed": true,
  "input_manifest_sha256": "c1b350a1f2550de2e21af03963a3450d3a6ad885f83b8e2bc00b99558cf63f6d",
  "automatic_checks": {
    "actual_rc_temperatures_C": {
      "tt_1p80v_25c": 25,
      "ss_pvt": 125,
      "ff0_pvt": 0,
      "ffm40_pvt": -40
    },
    "placement": {
      "report": "/home/s2400011041/Desktop/fullstack_chipdesign/uploads/20261027_200222_4427c4b/work/pnr/my_soc_top/my_soc_top_postHoldAuto_place.rpt",
      "unplaced": 0,
      "expected_io_bond_covers": [
        "i_pad_E_poc",
        "i_pad_E_vdd_1",
        "i_pad_E_vdd_2",
        "i_pad_E_vddio",
        "i_pad_E_vss_1",
        "i_pad_E_vss_2",
        "i_pad_E_vssio",
        "i_pad_N_poc",
        "i_pad_N_vdd_1",
        "i_pad_N_vdd_2",
        "i_pad_N_vddio",
        "i_pad_N_vss_1",
        "i_pad_N_vss_2",
        "i_pad_N_vssio",
        "i_pad_S_poc",
        "i_pad_S_vdd_1",
        "i_pad_S_vdd_2",
        "i_pad_S_vddio",
        "i_pad_S_vss_1",
        "i_pad_S_vss_2",
        "i_pad_S_vssio",
        "i_pad_W_poc",
        "i_pad_W_vdd_1",
        "i_pad_W_vdd_2",
        "i_pad_W_vddio",
        "i_pad_W_vss_1",
        "i_pad_W_vss_2",
        "i_pad_W_vssio",
        "i_pad_clk",
        "i_pad_rst_n",
        "i_pad_tck",
        "i_pad_tdi",
        "i_pad_tdo",
        "i_pad_tms"
      ],
      "no_other_listed_placement_violations": true,
      "archived_report": "evidence/stage_reports/32/pnr/my_soc_top/my_soc_top_postHoldAuto_place.rpt",
      "report_sha256": "67dd3b5a84b20a9fd7066feac9b681da67b304b8ad04da0ce263620430a10ad1"
    },
    "timing": {
      "Setup": {
        "report": "/home/s2400011041/Desktop/fullstack_chipdesign/uploads/20261027_200222_4427c4b/work/pnr/my_soc_top/reports/postRoute_holdAuto_check/my_soc_top_postRoute.summary.gz",
        "wns_ns": 0.001,
        "tns_ns": 0.0,
        "violating_paths": 0,
        "drv": {
          "max_cap": {
            "real": 0,
            "total": 0
          },
          "max_tran": {
            "real": 0,
            "total": 0
          },
          "max_fanout": {
            "real": 0,
            "total": 0
          },
          "max_length": {
            "real": 0,
            "total": 0
          }
        },
        "electrical_drv_table_reported_here": true,
        "minimum_wns_ns": 0.0,
        "targets_met": true,
        "archived_report": "evidence/stage_reports/32/pnr/my_soc_top/reports/postRoute_holdAuto_check/my_soc_top_postRoute.summary.gz",
        "report_sha256": "a94e45278867126d1ee7151abd56a8f3b556c4213027523702c3de00c8b0d08d"
      },
      "Hold": {
        "report": "/home/s2400011041/Desktop/fullstack_chipdesign/uploads/20261027_200222_4427c4b/work/pnr/my_soc_top/reports/postRoute_holdAuto_check/my_soc_top_postRoute_hold.summary.gz",
        "wns_ns": 0.02,
        "tns_ns": 0.0,
        "violating_paths": 0,
        "drv": {},
        "electrical_drv_table_reported_here": false,
        "minimum_wns_ns": 0.0,
        "targets_met": true,
        "archived_report": "evidence/stage_reports/32/pnr/my_soc_top/reports/postRoute_holdAuto_check/my_soc_top_postRoute_hold.summary.gz",
        "report_sha256": "6c3313ba21f0c78d78068540c587b28d04590805407ad88dfe088861a8bd019c"
      }
    },
    "expanded_analysis_views": {
      "func_tt_io": {
        "Setup": {
          "report": "/home/s2400011041/Desktop/fullstack_chipdesign/uploads/20261027_200222_4427c4b/work/pnr/my_soc_top/reports/postRoute_holdAuto_check/func_tt_io/my_soc_top_postRoute_all.tarpt.gz",
          "analysis_view": "func_tt_io",
          "archived_report": "evidence/stage_reports/32/pnr/my_soc_top/reports/postRoute_holdAuto_check/func_tt_io/my_soc_top_postRoute_all.tarpt.gz",
          "report_sha256": "145e1a1b45ae7709d0a3651792f678386ea3d386e308747c330eae5191cd2bc8"
        },
        "Hold": {
          "report": "/home/s2400011041/Desktop/fullstack_chipdesign/uploads/20261027_200222_4427c4b/work/pnr/my_soc_top/reports/postRoute_holdAuto_check/func_tt_io/my_soc_top_postRoute_all_hold.tarpt.gz",
          "analysis_view": "func_tt_io",
          "archived_report": "evidence/stage_reports/32/pnr/my_soc_top/reports/postRoute_holdAuto_check/func_tt_io/my_soc_top_postRoute_all_hold.tarpt.gz",
          "report_sha256": "5fcae94c7cd44cf7895ffaecbfa8c7486669f2ae2bb0674da63d312297f86d44"
        }
      },
      "func_ss_io": {
        "Setup": {
          "report": "/home/s2400011041/Desktop/fullstack_chipdesign/uploads/20261027_200222_4427c4b/work/pnr/my_soc_top/reports/postRoute_holdAuto_check/func_ss_io/my_soc_top_postRoute_all.tarpt.gz",
          "analysis_view": "func_ss_io",
          "archived_report": "evidence/stage_reports/32/pnr/my_soc_top/reports/postRoute_holdAuto_check/func_ss_io/my_soc_top_postRoute_all.tarpt.gz",
          "report_sha256": "071de5e069fc1f453cedfc8702753347272a8b2dbb01a121fe62a16f20d2ba23"
        },
        "Hold": {
          "report": "/home/s2400011041/Desktop/fullstack_chipdesign/uploads/20261027_200222_4427c4b/work/pnr/my_soc_top/reports/postRoute_holdAuto_check/func_ss_io/my_soc_top_postRoute_all_hold.tarpt.gz",
          "analysis_view": "func_ss_io",
          "archived_report": "evidence/stage_reports/32/pnr/my_soc_top/reports/postRoute_holdAuto_check/func_ss_io/my_soc_top_postRoute_all_hold.tarpt.gz",
          "report_sha256": "16cd6ad42c73d3d3b866f245b9cdcf5bff55b74ce440e338dc99b55497bde4bb"
        }
      },
      "func_ff0_io": {
        "Setup": {
          "report": "/home/s2400011041/Desktop/fullstack_chipdesign/uploads/20261027_200222_4427c4b/work/pnr/my_soc_top/reports/postRoute_holdAuto_check/func_ff0_io/my_soc_top_postRoute_all.tarpt.gz",
          "analysis_view": "func_ff0_io",
          "archived_report": "evidence/stage_reports/32/pnr/my_soc_top/reports/postRoute_holdAuto_check/func_ff0_io/my_soc_top_postRoute_all.tarpt.gz",
          "report_sha256": "2b1676f58b39a7e6a4a9c8ad51c0e139d70851c98a3507ec0e459961d1d54483"
        },
        "Hold": {
          "report": "/home/s2400011041/Desktop/fullstack_chipdesign/uploads/20261027_200222_4427c4b/work/pnr/my_soc_top/reports/postRoute_holdAuto_check/func_ff0_io/my_soc_top_postRoute_all_hold.tarpt.gz",
          "analysis_view": "func_ff0_io",
          "archived_report": "evidence/stage_reports/32/pnr/my_soc_top/reports/postRoute_holdAuto_check/func_ff0_io/my_soc_top_postRoute_all_hold.tarpt.gz",
          "report_sha256": "c596397ef68b9aec827300f1c4f4a5581011daf332a5f4fbec75b90cee7f175f"
        }
      },
      "func_ffm40_io": {
        "Setup": {
          "report": "/home/s2400011041/Desktop/fullstack_chipdesign/uploads/20261027_200222_4427c4b/work/pnr/my_soc_top/reports/postRoute_holdAuto_check/func_ffm40_io/my_soc_top_postRoute_all.tarpt.gz",
          "analysis_view": "func_ffm40_io",
          "archived_report": "evidence/stage_reports/32/pnr/my_soc_top/reports/postRoute_holdAuto_check/func_ffm40_io/my_soc_top_postRoute_all.tarpt.gz",
          "report_sha256": "d6f7c3404b88fb3f8e0b0bc9307d07a54afeebcb1ffbc90ab834e19a36138c16"
        },
        "Hold": {
          "report": "/home/s2400011041/Desktop/fullstack_chipdesign/uploads/20261027_200222_4427c4b/work/pnr/my_soc_top/reports/postRoute_holdAuto_check/func_ffm40_io/my_soc_top_postRoute_all_hold.tarpt.gz",
          "analysis_view": "func_ffm40_io",
          "archived_report": "evidence/stage_reports/32/pnr/my_soc_top/reports/postRoute_holdAuto_check/func_ffm40_io/my_soc_top_postRoute_all_hold.tarpt.gz",
          "report_sha256": "70cadb143a5e960b4dad3dc8005bc40746df70327dbb595e6d0b8d8f13b5ebeb"
        }
      }
    },
    "default_drc": {
      "report": "/home/s2400011041/Desktop/fullstack_chipdesign/uploads/20261027_200222_4427c4b/work/pnr/my_soc_top/my_soc_top_postHoldAuto_drc.rpt",
      "zero_reported_violations": true,
      "scope": "drc",
      "archived_report": "evidence/stage_reports/32/pnr/my_soc_top/my_soc_top_postHoldAuto_drc.rpt",
      "report_sha256": "451a9bbc950574ebba570f954fcd94e878b8270339bb04a86f192b36076307c8"
    },
    "signal_connectivity": {
      "report": "/home/s2400011041/Desktop/fullstack_chipdesign/uploads/20261027_200222_4427c4b/work/pnr/my_soc_top/my_soc_top_postHoldAuto_signal.rpt",
      "unresolved_signal_problems": 0,
      "classified_io_abstract_nets": [
        "VDDPST",
        "VSSPST"
      ],
      "same_input_native_geometry_proof_step": 22,
      "not_independent_LVS": true,
      "archived_report": "evidence/stage_reports/32/pnr/my_soc_top/my_soc_top_postHoldAuto_signal.rpt",
      "report_sha256": "cd3a37ac3fae4d9f1648f4d8a8c7f686ce9084b772aeeaf6750515ba876a7d32"
    },
    "antenna": {
      "report": "/home/s2400011041/Desktop/fullstack_chipdesign/uploads/20261027_200222_4427c4b/work/pnr/my_soc_top/my_soc_top_postHoldAuto_antenna.rpt",
      "violating_nets": 0,
      "archived_report": "evidence/stage_reports/32/pnr/my_soc_top/my_soc_top_postHoldAuto_antenna.rpt",
      "report_sha256": "090b92ad24dcb57752c368cd8a7a494828cbdcdc100fac12b6f1a8139175c325"
    }
  },
  "scope": "Only the listed automatic checks are asserted. Tcl guards also check object counts, IO geometry and halo. Not complete signoff."
}
```

## 33 核心填充及最终复核

**做什么：** 插核心Filler后用editTrim修剪VDD/VSS多余线端，重新提取RC，检查放置、完整核心PG、几何、天线和时序。

**为什么：** 填充后设计发生变化，要在最终状态验收；中途排除悬线的PG检查不够。

**预期效果：** 最终各检查通过，保存可恢复的完整阶段点。

**关键参数：** ecoMode/fitGap按讲义匹配剩余空隙；check_signal_drc=true且add_fillers_with_drc=false，不允许为了填满而引入已知DRC。 仅在最终物理单元和Filler接入后，editTrim -nets {VDD VSS}作用于真实电源几何；完整verifyConnectivity仍包含悬线检查，没有使用noAntenna跳过。

**本轮实际执行片段：** 下列是运行时保存的Tcl正文；宏路径已解析，其他变量结合配置与日志阅读。

`001_33_tcl.tcl`

```tcl
# Actual sourced body; main SRAM resolved to i_mainmem/i_sram/i_macro
# Current antenna report: ../my_soc_top/my_soc_top_postAntennaFix_antenna.rpt
globalNetConnect VDD -type pgpin -pin VDD -all
globalNetConnect VSS -type pgpin -pin VSS -all
setFillerMode -core {FILL64BWP7T FILL32BWP7T FILL16BWP7T FILL8BWP7T FILL4BWP7T FILL2BWP7T FILL1BWP7T} -corePrefix FILLER -createRows false -diffCellViol true -ecoMode true -fitGap true -scheme locationFirst -honorPrerouteAsObs false -check_signal_drc true -add_fillers_with_drc false
addFiller
globalNetConnect VDD -type pgpin -pin VDD -all
globalNetConnect VSS -type pgpin -pin VSS -all
checkPlace ../my_soc_top/my_soc_top_postFiller_place.rpt -ignoreOutOfCore
# All physical cells, route repair and fillers now exist. Only now trim
# redundant stubs, then require the unfiltered full PG report clean.
editTrim -nets {VDD VSS}
verifyConnectivity -type special -net {VDD VSS} -allPGPinPort -error 100000 -report ../my_soc_top/my_soc_top_postFiller_pg.rpt
verify_drc -check_only default -limit 100000 -report ../my_soc_top/my_soc_top_postFiller_drc.rpt

extractRC
timeDesign -postRoute -expandedViews -outDir ../my_soc_top/reports/postFiller
timeDesign -postRoute -hold -expandedViews -outDir ../my_soc_top/reports/postFiller
verifyProcessAntenna -report ../my_soc_top/my_soc_top_postFiller_antenna.rpt
verifyConnectivity -type regular -error 100000 -report ../my_soc_top/my_soc_top_postFiller_signal.rpt
saveDesign ../my_soc_top/backup/my_soc_top_postFiller.enc
```

**本轮结果：** 步骤命令与对应自动检查已通过；详见`step_33.json`，独立验收范围以该JSON为准。

```json
{
  "step": 33,
  "commands_completed": true,
  "input_manifest_sha256": "c1b350a1f2550de2e21af03963a3450d3a6ad885f83b8e2bc00b99558cf63f6d",
  "automatic_checks": {
    "actual_rc_temperatures_C": {
      "tt_1p80v_25c": 25,
      "ss_pvt": 125,
      "ff0_pvt": 0,
      "ffm40_pvt": -40
    },
    "placement": {
      "report": "/home/s2400011041/Desktop/fullstack_chipdesign/uploads/20261027_200222_4427c4b/work/pnr/my_soc_top/my_soc_top_postFiller_place.rpt",
      "unplaced": 0,
      "expected_io_bond_covers": [
        "i_pad_E_poc",
        "i_pad_E_vdd_1",
        "i_pad_E_vdd_2",
        "i_pad_E_vddio",
        "i_pad_E_vss_1",
        "i_pad_E_vss_2",
        "i_pad_E_vssio",
        "i_pad_N_poc",
        "i_pad_N_vdd_1",
        "i_pad_N_vdd_2",
        "i_pad_N_vddio",
        "i_pad_N_vss_1",
        "i_pad_N_vss_2",
        "i_pad_N_vssio",
        "i_pad_S_poc",
        "i_pad_S_vdd_1",
        "i_pad_S_vdd_2",
        "i_pad_S_vddio",
        "i_pad_S_vss_1",
        "i_pad_S_vss_2",
        "i_pad_S_vssio",
        "i_pad_W_poc",
        "i_pad_W_vdd_1",
        "i_pad_W_vdd_2",
        "i_pad_W_vddio",
        "i_pad_W_vss_1",
        "i_pad_W_vss_2",
        "i_pad_W_vssio",
        "i_pad_clk",
        "i_pad_rst_n",
        "i_pad_tck",
        "i_pad_tdi",
        "i_pad_tdo",
        "i_pad_tms"
      ],
      "no_other_listed_placement_violations": true,
      "archived_report": "evidence/stage_reports/33/pnr/my_soc_top/my_soc_top_postFiller_place.rpt",
      "report_sha256": "d25eeb90dbc1853a92db3b69f5650d9dc29ca52c853b5e730d679d57d64b8c59"
    },
    "timing": {
      "Setup": {
        "report": "/home/s2400011041/Desktop/fullstack_chipdesign/uploads/20261027_200222_4427c4b/work/pnr/my_soc_top/reports/postFiller/my_soc_top_postRoute.summary.gz",
        "wns_ns": 0.001,
        "tns_ns": 0.0,
        "violating_paths": 0,
        "drv": {
          "max_cap": {
            "real": 0,
            "total": 0
          },
          "max_tran": {
            "real": 0,
            "total": 0
          },
          "max_fanout": {
            "real": 0,
            "total": 0
          },
          "max_length": {
            "real": 0,
            "total": 0
          }
        },
        "electrical_drv_table_reported_here": true,
        "minimum_wns_ns": 0.0,
        "targets_met": true,
        "archived_report": "evidence/stage_reports/33/pnr/my_soc_top/reports/postFiller/my_soc_top_postRoute.summary.gz",
        "report_sha256": "a0a641b3626a52e6531d0b0d9e033d5a74754e36556e5e85a53a3fb36072f846"
      },
      "Hold": {
        "report": "/home/s2400011041/Desktop/fullstack_chipdesign/uploads/20261027_200222_4427c4b/work/pnr/my_soc_top/reports/postFiller/my_soc_top_postRoute_hold.summary.gz",
        "wns_ns": 0.02,
        "tns_ns": 0.0,
        "violating_paths": 0,
        "drv": {},
        "electrical_drv_table_reported_here": false,
        "minimum_wns_ns": 0.0,
        "targets_met": true,
        "archived_report": "evidence/stage_reports/33/pnr/my_soc_top/reports/postFiller/my_soc_top_postRoute_hold.summary.gz",
        "report_sha256": "008666dbf4c44f9b09c27d56bb26295eeee09ee6a19ae222a63ac27e7eb54219"
      }
    },
    "expanded_analysis_views": {
      "func_tt_io": {
        "Setup": {
          "report": "/home/s2400011041/Desktop/fullstack_chipdesign/uploads/20261027_200222_4427c4b/work/pnr/my_soc_top/reports/postFiller/func_tt_io/my_soc_top_postRoute_all.tarpt.gz",
          "analysis_view": "func_tt_io",
          "archived_report": "evidence/stage_reports/33/pnr/my_soc_top/reports/postFiller/func_tt_io/my_soc_top_postRoute_all.tarpt.gz",
          "report_sha256": "9988d6a9fc8ad1e5322f3ea62627bbb5352fa7d26839db316ee42e64ab049a62"
        },
        "Hold": {
          "report": "/home/s2400011041/Desktop/fullstack_chipdesign/uploads/20261027_200222_4427c4b/work/pnr/my_soc_top/reports/postFiller/func_tt_io/my_soc_top_postRoute_all_hold.tarpt.gz",
          "analysis_view": "func_tt_io",
          "archived_report": "evidence/stage_reports/33/pnr/my_soc_top/reports/postFiller/func_tt_io/my_soc_top_postRoute_all_hold.tarpt.gz",
          "report_sha256": "37856fe9fc3a6046e6e93ffe8270baf00fbec847af342dc13b9ffff12f638ad4"
        }
      },
      "func_ss_io": {
        "Setup": {
          "report": "/home/s2400011041/Desktop/fullstack_chipdesign/uploads/20261027_200222_4427c4b/work/pnr/my_soc_top/reports/postFiller/func_ss_io/my_soc_top_postRoute_all.tarpt.gz",
          "analysis_view": "func_ss_io",
          "archived_report": "evidence/stage_reports/33/pnr/my_soc_top/reports/postFiller/func_ss_io/my_soc_top_postRoute_all.tarpt.gz",
          "report_sha256": "367e5bc280327201133e2cb6a502b70211b00ee0ae54fbe98b8a717573cab1d9"
        },
        "Hold": {
          "report": "/home/s2400011041/Desktop/fullstack_chipdesign/uploads/20261027_200222_4427c4b/work/pnr/my_soc_top/reports/postFiller/func_ss_io/my_soc_top_postRoute_all_hold.tarpt.gz",
          "analysis_view": "func_ss_io",
          "archived_report": "evidence/stage_reports/33/pnr/my_soc_top/reports/postFiller/func_ss_io/my_soc_top_postRoute_all_hold.tarpt.gz",
          "report_sha256": "40144bc50b4769ad2dbcd578cd333ce5fa08d375906e182fae843b91708b9595"
        }
      },
      "func_ff0_io": {
        "Setup": {
          "report": "/home/s2400011041/Desktop/fullstack_chipdesign/uploads/20261027_200222_4427c4b/work/pnr/my_soc_top/reports/postFiller/func_ff0_io/my_soc_top_postRoute_all.tarpt.gz",
          "analysis_view": "func_ff0_io",
          "archived_report": "evidence/stage_reports/33/pnr/my_soc_top/reports/postFiller/func_ff0_io/my_soc_top_postRoute_all.tarpt.gz",
          "report_sha256": "75839a6cf1a9747a347dd6fb150216070cc34ae309e81293067f4bc5a307b343"
        },
        "Hold": {
          "report": "/home/s2400011041/Desktop/fullstack_chipdesign/uploads/20261027_200222_4427c4b/work/pnr/my_soc_top/reports/postFiller/func_ff0_io/my_soc_top_postRoute_all_hold.tarpt.gz",
          "analysis_view": "func_ff0_io",
          "archived_report": "evidence/stage_reports/33/pnr/my_soc_top/reports/postFiller/func_ff0_io/my_soc_top_postRoute_all_hold.tarpt.gz",
          "report_sha256": "b66b2289c5db77aae33d663283ccc771f7a86ab4a49fad68650a00bf0e3b08d6"
        }
      },
      "func_ffm40_io": {
        "Setup": {
          "report": "/home/s2400011041/Desktop/fullstack_chipdesign/uploads/20261027_200222_4427c4b/work/pnr/my_soc_top/reports/postFiller/func_ffm40_io/my_soc_top_postRoute_all.tarpt.gz",
          "analysis_view": "func_ffm40_io",
          "archived_report": "evidence/stage_reports/33/pnr/my_soc_top/reports/postFiller/func_ffm40_io/my_soc_top_postRoute_all.tarpt.gz",
          "report_sha256": "b0dd7282d577780f4a6a97c2fd1e9d8f7ee77c2b1082d3433ad239cde7948dd9"
        },
        "Hold": {
          "report": "/home/s2400011041/Desktop/fullstack_chipdesign/uploads/20261027_200222_4427c4b/work/pnr/my_soc_top/reports/postFiller/func_ffm40_io/my_soc_top_postRoute_all_hold.tarpt.gz",
          "analysis_view": "func_ffm40_io",
          "archived_report": "evidence/stage_reports/33/pnr/my_soc_top/reports/postFiller/func_ffm40_io/my_soc_top_postRoute_all_hold.tarpt.gz",
          "report_sha256": "111ea74b5993153611abd5d12c6f44650ddf26c1f744438e9b14ff706d15405d"
        }
      }
    },
    "default_drc": {
      "report": "/home/s2400011041/Desktop/fullstack_chipdesign/uploads/20261027_200222_4427c4b/work/pnr/my_soc_top/my_soc_top_postFiller_drc.rpt",
      "zero_reported_violations": true,
      "scope": "drc",
      "archived_report": "evidence/stage_reports/33/pnr/my_soc_top/my_soc_top_postFiller_drc.rpt",
      "report_sha256": "91cddd102b1b8d6680d9001152431b22bad3d91f99926274544f359b3d839c5e"
    },
    "signal_connectivity": {
      "report": "/home/s2400011041/Desktop/fullstack_chipdesign/uploads/20261027_200222_4427c4b/work/pnr/my_soc_top/my_soc_top_postFiller_signal.rpt",
      "unresolved_signal_problems": 0,
      "classified_io_abstract_nets": [
        "VDDPST",
        "VSSPST"
      ],
      "same_input_native_geometry_proof_step": 22,
      "not_independent_LVS": true,
      "archived_report": "evidence/stage_reports/33/pnr/my_soc_top/my_soc_top_postFiller_signal.rpt",
      "report_sha256": "a79d7fea701a25b4cbbfee3762481d9b5d05eb996ba9d7ee4a4b001546076e1f"
    },
    "full_core_pg": {
      "report": "/home/s2400011041/Desktop/fullstack_chipdesign/uploads/20261027_200222_4427c4b/work/pnr/my_soc_top/my_soc_top_postFiller_pg.rpt",
      "zero_reported_violations": true,
      "scope": "connectivity",
      "archived_report": "evidence/stage_reports/33/pnr/my_soc_top/my_soc_top_postFiller_pg.rpt",
      "report_sha256": "71e9dfc4d89e031a5c33a8c9add812db265f60cba4ae33e446e45910902caa50"
    },
    "antenna": {
      "report": "/home/s2400011041/Desktop/fullstack_chipdesign/uploads/20261027_200222_4427c4b/work/pnr/my_soc_top/my_soc_top_postFiller_antenna.rpt",
      "violating_nets": 0,
      "archived_report": "evidence/stage_reports/33/pnr/my_soc_top/my_soc_top_postFiller_antenna.rpt",
      "report_sha256": "2b89e6bd87b9abc0728de7d40c4f7881fe368efac941960037310e35e567d010"
    }
  },
  "scope": "Only the listed automatic checks are asserted. Tcl guards also check object counts, IO geometry and halo. Not complete signoff."
}
```

## 34 导出并交叉核对

**做什么：** 导出DEF、两种网表、SDC、SPEF/SDF、LEF、合并GDS。

**为什么：** 后续工具需要连接、位置、时间和真实几何的不同表达，它们必须一致。

**预期效果：** 核对十端口、尺寸、网表/SDF路径、寄生记录和GDS引用；不冒称独立工艺签核。

**关键参数：** GDS合并四套原生库输入，使用当前层映射和2000 DBU/um；SPEF/SDF取func_tt_io。检查尺寸与当前geometry.json一致，不硬编码旧实例数或GDS结构数。

**本轮实际执行片段：** 下列是运行时保存的Tcl正文；宏路径已解析，其他变量结合配置与日志阅读。

`001_34_extractRC.tcl`

```tcl
# Actual sourced body; main SRAM resolved to i_mainmem/i_sram/i_macro
# Current antenna report: ../my_soc_top/my_soc_top_postAntennaFix_antenna.rpt
extractRC
```

`002_34_1_tcl.tcl`

```tcl
# Actual sourced body; main SRAM resolved to i_mainmem/i_sram/i_macro
# Current antenna report: ../my_soc_top/my_soc_top_postAntennaFix_antenna.rpt
file mkdir ../my_soc_top/outputs/manual_final
saveDesign ../my_soc_top/backup/my_soc_top_postPinLabels.enc
defOut -routing ../my_soc_top/outputs/manual_final/my_soc_top.def
```

`003_34_2_tcl.tcl`

```tcl
# Actual sourced body; main SRAM resolved to i_mainmem/i_sram/i_macro
# Current antenna report: ../my_soc_top/my_soc_top_postAntennaFix_antenna.rpt
saveNetlist ../my_soc_top/outputs/manual_final/my_soc_top_flat_lvs.v -excludeLeafCell -flat -phys -excludeCellInst {FILL1BWP7T FILL2BWP7T FILL4BWP7T FILL8BWP7T FILL16BWP7T FILL32BWP7T FILL64BWP7T TAPCELLBWP7T PCORNER PFILLER20 PFILLER10 PFILLER5 PFILLER1 PFILLER05 PFILLER0005 PRCUT PAD60LU_OBV}
```

`004_34_3_tcl.tcl`

```tcl
# Actual sourced body; main SRAM resolved to i_mainmem/i_sram/i_macro
# Current antenna report: ../my_soc_top/my_soc_top_postAntennaFix_antenna.rpt
saveNetlist ../my_soc_top/outputs/manual_final/my_soc_top_hier_postpnr.v -excludeLeafCell -topModuleFirst -removePowerGround -excludeCellInst {FILL1BWP7T FILL2BWP7T FILL4BWP7T FILL8BWP7T FILL16BWP7T FILL32BWP7T FILL64BWP7T TAPCELLBWP7T PCORNER PFILLER20 PFILLER10 PFILLER5 PFILLER1 PFILLER05 PFILLER0005 PRCUT PAD60LU_OBV DCAPBWP7T DCAP4BWP7T DCAP8BWP7T DCAP16BWP7T DCAP32BWP7T DCAP64BWP7T ANTENNABWP7T}
write_sdc -view func_tt_io > ../my_soc_top/outputs/manual_final/my_soc_top.sdc
write_sdc -path_adjust_only > ../my_soc_top/outputs/manual_final/my_soc_top_path_adjust.tcl
```

`005_34_4_tcl.tcl`

```tcl
# Actual sourced body; main SRAM resolved to i_mainmem/i_sram/i_macro
# Current antenna report: ../my_soc_top/my_soc_top_postAntennaFix_antenna.rpt
rcOut -view func_tt_io -cUnit pF -spef ../my_soc_top/outputs/manual_final/my_soc_top_tt_io.spef.gz
write_sdf -min_view func_tt_io -typ_view func_tt_io -max_view func_tt_io -recompute_delay_calc ../my_soc_top/outputs/manual_final/my_soc_top_tt_io.sdf.gz
if {[info exists eda_enable_pvt] && $eda_enable_pvt} {
    write_sdf -min_view func_ffm40_io -typ_view func_tt_io -max_view func_ss_io -recompute_delay_calc ../my_soc_top/outputs/manual_final/my_soc_top_pvt.sdf.gz
}
```

`006_34_5_tcl.tcl`

```tcl
# Actual sourced body; main SRAM resolved to i_mainmem/i_sram/i_macro
# Current antenna report: ../my_soc_top/my_soc_top_postAntennaFix_antenna.rpt
write_lef_abstract -5.8 -cutObsMinSpacing -specifyTopLayer METAL6 ../my_soc_top/outputs/manual_final/my_soc_top.lef
setStreamOutMode -labelAllPinShape true -virtualConnection false
if {[llength $gds_list] != 4} {error "Expected four native GDS inputs"}
foreach g $gds_list {if {![file exists $g]} {error "Missing native GDS: $g"}; puts "NATIVE_GDS $g"}
if {![file exists $rm_lef_layer_map]} {error "Missing GDS map"}
streamOut ../my_soc_top/outputs/manual_final/my_soc_top.gds.gz -mapFile $rm_lef_layer_map -merge $gds_list -mode ALL -units 2000
```

`007_34_picture.tcl`

```tcl
# Actual sourced body; main SRAM resolved to i_mainmem/i_sram/i_macro
# Current antenna report: ../my_soc_top/my_soc_top_postAntennaFix_antenna.rpt
eda_picture 34_final_layout.gif
```

**本轮结果：** 步骤命令与对应自动检查已通过；详见`step_34.json`，独立验收范围以该JSON为准。

```json
{
  "step": 34,
  "commands_completed": true,
  "input_manifest_sha256": "c1b350a1f2550de2e21af03963a3450d3a6ad885f83b8e2bc00b99558cf63f6d",
  "automatic_checks": {
    "actual_rc_temperatures_C": {
      "tt_1p80v_25c": 25,
      "ss_pvt": 125,
      "ff0_pvt": 0,
      "ffm40_pvt": -40
    },
    "exports": {
      "independent_foundry_DRC_LVS_executed": false,
      "SDF_simulation_executed": false,
      "def_pins": {
        "ports": [
          "VDD",
          "VDDPST",
          "VSS",
          "VSSPST",
          "clk_i",
          "rst_ni",
          "tck_i",
          "td_i",
          "td_o",
          "tms_i"
        ],
        "dbu_per_um": 2000,
        "all_rectangles_directions_uses_match_geometry_plan": true
      },
      "whole_die_area_mm2": 3.7956390976,
      "max_whole_die_area_mm2": 3.8,
      "sdf_non_top_instances_matched": 68808,
      "spef_networks": 74944,
      "gds_structures": 667,
      "gds_undefined_references": [],
      "scope": "Structural correspondence only; not equivalence, foundry DRC/LVS, IR/EM/ESD or actual SDF backannotation"
    }
  },
  "scope": "Only the listed automatic checks are asserted. Tcl guards also check object counts, IO geometry and halo. Not complete signoff."
}
```
