ChipDesign111/chip_design/eda/results/sram_reset_20261027/逐步运行报告.md

# 本轮EDA运行记录

工程：`/home/s2400011041/Desktop/fullstack_chipdesign/uploads/20261026_214621_5191064/work`

配置与源身份：见input_manifest.json、source.json和preparation.json。

本流程不运行功能仿真；EDA结果与独立工艺签核的范围分别说明。

## Genus输入、展开、综合与交接

输入清单有76份RTL；主存选择与源身份见preparation.json。

**G1：完整综合已包含展开，未另跑独立展开检查。**

**G2 综合执行：**

```json
{
  "commands_completed": true,
  "check_design_review_required": true,
  "scope": "Fresh tool execution, not functional equivalence or physical signoff"
}
```

**G3 综合面积与映射结果：**

```json
{
  "cell_count": 58729,
  "cell_area_um2": 1897147.501,
  "net_area_um2": 658806.192,
  "latch_area_um2": 0.0,
  "memory_area_um2": 401443.591,
  "report": "/home/s2400011041/Desktop/fullstack_chipdesign/uploads/20261026_214621_5191064/work/syn/my_soc_top/reports/area/area.rpt",
  "mapped_design": {
    "native_main_srams": 1,
    "mapped_leaf_instances": 58729,
    "all_leaf_types_have_library_models": true,
    "npu_dma_area_hierarchy_present": true,
    "latch_area_um2": 0
  }
}
```

**G4 新面积与后端规划：**

```json
{
  "cell_count": 58729,
  "cell_area_um2": 1897147.501,
  "net_area_um2": 658806.192,
  "latch_area_um2": 0.0,
  "memory_area_um2": 401443.591,
  "report": "/home/s2400011041/Desktop/fullstack_chipdesign/uploads/20261026_214621_5191064/work/syn/my_soc_top/reports/area/area.rpt",
  "planning_pass": true,
  "required_core_area_um2": 2230278.389867647,
  "planned_whole_die_area_mm2": 3.794704,
  "max_whole_die_area_mm2": 3.8,
  "standard_cell_area_estimate_um2": 1495703.91025,
  "reserved_macro_halo_um2": 470626.73075000005,
  "target_utilization": 0.85,
  "core_size_um": 1648,
  "planning_only_not_timing_or_IR_proof": true
}
```

## 01 导入新门级设计

**做什么：** 读入新版SoC网表、库外形与时间模型，并查找唯一主SRAM。

**为什么：** 网表只写连接，库资料才给出实际器件；先排除旧网表、缺模型和选错宏。

**预期效果：** 设计名my_soc_top，主SRAM恰好一个，记录综合后真实实例路径。

**关键参数：** 顶层固定为my_soc_top，宏型号固定RA1SHD_2048x32M8；实例名从当前数据库查询，不照搬旧层次路径。

**本轮实际执行片段：** 下列是运行时保存的Tcl正文；宏路径已解析，其他变量结合配置与日志阅读。

`001_01_tcl.tcl`

```tcl
# Actual sourced body; main SRAM resolved to i_mainmem/i_sram/i_macro
dbGet top.name
dbGet top.insts.cell.name RA1SHD_2048x32M8

dbGet [dbGet top.insts.cell.name RA1SHD_2048x32M8 -p2].name
dbGet head.sites.name
```

**本轮结果：** 步骤命令与对应自动检查已通过；详见`step_01.json`，独立验收范围以该JSON为准。

```json
{
  "step": 1,
  "commands_completed": true,
  "input_manifest_sha256": "daf0fa6d68fdfeee8614d3984d1ba78002df4e9683ab9a7b0a2cfb1bf7e98810",
  "automatic_checks": {
    "native_sram_resolved": true
  },
  "scope": "Only the listed automatic checks are asserted. Tcl guards also check object counts, IO geometry and halo. Not complete signoff."
}
```

## 02 确定核心与裸片尺寸

**做什么：** 根据新综合面积和目标放置密度估算核心，再由工具建立合法行网格。

**为什么：** 面积目标约束含 PAD 的整个 Die；先用当前综合结果核对核心空间，不能照搬旧大尺寸或仅缩小边框。

**预期效果：** 生成floorplan_plan.json与geometry.json，后续外围统一使用实际Die尺寸。

**关键参数：** 当前请求 core 1648 μm、四侧余量150 μm、目标利用率0.85；实际网格对齐后整个 Die 必须≤3.8 mm²。core_size_um为空时自动估算，但仍受整颗面积上限保护。

**本轮实际执行片段：** 下列是运行时保存的Tcl正文；宏路径已解析，其他变量结合配置与日志阅读。

`001_02_tcl.tcl`

```tcl
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
