ChipDesign111/chip_design/eda/results/postsim_20261026/reset_window_verification.md

# 复位窗口 timing check 对照复仿

## 结果

同一个 VCS 可执行文件、固件和 SDF，分别执行两次完整 SoC 后仿：

| 运行 | timing check 控制 | 动态违例 | 功能自检 | 退出码 |
| --- | --- | ---: | --- | ---: |
| control | 全程启用消息与 notifier | 14 | SDF_POSTSIM PASS cycles=3659 | 0 |
| reset_window | 只在初始复位稳定窗口和最终复位阶段关闭消息与 notifier | 0（启用窗口内） | SDF_POSTSIM PASS cycles=3659 | 0 |

时序检查启用窗口是 **300 ns 至 238502 ns（238.502 µs）**。它包含固件加载、启动保护测试、CPU 启动、DMA 与 INT8 自检。两次运行的结束时间均为 238900 ns。没有重新综合、改动网表、修改时钟周期、添加 false path 或使用全程 +notimingchecks。

## 屏蔽范围与证据

使用 VCS UCLI 原生 `tcheck` 命令，递归控制 `tb_soc.dut`：`-msg` 控制报告，`-xgen` 控制 notifier。关闭二者意味着这些窗口中的违例不会报告或传播 X，并不是电路中的违例被修好了。
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
