ChipDesign111/chip_design/eda/results/int22_20261104/final_layout.gif

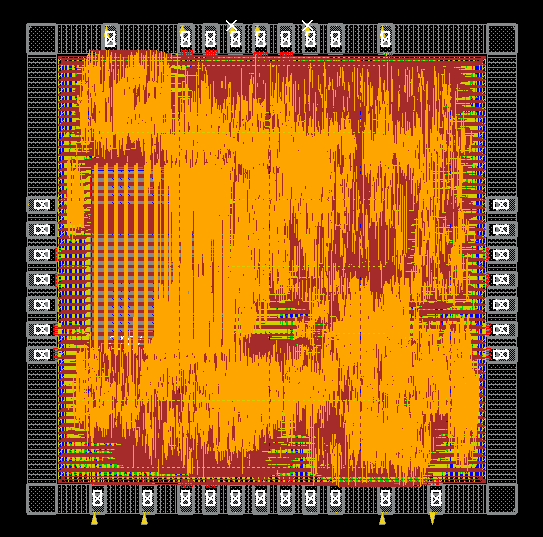
eda/results/int22_20261104/final_layout.gif
