ChipDesign111/chip_design/eda/results/sram_reset_20261027/final_layout.gif

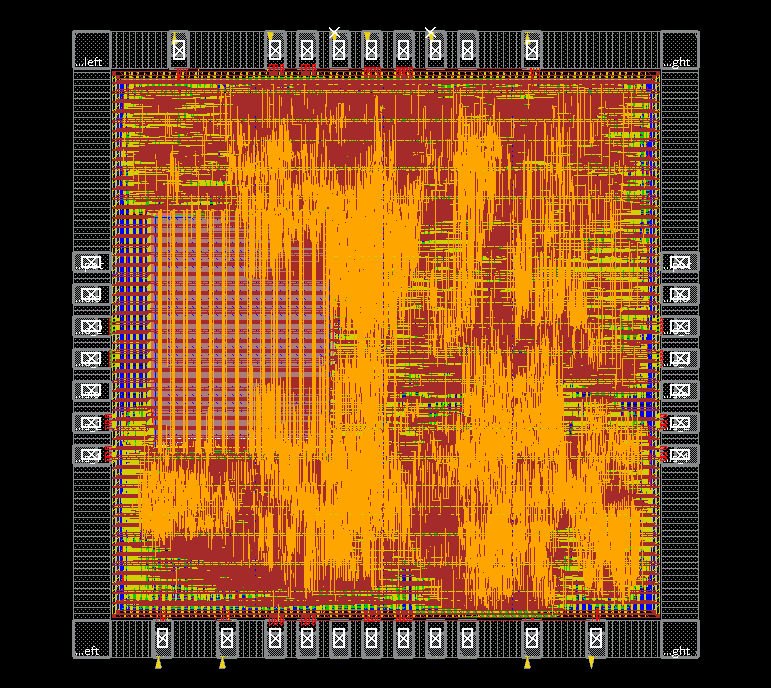
eda/results/sram_reset_20261027/final_layout.gif
