ChipDesign111/chip_design/rtl/npu/har_npu_core.sv

// INT8 64->32->6 with up to four register-resident samples, a shared 16-MAC
// bank, INT22 internal accumulation, and a pipelined requantization path.
// Each weight tile is reused for every sample and all compute phases before
// it is released.
module har_npu_core (
    input logic clk,rst_ni,start,ack_done,
    input logic [3:0] batch_count,
    input logic abort_i,
    input logic [4095:0] input_features,
    input logic [31:0][21:0] bias1,
    input logic [5:0][21:0] bias2,
    input logic [15:0] requant_mult,
    input logic [4:0] requant_shift,
    input logic tile_valid_i,tile_next_valid_i,
    input logic [511:0] tile_data_i,
    input logic dma_read_i,dma_write_i,
    output wire layer_o,
    output logic [4:0] tile_index_o,
    output wire tile_consumed_o,
    output logic busy,done,
    output wire [2047:0] hidden_all,
    output wire [1535:0] scores_all,
    output wire [23:0] class_all,
    output logic [31:0] cycle_count,overlap_count,fc1_cycles,fc2_cycles,
    output logic [31:0] read_overlap_count,write_overlap_count
);
    localparam [2:0] IDLE=0,WAIT_TILE=1,ISSUE=2,QDRAIN=3,QUANT=4,FINISH=5;
    localparam int MAX_BATCH=4;
    localparam int FC1_TILES=32;
    localparam int FC2_GROUPS=4;
    localparam int FC1_PHASES=4;
    localparam int FC2_PHASES=4;
    localparam int ACC_WIDTH=22;
    logic [2:0] state;
    logic layer;
    logic [1:0] phase;
    logic [3:0] batch_q;
    logic [2:0] sample,quant_sample,finish_sample;
    wire product_valid;
    wire [2:0] product_sample;
    // FC1 uses 8 outputs by 2 lanes per phase. FC2 uses 2 input rows by
    // 6 outputs per phase. All phases reuse the same 16-multiplier bank.
    logic signed [15:0] product[0:15];
    logic signed [ACC_WIDTH-1:0] a1[0:MAX_BATCH-1][0:31],a2[0:MAX_BATCH-1][0:5];
    logic [255:0] h[0:MAX_BATCH-1];
    // Preload the two selected FC1 input bytes for every sample at a tile
    // boundary.  This keeps the 32-way tile decode out of the MAC/CSA cone.
    logic [7:0] x_lane_q[0:MAX_BATCH-1][0:1];
    logic [1:0] fc2_group_q;
    // Keep one local flag per output lane.  Synthesis must not merge these
    // equivalent flops back into one net with hundreds of loads.
    logic [31:0] first_tile_q;
    logic [2:0] class_id_q[0:MAX_BATCH-1];
    logic signed [ACC_WIDTH-1:0] finish_best_q;
    logic [2:0] finish_compare_index,finish_class_q;
    logic signed [ACC_WIDTH-1:0] quant_group_q[0:7],quant_value_q;
    logic quant_group_valid_q,quant_value_valid_q,quant_drain_q;
    logic [2:0] quant_group_sample_q,quant_value_sample_q;
    logic [4:0] quant_group_index_q,quant_value_index_q;
    wire issue=state==ISSUE;
    wire last_sample_issue=issue && sample==batch_q[2:0]-1'b1;
    wire final_tile_phase=layer ? phase==FC2_PHASES-1 : phase==FC1_PHASES-1;
    wire last_phase_issue=last_sample_issue && final_tile_phase;
    wire [255:0] hs=h[sample];
    wire [4:0] next_tile_index=tile_index_o+5'd1;
    wire has_next_tile=layer ? tile_index_o!=FC2_GROUPS-1 : tile_index_o!=FC1_TILES-1;
    wire prepare_current_tile=state==WAIT_TILE && tile_valid_i;
    wire prepare_next_tile=last_phase_issue && has_next_tile;
    wire signed [ACC_WIDTH-1:0] finish_score=a2[finish_sample][finish_compare_index];
    // The last FC2 ISSUE may still update class 0 on the edge entering FINISH
    // (batch=1). Seed the first comparison from the committed accumulator.
    wire signed [ACC_WIDTH-1:0] finish_best_current=
        finish_compare_index==1 ? a2[finish_sample][0] : finish_best_q;
    wire finish_take=finish_score>finish_best_current;
    wire signed [ACC_WIDTH-1:0] finish_best_next=finish_take ? finish_score : finish_best_current;
    wire [2:0] finish_class_next=finish_take ? finish_compare_index : finish_class_q;
    assign layer_o=layer;
    // Release the current bank on its final use, then either hand off to an
    // already-ready bank without a bubble or wait only for a real prefetch.
    assign tile_consumed_o=last_phase_issue;
    assign product_valid=issue;
    assign product_sample=sample;

    genvar gs,go;
    generate
        for(gs=0;gs<8;gs=gs+1) begin: output_views
            if(gs<MAX_BATCH) begin: active_output
                assign hidden_all[gs*256+:256]=h[gs];
                assign class_all[gs*3+:3]=class_id_q[gs];
                for(go=0;go<6;go=go+1) begin: score_views
                    assign scores_all[gs*192+go*32+:32]=
                        {{(32-ACC_WIDTH){a2[gs][go][ACC_WIDTH-1]}},a2[gs][go]};
                end
            end else begin: zero_output
                assign hidden_all[gs*256+:256]='0;
                assign class_all[gs*3+:3]='0;
                for(go=0;go<6;go=go+1) begin: score_views
                    assign scores_all[gs*192+go*32+:32]='0;
                end
            end
        end
    endgenerate

    // Bias fields remain 32-bit MMIO words, but only their signed 22-bit
    // accumulation value participates in the datapath.
    function automatic logic signed [ACC_WIDTH-1:0] extend_product(
        input logic signed [15:0] value);
        extend_product={{ (ACC_WIDTH-16){value[15]}},value};
    endfunction

    // One shared requantizer; 22-bit positive accumulator times UINT16.
    function automatic [7:0] quant(input logic signed [ACC_WIDTH-1:0] v);
        logic [37:0] scaled;
        logic [37:0] unsigned_v;
        begin
            scaled=0;
            unsigned_v=0;
            if(v>0) begin
                unsigned_v={{ (38-ACC_WIDTH){1'b0}},$unsigned(v)};
                scaled=unsigned_v*{{ (38-16){1'b0}},requant_mult};
                if(requant_shift!=0)
                    scaled=(scaled+(38'd1<<(requant_shift-1)))>>requant_shift;
            end
            quant=scaled>127 ? 8'd127:scaled[7:0];
        end
    endfunction

    integer o,s;
    genvar j,k;
    // FC1 phase selects one set of 8 output accumulators. FC2 phase selects
    // two packed six-byte rows; only its first twelve product lanes are active.
    generate
        for(j=0;j<8;j=j+1) begin: shared_products
            for(k=0;k<2;k=k+1) begin: lanes
                localparam int P=j*2+k;
                localparam int W2_ROW=P/6;
                if(P<12) begin: fc2_active
                    assign product[P]=layer ?
                        $signed(hs[(fc2_group_q*8+phase*2+W2_ROW)*8+:8])*
                            $signed(tile_data_i[(phase*12+P)*8+:8]) :
                        $signed(x_lane_q[product_sample][k])*
                            $signed(tile_data_i[(phase*8+j)*16+k*8+:8]);
                end else begin: fc2_idle
                    assign product[P]=layer ? 16'sd0 :
                        $signed(x_lane_q[product_sample][k])*
                        $signed(tile_data_i[(phase*8+j)*16+k*8+:8]);
                end
            end
        end
    endgenerate

    always_ff @(posedge clk or negedge rst_ni) begin
        if(!rst_ni) begin
            state<=IDLE;
            busy<=0;
            done<=0;
            layer<=0;
            batch_q<=1;
            sample<=0;
            phase<=0;
            quant_group_valid_q<=0;
            quant_value_valid_q<=0;
            quant_drain_q<=0;
            quant_group_sample_q<=0;
            quant_value_sample_q<=0;
            quant_group_index_q<=0;
            quant_value_index_q<=0;
            finish_sample<=0;
            finish_compare_index<=1;
            finish_class_q<=0;
            finish_best_q<=0;
            tile_index_o<=0;
            fc2_group_q<=0;
            first_tile_q<='0;
            quant_sample<=0;
            class_id_q[0]<=0;class_id_q[1]<=0;class_id_q[2]<=0;class_id_q[3]<=0;
            cycle_count<=0;
            overlap_count<=0;
            read_overlap_count<=0;
            write_overlap_count<=0;
            fc1_cycles<=0;
            fc2_cycles<=0;
            for(s=0;s<MAX_BATCH;s=s+1) begin
                h[s]<=0;
                x_lane_q[s][0]<=0;
                x_lane_q[s][1]<=0;
                for(o=0;o<32;o=o+1) a1[s][o]<=0;
                for(o=0;o<6;o=o+1) a2[s][o]<=0;
            end
        end else begin
            if(busy) cycle_count<=cycle_count+1'b1;
            // Tile metadata and FC1 operands are ready before ISSUE starts.
            // A ready-bank handoff preloads the following tile in the final
            // ISSUE cycle, so this register boundary adds no compute bubble.
            if(prepare_current_tile) begin
                fc2_group_q<=tile_index_o[1:0];
                for(o=0;o<32;o=o+1)
                    first_tile_q[o]<=tile_index_o==0;
                if(!layer)
                    for(s=0;s<MAX_BATCH;s=s+1)
                        for(o=0;o<2;o=o+1)
                            x_lane_q[s][o]<=
                                input_features[s*512+tile_index_o*16+o*8+:8];
            end else if(prepare_next_tile) begin
                fc2_group_q<=next_tile_index[1:0];
                first_tile_q<='0;
                if(!layer)
                    for(s=0;s<MAX_BATCH;s=s+1)
                        for(o=0;o<2;o=o+1)
                            x_lane_q[s][o]<=
                                input_features[s*512+next_tile_index*16+o*8+:8];
            end
            if(product_valid) begin
                if(dma_read_i || dma_write_i) overlap_count<=overlap_count+1'b1;
                if(dma_read_i) read_overlap_count<=read_overlap_count+1'b1;
                if(dma_write_i) write_overlap_count<=write_overlap_count+1'b1;
                if(!layer) begin
                    fc1_cycles<=fc1_cycles+1'b1;
                    for(o=0;o<8;o=o+1)
                        a1[product_sample][phase*8+o] <=
                            (first_tile_q[phase*8+o] ?
                                $signed(bias1[phase*8+o]):
                                a1[product_sample][phase*8+o])
                            + extend_product(product[o*2])
                            + extend_product(product[o*2+1]);
                end else begin
                    fc2_cycles<=fc2_cycles+1'b1;
                    for(o=0;o<6;o=o+1)
                        a2[product_sample][o] <=
                            (first_tile_q[o] && phase==0 ?
                                $signed(bias2[o]):
                                a2[product_sample][o])
                            + extend_product(product[o])
                            + extend_product(product[6+o]);
                end
            end
            quant_group_valid_q<=state==QUANT;
            if(state==QUANT) begin
                quant_group_sample_q<=quant_sample;
                quant_group_index_q<=tile_index_o;
                for(o=0;o<8;o=o+1)
                    quant_group_q[o]<=a1[quant_sample][tile_index_o[4:3]*8+o];
            end
            quant_value_valid_q<=quant_group_valid_q;
            if(quant_group_valid_q) begin
                quant_value_q<=quant_group_q[quant_group_index_q[2:0]];
                quant_value_sample_q<=quant_group_sample_q;
                quant_value_index_q<=quant_group_index_q;
            end
            if(quant_value_valid_q)
                h[quant_value_sample_q][quant_value_index_q*8+:8]<=quant(quant_value_q);
            case(state)
                IDLE:if(start) begin
                    busy<=1;
                    done<=0;
                    layer<=0;
                    batch_q<=batch_count;
                    sample<=0;
                    phase<=0;
                    quant_group_valid_q<=0;
                    quant_value_valid_q<=0;
                    quant_drain_q<=0;
                    finish_sample<=0;
                    finish_compare_index<=1;
                    finish_class_q<=0;
                    finish_best_q<=0;
                    tile_index_o<=0;
                    fc2_group_q<=0;
                    first_tile_q<='0;
                    state<=WAIT_TILE;
                    cycle_count<=0;
                    overlap_count<=0;
                    read_overlap_count<=0;
                    write_overlap_count<=0;
                    fc1_cycles<=0;
                    fc2_cycles<=0;
                    class_id_q[0]<=0;class_id_q[1]<=0;class_id_q[2]<=0;class_id_q[3]<=0;
                    for(s=0;s<MAX_BATCH;s=s+1) h[s]<=0;
                end else if(ack_done) done<=0;
                WAIT_TILE:if(tile_valid_i) begin
                    sample<=0;
                    phase<=0;
                    state<=ISSUE;
                end
                ISSUE:if(last_sample_issue) begin
                    if(!final_tile_phase) begin
                        phase<=phase+1'b1;
                        sample<=0;
                    end else if(tile_index_o==FC1_TILES-1 && !layer) begin
                        quant_sample<=0;
                        tile_index_o<=0;
                        state<=QUANT;
                    end else if(layer && tile_index_o==FC2_GROUPS-1) begin
                        finish_sample<=0;
                        finish_compare_index<=1;
                        finish_class_q<=0;
                        finish_best_q<=a2[0][0];
                        state<=FINISH;
                    end else begin
                        phase<=0;
                        tile_index_o<=next_tile_index;
                        sample<=0;
                        state<=tile_next_valid_i ? ISSUE:WAIT_TILE;
                    end
                end else sample<=sample+1'b1;
                QUANT:begin
                    if(tile_index_o==31) begin
                        if(quant_sample!=batch_q[2:0]-1'b1) begin
                            quant_sample<=quant_sample+1'b1;
                            tile_index_o<=0;
                        end else begin
                            quant_drain_q<=0;
                            state<=QDRAIN;
                        end
                    end else begin
                        tile_index_o<=tile_index_o+1'b1;
                    end
                end
                QDRAIN:begin
                    if(quant_drain_q) begin
                        quant_drain_q<=0;
                        layer<=1;
                        tile_index_o<=0;
                        phase<=0;
                        state<=WAIT_TILE;
                    end else begin
                        quant_drain_q<=1;
                    end
                end
                FINISH:begin
                    if(finish_compare_index==5) begin
                        class_id_q[finish_sample]<=finish_take ? 3'd5 : finish_class_q;
                        if(finish_sample==batch_q[2:0]-1'b1) begin
                            busy<=0;
                            done<=1;
                            state<=IDLE;
                        end else begin
                            finish_sample<=finish_sample+1'b1;
                            finish_compare_index<=1;
                            finish_class_q<=0;
                            finish_best_q<=a2[finish_sample+1'b1][0];
                        end
                    end else begin
                        finish_best_q<=finish_best_next;
                        finish_class_q<=finish_class_next;
                        finish_compare_index<=finish_compare_index+1'b1;
                    end
                end
                default:state<=IDLE;
            endcase
            if(abort_i && busy) begin
                state<=IDLE;
                busy<=0;
                done<=1;
                quant_group_valid_q<=0;
                quant_value_valid_q<=0;
                quant_drain_q<=0;
            end
        end
    end
endmodule
