ChipDesign111/chip_design/(commit log)

2026-10-15 refactor: organize current SoC into seven project directories
2026-10-15 feat(dma): add burst model loading and matched SoC benchmarks
2026-10-22 perf(fpga): use runtime-optimized synthesis flow
2026-10-22 Implement INT8 tile DMA SoC with guarded boot and isolated EDA deployment
2026-10-22 Align physical-step explanations with whole-die area limit
2026-10-22 Verify whole-die limit in export and retrieval and explain tiled dataflow
2026-10-22 Reduce crossbar and MAC register area and apply corrected 4mm2 die limit
2026-10-22 Trim redundant PG wire stubs and record measured 3.9856mm2 implementation
2026-10-22 Defer PG trimming until final fill and repair measured post-antenna DRC
2026-10-23 Target 85 percent planning utilization and a whole die within 3.8mm2
2026-10-26 Sequence external PAD drivers and retain matched time-zero startup control
2026-10-27 Reserve optimization density for hold repairs by stage
2026-10-27 Verify native RC temperatures and coordinate post-route timing repair
2026-10-27 feat(npu): support eight-sample register batches
2026-10-28 chore(fpga): capture current A7 project configuration
2026-10-28 feat(npu): pipeline multiply and accumulate stages
2026-10-28 Revert "feat(npu): pipeline multiply and accumulate stages"
    This reverts commit b795ff1d1c3eab78d5ca2d7883c9db083a3c25e3.
2026-10-29 fix(eda): reserve antenna loads during native fanout optimization
2026-10-29 docs(eda): record fresh antenna-budget implementation deployment
2026-10-29 fix(eda): prefer antenna jumping with checked native diode fallback
2026-10-29 docs(fpga): add board test report
2026-10-30 docs(fpga): record rtl-dev board validation
2026-10-30 docs(fpga): record completed board regressions
2026-10-30 docs(fpga): complete LED status validation
2026-10-30 test(fpga): add INT8 board image matrix
2026-10-30 chore(fpga): finalize JTAG image loading flow
2026-10-30 docs(fpga): rewrite board test workflow
2026-10-30 docs(fpga): complete UCI board validation
2026-11-01 docs(fpga): record T08 board completion
2026-11-02 perf(npu): pipeline the requantization path
    Revert the ineffective MAC product pipeline and split FC1 requantization into sample/group selection, 8:1 selection and 32x16 multiply/saturation stages. Functional and cycle regression remain pending.
2026-11-02 docs(validation): record requant pipeline regression
    Record 38/38 functional and full-SoC ModelSim pass, Batch 1/2/4 timing and the cycle impact of the three-stage FC1 requantization path.
2026-11-02 fix(soc): register AXI slave address channels
    Use CUT_SLV_AX to cut the remaining CPU-to-NPU MMIO address/control path after requantization pipelining. Functional and cycle regression remain pending.
2026-11-02 docs(validation): record AXI address channel regression
    Record functional/ModelSim pass, current RTL identity and the 6337-cycle full-SoC total after CUT_SLV_AX.
2026-11-09 perf(soc): preserve unrelated instruction lines and shorten DMA completion
2026-11-12 Add full-flow selector and increase legal M6 dummy pattern coverage
2026-11-12 Document verified Lab5 results and remaining original Wire Bond violations
2026-11-12 Enforce native Wire Bond clearance for regular routing around all bond pads
2026-11-12 Report course-qualified Lab5 stage outcomes and fresh synthesis evidence
2026-11-12 build: refresh fanout drivers from live database
2026-11-12 build: normalize fanout pin names from Innovus
2026-11-12 build: fully unwrap nested Innovus pin names
2026-11-12 build: allow antenna sinks to follow fanout ECO
2026-11-12 build: track selected fanout sinks by exact pin name
2026-11-13 Retry transient read-only status failures without restarting EDA stages
2026-11-13 Record verified unified-reset TT and Wire Bond final results
